ScoreForever/ChipDesign/hardware/asic/flow/README.md

# ASIC implementation flow

This directory contains the course-server TSMC 180 nm Genus, Innovus, and
Xcelium flow used for ASIC synthesis, place-and-route, and post-layout
simulation.

## Flow stages

1. Configure the PDK, standard-cell libraries, SRAM macro views, and project
   root in `config/`.
2. Synthesize `my_soc_top` with the Genus script in
   `hardware/soc/synth/scripts/synth_genus.tcl`. The mapped ASIC build selects
   two course SRAM macro instances with `NPU_USE_RA1SHD_MODEL` and
   `NPU_USE_RA1SHD_ACTIVATION` when `EDA_NPU_MODEL_SRAM=1`.
3. In a fresh Innovus session, source `pnr/scripts/init_pnr.tcl`, then run the
   floorplan/IO, power/placement, and CTS/route/export stages in order.
4. For the programmable NPU gate-level regression, use the
   [ASIC optimization flow](../optimize/README.md) and its `postlayout.py` entry point.

The checked-in lab4 floorplan/power scripts retain the historical single
`i_mainmem_i_mainmem` placement and power connection. They require adaptation
before use with the current CPU-less dual-SRAM design: place and power both
`i_control/i_model_store/i_sram` and `i_control/i_activation/i_sram`, using the
matching macro LEF/GDS and current netlist. These templates are not a validated
dual-macro PnR handoff. The 2 by 2 mm die target is an architecture estimate,
not a strict post-EDA area acceptance threshold for this change.

## Environment

The flow requires the course TSMC 180 nm PDK, IO library, SRAM timing/physical
views, and licensed Genus, Innovus, and Xcelium installations. These external
files are not included in the repository. Set `CHIPDESIGN_PROJECT_ROOT` when
the source checkout is staged outside the default relative location.

The scripts provide a reproducible course flow, not foundry signoff by
themselves. Review the target RTL revision, constraints, tool configuration,
and resulting DRC/LVS, multi-corner STA, IR/EM, DFT, and post-layout simulation
evidence before making a tapeout decision. A main-aligned historical baseline
report is available on the
[EDA results branch](https://github.com/ScoreForever/ChipDesign/blob/eda-results-main-align-20261021/POSTLAYOUT_METRICS_BASELINE_MAIN_ALIGN.md).
