ScoreForever/ChipDesign/output/npu-bottlenecks/20261108/findings.md

计数器13/14/15为优先级互斥的激活/权重/结果槽等待。它们与 issue、prepare 可分解 MAC 调度周期；model/activation wait-response、stall 等接口计数跨级重叠，禁止求和为总等待。逻辑 MAC 含卷积 padding 零值，不等于非零乘加数。PE为当前 ABI5 的4bit权重/激活格式，历史图片INT8标注不能用于解释现有实现。

结论：K8/1024点写回槽等待77.8%，与同逻辑MAC量K256/32点相差2.94倍；单点K1024权重等待79.8%。128层17元素ReLU链精确C=N²+113N；GTSRB首层激活等待51457周期占总模型40.1%。tile8使七模型慢20.9–53.4%。详细设计优先级见README。
