ScoreForever/ChipDesign/output/npu-timing/20261109/peek_summary.md

# EGo1 build summary

Result: PASS
Stage: complete; last completed stage: write_bitstream
Part: xc7a35tcsg324-1; top: fpga_top; CPU-less JTAG controller and programmable five-operator NPU
Clocking Wizard: 100 MHz input, 50 MHz output, locked enabled, reset disabled
Log: vivado.log

## Resources (latest available stage)

| Resource | Used | Available | Utilization (%) |
|---|---:|---:|---:|
| Slice LUTs | 18425 | 20800 | 88.58 |
| Slice Registers | 7466 | 41600 | 17.95 |
| Block RAM Tile | 4 | 50 | 8.00 |
| DSPs | 20 | 90 | 22.22 |
| MMCME2_ADV | 1 | 5 | 20.00 |

## Timing (latest available stage)

WNS: 0.533 ns; TNS: 0.000 ns; WHS: 0.028 ns

## Main SRAM mapping

N/A: CPU-less system uses NPU-local storage; no main SRAM

## Configuration/BRAM DRC

PASS at route: CFGBVS-1, REQP-1839, RBOR-1

## JTAG clock routing

Not applied
