ScoreForever/ChipDesign/docs/kws_tinycnn8_tiled/README.md

# TinyCNN-8 新阶段汇报材料

> 2026-10-14：本文保留对应阶段记录，不作为当前main的完整实现/验收说明。
> 此前GAP/Flat接口差异已由PR #5恢复Flat解决，最新架构见 [ARCHITECTURE.md](../ARCHITECTURE.md)；最新FPGA结果见 [FPGA_DRC_CLOSURE.md](../FPGA_DRC_CLOSURE.md)。

[成果与trade-off](REPORT.md) · [个人设计思考](THOUGHTS.md) · [五分钟讲稿](TALK.md)

图表和摘要来自通过完整验收的实测，不接受skip-units smoke。完整生成证据保留本地或CI artifacts。
