ScoreForever/ChipDesign/docs/tools/int4_v2_report_head.md

# INT4 无 CPU NPU v2：算子扩展、真实模型、架构探索与 ASIC 实现

分支 `feature/int4-v2`。本文由 `docs/tools/int4_v2_report.py` 从
`docs/validation/int4_v2/` 下的结果文件生成；表中每个数字都能对应到其中一个 JSON 文件。
机器可读汇总：`docs/validation/int4_v2_summary.json`。设计过程中的中间数据（优化阶段、面积演进、布局试验）见 `docs/INT4_V2_PROCESS.md`。

## 0. 结论

- **规格**：die 含 PAD 环 ≤ 1950 µm；两颗 RA1SHD_2048x32M8（各 8 KiB），模型与激活分开；4×8 INT4 阵列；50 MHz。
- **算子**：从 5 个扩到 7 个逻辑算子（Conv 含深度可分离与 1–7 矩形核、FC、MaxPool、AvgPool/GAP、Add、ReLU、Requant），
  每类融合都能单独开关；新增 u4 无符号激活张量。
- **模型**：7 个硬件友好模型在真实数据集上做 INT4 QAT，测试集精度全部来自与硬件逐位一致的整数推理（第 2 节），
  所有模型的若干测试帧都在 RTL 上开/关融合逐位核对。
- **芯片优化**：都以模型实测为依据（第 3、5、7 节）——单次舍入 Requant、u4 激活、紧凑参数、共享建立乘法器、
  向量化 element 引擎、行填充、单行深度可分离权重、双 Requant lane、原地 Add、JTAG 突发。
- **端到端**：每次推理的时间由 JTAG 传输主导；突发协议把线上时间和主机 RPC 次数都大幅降低（第 4 节）。
- **布局与签核**：SRAM 的 109 个信号引脚都在宏底边；新增让引脚朝向逻辑区的朝向和布局，并作为物理检查项。
  最终两颗 SRAM 分在西南、东北角（`diagonal_facing`），引脚边各自面向逻辑区；利用率 70%，die 1920 µm（上限 1950），PrimeTime setup +1.094 ns / hold +0.154 ns，Calibre DRC/LVS、Formality 和 Xcelium SDF 门级仿真全过（第 6 节）。
- **FPGA**：EGo1（XC7A35T）50 MHz 实现，7 个发布模型 112 帧在实板冷 / 热共 224 次推理逐字节一致；上板时发现的两处 RTL 问题（gather 关键路径、突发错误标志的 CDC）已修复并并入最终设计（第 5 节）。

## 1. 相对 ABI 3（INT4 v1）的改动

| 类别 | 改动 | 依据 |
|---|---|---|
| 算子 | 深度可分离卷积（复用阵列，权重装载时展开成块对角） | 8 KiB 模型 SRAM 下，DS 结构是参数最省的卷积 |
| 算子 | 1–7 的矩形核，1D 卷积原生运行 | HAR/ECG 1D 模型；KWS 7×3 前端 |
| 算子 | 独立 Max/Avg 池化任意窗口/步长；GAP；融合 1×2 池化 | ECG 1D 池化（v1 直接拒绝）；GAP 头 |
| 算子 | 残差 Add（两路 8-bit 整数权重），可原地写回任一操作数 | 残差块；原地可少占一个张量 |
| 融合 | 融合开关按种类或按头算子设置，单节点可关闭；池化/Add 后可融合 Requant/ReLU | 融合消融（第 3.5 节） |
| 数值 | Requant 单次舍入（v1 舍入两次） | 第一层约 8% 输出与实数结果差 1，QAT 无法对齐 |
| 数值 | u4 无符号激活（ReLU 后 0..15） | ReLU 后有符号 INT4 只剩 3 位；QAT 对比各模型 +1–2.5 个百分点 |
| 数值 | 参数一字一通道：18-bit bias + Q8 乘数 + 6-bit 移位 | Q8 与 Q15 全测试集精度相同；参数 SRAM 减半 |
| 吞吐 | 向量化 element 引擎：一次读 8 个 nibble 更新全部通道 | Add/GAP 占 10–34% 周期 |
| 吞吐 | 单通道窄核（kw≤4）行填充：每个 K 组一次连续读 | KWS 7×3 前端 67% 周期在等激活 |
| 吞吐 | 双 Requant lane，相邻两个 nibble 合并一次写回 | 等结果槽占 KWS 周期 24% |
| 容量 | 深度可分离权重每个 tap 只存一行（v2 首版存两份） | GTSRB 模型 8228 → 7688 B |
| 主机 | JTAG 突发写/读 IR（每字一次 32-bit 扫描），主机批量 RPC | 实板每次 RPC 4 ms，逐字协议每字 ≥3 次 RPC |
| 面积 | ~20 个建立阶段乘法器改为共享一个；写回地址增量计算；保留字取指时检查 | Genus 寄存器级面积分解 |
| 布局 | SRAM 可分别设置朝向与位置；最终对角摆放（`diagonal_facing`）；引脚朝向物理检查 | 宏引脚全在一条边上，v1 摆法两颗宏都背对逻辑 |

ABI 号 0x00040000；描述符格式、参数字和 trace 版本见 `docs/CPU_LESS_CONTROL.md` 与第 8 节。
