ScoreForever/ChipDesign/output/fpga-fit/findings.md

基线 38fdd73：33,901 / 20,800 Slice LUT，UTLZ-1 阻塞布局；最差路径 d_reg[4][2] → kernel_offset_reg[15]。候选保留 8×8、128 描述符、ABI 5.0，允许增加验证与每组启动周期。
最终候选 18,196 LUT，50 MHz setup +0.014 ns、hold +0.040 ns，七个发布模型仿真周期增加 63.32% 至 114.51%。
