ScoreForever/ChipDesign/output/fpga-fit/task_plan.md

# ABI 5.0 EGo1 FPGA 上板优化
- [x] 定位资源和关键路径。
- [x] 串行化张量元数据查找和内核行地址准备。
- [x] 运行 RTL/CDC 回归及远端 Vivado 实现。
- [x] 实现和 CDC 通过后上板验证。
