ScoreForever/ChipDesign/output/week8/progress.md

# 计划准备记录

- 2026-10-30：已按四个岗位和四个工作包形成分工、5日节奏及19项人工签核模板。
- 所有执行、复核与人工签名均待开展。本次仅完成计划，不运行实验、不修改RTL、不启动EDA或FPGA构建。
