ScoreForever/ChipDesign/output/week8/task_plan.md

# 下一周工作分工（讨论执行稿）

制定日期：2026-10-30。按5个工作日安排，岗位代号待替换为姓名。本文是计划，不代表验证已经完成或人工已经签核。

## 人员与职责

| 岗位 | 主责 | 本周明确交付物 | 交叉复核 |
|---|---|---|---|
| A：EDA主责 | 低精度面积评估、ASIC签核证据审核 | INT8/W4A8面积与时序对比；ASIC人工核查记录；缺失工艺输入清单 | B复核报告与例外，C确认RTL配置 |
| B：EDA机动 | 性能瓶颈评估主责、低精度软件筛选、证据汇总 | 同一基线的分算子瓶颈报告；精度/容量对比；下一轮候选排序；总问题清单 | C复核统计语义，D核对实板一致性，A复核方案成本 |
| C：RTL主责 | 稳定基线、低精度最小原型、功能与回归维护 | 冻结源码/配置清单；独立参考对照；一个低精度候选或停止结论；CDC缺陷修复与回归 | B复核数值契约，D独立验证CDC行为，A检查综合网表 |
| D：FPGA主责 | 最新基线实板验证、CDC专项验证与接口证据 | CDC场景矩阵/scoreboard结果；Vivado CDC与I/O审计；对应镜像的实板与性能记录 | C复核协议及复位语义，A复核物理约束，B复核证据身份 |

机动岗位B有固定的性能评估交付物，不作为无人负责的公共支援池。A负责签核清单维护，B负责证据索引和未闭合问题汇总。最终放行由指定人工负责人作出，不由工具PASS自动替代。

## 工作包1：低精度可行性，不预设本周必须完成INT4整机

- 主责：C（RTL），A（面积）；B负责软件精度筛选；D仅验证通过筛选的候选。
- 优先比较W8A8与W4A8：权重先降为4bit，激活仍为8bit。W4A4先作软件敏感性评估，不同时维护多个完整硬件分支。
- 使用固定训练权重、明确来源的验证集和相同预处理，记录任务精度。合成输入只能验证数值行为，不能证明模型任务精度。
- 区分“INT4数值放在INT8容器”和真正4bit存储/乘法实现。先明确有符号范围、舍入/裁剪、scale、符号扩展、尾通道与奇数长度打包；不能直接截低4bit。
- 保持bias和Q31量化契约；累加位宽另作范围分析，不把所有数据通路随意减半。
- A先形成同工艺库、同频率、同SRAM/trace配置的面积账本：MAC、部分和/结果槽、控制、缓存/队列、量化、两颗SRAM。若工具无法逐项可靠分解，标明范围和未知项。
- 先做局部计算模块综合，再决定是否推进完整核心综合。必须报告新增打包/解包和控制成本。
- 同规格两颗SRAM宏面积不会因权重降为4bit自动减半。逻辑权重容量节省、标准单元面积节省、Die面积节省分别报告；没有新PnR不能声称释放了多少整芯片面积。
- D2决策门：人工确定可接受精度损失、面积收益目标和周期退化上限。三项阈值未定时只能报告比较结果，不宣布候选可替换INT8基线。
- 本周验收：交付可复现对比与继续/停止建议。软件精度不达标、收益不足或时序不合格时，保留负结果，不强行合入。

## 工作包2：性能瓶颈与下一轮方案

- 主责B，C解释计数器/调度，D采集对应镜像证据，A评估面积与时序代价。
- 测试集：KWS、MNIST、HAR；补充Conv/FC/独立后处理小用例与容量边界。ECG的MaxPool1D限制单列，不伪造可运行数据。
- 冻结相同源码、模型、融合配置、列数、存储实现和trace配置；冷/热运行分开记录，主机传输时间与核心计算周期分开记录。
- 收集总周期、MAC issue、等待激活/权重/结果槽、gather类型、模型/激活读事务、逻辑写回与各缓冲峰值；有逐算子trace时按层定位。
- 按当前RTL核对计数语义，历史性能文档中写端无ready等叙述不能套用当前双SRAM版。等待计数不是总周期完整划分，不能直接相加绘制总时间占比；峰值占满不等于已证明瓶颈。
- 对最重要的1项假设做定向小实验，例如权重供给、激活gather、写回背压或后处理；一次只改变一个因素。没有测量则将收益标为估计。
- 交付：主要瓶颈及证据，最多2个下一轮候选；每个包含预期收益、面积/时序成本、修改范围、风险和验证方式。低精度不自动等于性能翻倍。

## 工作包3：当前No-CPU TAP/CDC专项

- D负责测试设计、执行和实板；C负责协议复核与RTL修复；A复核约束；B独立审阅覆盖与失败日志。
- 对象是当前npu_jtag_transport的稳定负载/toggle邮箱和两域复位，不使用旧CPU Debug/DMI流程代替。
- 功能矩阵：不同频率比与初始相位；请求/应答握手临界边沿；busy时新请求/overrun；TCK停止并重启；TMS TAP复位与全局复位区别；未决命令/未决响应时复位；watchdog取消后的重新提交；连续任务。
- scoreboard检查：每个被接受请求恰好执行一次，响应匹配，无丢失/重复/混包；在途payload稳定；busy拒绝的请求不被执行。复位取消的事务按明确协议处理，不能错误要求其仍应答或允许污染新任务。
- 仿真可随机频率/相位、背压及边界时刻，但RTL仿真不能证明模拟亚稳态风险消失。同步器、复位释放、物理时序约束和例外范围必须另查。
- 实板先按已验证的100kHz与1MHz配置覆盖，并记录实际OpenOCD设置；新增速率先确认I/O预算。50MHz系统时钟与TCK独立，不将烧板功能PASS代替CDC时序审核。
- 每个修复先回归，再重建FPGA镜像并重新审核时序/CDC/I/O。不能复用旧镜像证明新RTL通过。
- 本周验收：场景矩阵、明确预期、日志/断言/scoreboard结果和未覆盖项。高风险未解释CDC问题阻止将候选标为可发布。

## 工作包4：人工签核

- A维护manual_signoff_checklist.md，B汇总证据；C、D各自完成所属项并交叉复核。
- 每项绑定源码快照、工具版本、配置、输入与原始报告，人工抽查路径/波形/实际与期望数据，不能只核对汇总PASS。
- 人工状态：未核对、通过、有条件通过、不通过、不适用。缺输入应写未核对并列缺口，不得默认为通过；不适用需要理由与复核。
- 有条件通过必须写条件、剩余风险、责任人及后续动作；重要例外保留原始数量、位置、理由与影响。
- 本周目标是完成一次人工证据复核和剩余风险分配，不承诺一周内完成所有多角/IR/EM/工艺交付签核。

## 5个工作日节奏

| 时间 | A：EDA主责 | B：EDA机动 | C：RTL | D：FPGA |
|---|---|---|---|---|
| D1 | 面积分解、库/角落可用性与签核输入盘点 | 固定模型/数据集和性能统计口径 | 冻结含本地修改的源码快照，复跑INT8基线 | 确认镜像/下载记录，完成CDC测试矩阵 |
| D2 | 局部低精度综合对比 | 软件W4精度评估、分层瓶颈采样 | 完成数值/打包契约，支持最小原型 | CDC仿真及已有速率的接口测试 |
| D3 | 有价值候选完整综合，审核例外 | 主导一次瓶颈假设实验 | CDC必要修复及定向回归，候选功能对照 | 验证修复，重建需要更新的镜像 |
| D4 | 候选时序/面积复查与人工签核 | 汇总证据、候选排序与停止理由 | 整机回归，冻结候选输入 | 实板重复/恢复与性能对照、人工核查 |
| D5 | 与全组审核ASIC风险与后续输入 | 发布总报告、未闭合问题和下一轮建议 | 交付稳定基线与候选差异 | 交付镜像身份、实板报告和CDC覆盖 |

## 周末必须可审查的交付物

- [ ] 低精度精度/容量/综合面积/时序/周期对比，继续或停止建议。
- [ ] 同一基线的主要性能瓶颈证据及最多2项下一轮候选。
- [ ] No-CPU CDC覆盖矩阵、scoreboard/断言结果与物理约束审阅。
- [ ] 四人填写并交叉复核的人工签核表，含全部未闭合项。

## Next Step

把A/B/C/D替换为姓名，并在D1确定冻结快照、任务精度阈值及最终人工放行负责人。本文未启动任何实验或修改RTL。
