ScoreForever/ChipDesign/docs/kws_tinycnn8_tiled/TALK.md

# 五分钟汇报与问答

> 2026-10-14：本文为此前调度实验记录，周期数和通过结果限定于当时的源码/参数。
> 当前main的GAP核、MMIO参数缺口及Flat软件差异见 [当前架构](../ARCHITECTURE.md)，
> 最新FPGA结构与验证记录见 [FPGA_DRC_CLOSURE.md](../FPGA_DRC_CLOSURE.md)。

**0:00–0:45 目标。** 固定KWS-TinyCNN-8，复用现有32PE阵列，研究模型定向调度而不是新增网络。
合成参数用于数值和性能验证，不报告语音识别准确率。

**0:45–1:30 发现。** C2占多数乘加；原调度对每个位置每K组都重载并等待。先做gather/load
重叠得到11.12%，但剩余等待仍很高，所以不能只继续优化数据准备。

**1:30–2:30 设计。** 改为一个空间tile共用一组权重，逐位置发射同时回收，以tag写回各自
INT32部分和。换权重必须全部退休。保持计算与量化不变；单字节读口仍限制供数。

**2:30–3:30 结果。** 图中tile16整网51,821→30,395，减少41.35%，速度比1.705×；
C2速度比3.366×。1,440输入不变，权重行5,760→360。各层golden及正式MMIO均通过。

**3:30–4:15 Trade-off。** tile16主要数据存储584B，包含512B部分和、64Btag、8Bpack。
32更快但部分和翻倍；容量不是面积，待综合验证端口/选择网络/频率。没有宣称能耗降低。

**4:15–5:00 完成度与个人工作。** 以合同、数值、协议、性能、资源预算、接口及复现作为RTL出口。
我的工作是trace驱动的选择、控制实现和证据链；团队基础不重复归功。综合/真实模型/整机是下一关。

## 问答

- **为何认为完成？** 是限定存储与模型合同下RTL阶段完成，不是芯片完成；所有出口有测试证据。
- **为何不多加PE？** 供数和重复装载先成为限制，固定资源才能隔离调度收益。
- **为什么不用32？** 测得更快但多512B部分和，频率/面积尚未知，16是有理由的初选不是全局最优。
- **真实KWS识别好吗？** 未验证；合成权重没有类别语义。
- **SoC是否全跑了？** 正式MMIO后端已测，CPU+AXI+DMA整SoC本次未跑。
- **面积/功耗改善多少？** 尚无综合/实现数据，权重流量下降不能直接换算功耗。
