ScoreForever/ChipDesign/docs/kws_tinycnn8_tiled/THOUGHTS.md

# 个人贡献与设计思考（供汇报采用）

> 2026-10-14：本文为此前调度实验记录，周期数和通过结果限定于当时的源码/参数。
> 当前main的GAP核、MMIO参数缺口及Flat软件差异见 [当前架构](../ARCHITECTURE.md)，
> 最新FPGA结构与验证记录见 [FPGA_DRC_CLOSURE.md](../FPGA_DRC_CLOSURE.md)。

这是对实际工作及设计取舍的表达，不替代团队作者记录，不声明独立完成整个NPU。

## 我的工作边界

我依赖已有Matrix/Vector、TinyCNN和SoC基础，重点负责模型定向验证、trace分析、
调度优化实验、软件可读性能指标及阶段验收证据。核心贡献不是“首次仿真”，而是
把观察、选择、实现和验证闭合起来。

## 观察—选择—代价—验证

1. **先观察，不先扩阵列。** 8输出通道匹配8列；C2占大部分计算，trace显示大量单事务等待。
   增加PE可能无法持续供数，因此先固定计算资源，研究调度。
2. **第一步选择低风险重叠。** gather/load可在独立读口下并行，已经证明11.12%整网收益，
   但装载次数不变，瓶颈转为等待。它既是成果，也揭示下一步上限。
3. **第二步选择空间复用。** 同一K组权重可服务多个位置，代价是必须保存多个INT32部分和，
   并正确关联返回结果；不能简单先发满所有输入再接输出，否则流水可能堵死。
4. **控制工作集，而非全层展开。** C2完整im2col约5760B；全层psum约2560B，Conv1全层psum10240B。
   小tile使活跃部分和有界，不代表行为存储已变成物理SRAM。
5. **不把最大tile当自动最优。** 比较8/16/32：默认16用584B主要数据存储，取得1.705×整网周期速度比。
   32更快但存储更大，最终频率/面积可能改变最佳点，留待综合。
6. **不靠改数学获得快。** bias只一次、K间INT32、最终Q31双舍入不变；三路对独立golden。
   数据/权重恰零也不扣除有效工作，防止统计口径制造收益。
7. **把性能变成软件功能。** profiler使用显式事件端口，MMIO可读，独立monitor验证；
   以后换模型或存储仍能测，而不只是本次waveform截图。
8. **用出口定义完成度。** 达到数值、协议、机制、性能、资源预算和复现门槛，称RTL阶段完成。
   不声称PPA、真实准确率或整机已完成；这不是削弱成果，而是说明工程判断的边界。

## 可以直接说的贡献摘要

“我在团队已有计算模块上建立了独立逐层验证和周期级分析流程，根据trace定位Conv2
重复装载和单事务等待，设计了有界空间复用及回收调度。保持32个PE，tile16整网周期
减少41.35%，并将性能统计接入正式MMIO。我的关注点是收益、存储/控制代价和
验证完整度，而不是把仿真数字直接当作芯片PPA。”

## 不应说

从零原创全部NPU；真实KWS精度已验证；相对CPU有1.705倍加速；584B就是面积；
固定TB时钟就是Fmax；test PASS就是所有输入形式证明；已完成同步SRAM和整SoC联调。
