ScoreForever/ChipDesign/output/npu-bottlenecks/20261108/progress.md

2026-11-08：新增 profile_bottlenecks.py，未改生产 RTL。使用 SYNTHESIS、FPGA_MEM、8列、关闭波形、启用算子摘要；tile 仅测试 RTL 支持的16和8。初版分析器错误地用物化张量表查询被融合消除的中间张量，导致 KeyError；已改用逻辑参考结果计算工作量，失败证据保留 build/bottlenecks_20261108，修正版在 build/bottlenecks_20261108_checked 运行。

完成：52组常规对照、40组极限测试共184次执行；逐写回和两次计数校验通过，七模型默认tile周期与此前实板逐次一致。新增预编译工作负载检查，避免容量/维度不支持时启动长回归。原始极限输入单维256/1024超255上限，修为同元素二维形状后全部通过。代码py_compile与git diff --check通过。生产RTL哈希在两套回归及报告生成前后核对一致，未提交。mywin再次SSH超时，本轮无新板测/时序签核。
