ScoreForever/ChipDesign/output/npu-bottlenecks/20261108/task_plan.md

# 当前 ABI 5.0、8×8 NPU 瓶颈测量

- [x] 检查计数器定义和测试入口；保持生产 RTL 不变。
- [x] 七模型和单变量工作负载测量，每例两次并检查全部写回。
- [x] 对照 tile=16/8 和融合开关，核对实板周期。
- [x] 输出瓶颈排序、时序限制、复现命令及数据范围。

远端 mywin SSH 超时，本轮使用本地生产存储配置 RTL 仿真和此前布线/实板证据。
