ScoreForever/ChipDesign/output/npu-gather/20261108/findings.md

根因：跨kernel行或padding边界的组不满足全组连续条件时，原实现逐lane读取，未利用同一返回字内的其他有效lane。现在按归一化offset相等划分连续子集，每次读后清除该子集待处理mask，下一请求选择剩余首lane。最后一个子集仍可同周期直接送MAC；完整连续组仍仅一次读。生产RTL仅core改变，其余起点未提交改动保留。

最终状态：采用checkout_forward/build/gather_forward_50mhz，首轮标准route通过（无负余量重试）；WNS+.031/WHS+.034，LUT18464/DSP12。132动态CDC+109端点复核通过，已上板14次模型及5恢复检查全过，全部24计数与生产RTL一致。GTSRB128283->95147；最终SHA535c93afe24ab10f02b424a4a8a9d6918e01d9c56165572fb84e6b82336d6350。报告README.md为最终结论；早期进行中描述由本结果取代。setup余量较旧镜像+.344小，已明确披露。
