ScoreForever/ChipDesign/output/npu-gather/20261108/progress.md

2026-11-08：4通道3x3用例起点1550周期/582请求/710激活等待；新实现1027周期/330请求/187等待，性能预算1050与读预算340通过。81程序回归、13边界专项、8直接/JTAG端到端及19组负向/生命周期检查通过；七模型生产配置重放通过。GTSRB128283->95147，其他六模型无回退。当前remote staging C:/Users/Lenovo/AppData/Local/Temp/chipdesign_nocpu_ww974e_1，远端根D:/IWS/advanced_soc/ChipDesign/build/fpga_signoff/npu_gather_20261108/checkout，build/gather_50mhz。旧VivadoGUI40204保留，本轮进程55320。

第一版初始route WNS=-0.986/WHS=+0.032，自动AggressiveExplore进行中（~-.654）。增加一个gather_last寄存器，将子集完成归约提前到请求前，避免返回到下一读请求路径；81项程序及13边界通过，所有周期/24计数逐例与第一版相同。新远端checkout_retime/build/gather_retime_50mhz，stage C:/Users/Lenovo/AppData/Local/Temp/chipdesign_nocpu_2v9ii684。第一版完整core保留chunk_core.sv，起点before_core.sv。当前工作区为retime候选，未上板。

按用户反馈转向RTL结构优化：第一版正式routePASS WNS0.000/WHS+.059/LUT18520；route路径源pool1d到held_data约25级，含next_base两段串行carry。终止已核对cmdline的retime候选PID49944、margin候选PID9388，保留日志；旧GUI40204未动。当前workspace为chunk+cursor_step[8]预计算，已去掉无效gather_last尝试。81项全部周期/24计数与第一版一致。构建入口一次在前置归档失败后错误继续，启动了未覆盖源码clone的h9ulr062/PID19284，已停止并保留失败目录gather_steps_50mhz；重试入口build_frozen.py先校验20个输入哈希才启动。正式steps构建checkout_steps/build/gather_steps_retry_50mhz，staging C:/Users/Lenovo/AppData/Local/Temp/chipdesign_nocpu_lerm0pfg，SSHsession75377。

步进表版最终routePASS WNS+.014/WHS+.039/LUT19078/DSP12；改善但余量偏紧。继续RTL并行forward：物理slot并行地址匹配，按head分段选最新nibble，避免环形data索引与8级串行overlay。独立18432组合miter旧/新均通过，强制before_head=0在head1/count8被检出；mutant源删除，日志保留。完整81程序cycles/24perf与steps逐例相等，unit含500随机mask、容量wrap/RMW/held snapshot及压力检查通过；新tb已加入run_program_regression.unit_tests。forward冻结20源已校验，checkout_forward/build/gather_forward_50mhz，stage chipdesign_nocpu_mcx2e1pc，SSH4198。后续production7/edges15/JTAG8/native18运行中。侧聊已完成96次TCK扫频并明确释放FT232H，仍须本线程路由+CDC门禁后才能上板。

最终验收完成：forward标准流程仅一次route，未触发负余量重试。50MHz WNS+.031/WHS+.034/TNS0/THS0，LUT18464/88.77%、FF7263、DSP12、BRAM4。132动态CDC及109端点复核通过，源码及bit SHA535c93afe24ab10f02b424a4a8a9d6918e01d9c56165572fb84e6b82336d6350核对后已编程EGo1（DONE1/CRC0）。恢复FT232H2-3/serial210512180081的WSL挂载及plugdev660后，14模型输出/周期/24计数与RTL完全一致、5板级CDC/恢复通过；OpenOCD正常退出，owned keepalive已到期。全部证据下载校验，当前本地构建输入与最终provenance完全一致。余量仍小于11月7日+.344，报告如实记录。未提交/推送。
