ScoreForever/ChipDesign/output/npu-timing/20261109/task_plan.md

# RTL 时序余量恢复

目标：ABI5.0、8×8保持；七模型周期不得高于当前上板值；50MHz尽量恢复WNS≥+0.344ns。时序与同镜像CDC通过后上板。

- [x] 冻结+0.031ns已上板基线并分析关键路径。
- [x] 行尾/非行尾元数据并行计算，功能与周期对照。
- [x] 隔离副本完整50MHz实现，比较实际路由余量与面积。
- [x] 同镜像CDC、上板14次模型/5恢复验证及归档。

不修改50MHz时钟约束，不通过增加逐读请求周期换时序。当前候选只改core，旧工作区改动保留。

最终选择：影子游标+完整请求metadata寄存器；WNS+.533/WHS+.028，CDC通过，板上14模型运行+5恢复检查通过，全部24计数一致。详见README.md。
