ScoreForever/ChipDesign/docs/slides/int4_v2/data/signoff.tex

Calibre DRC & \textcolor{peking_darkgreen}{通过} & 无阻塞违例；报告项均为 IO 单元内的 ESD/闩锁指导规则 \\
Calibre LVS & \textcolor{peking_darkgreen}{通过} & 网表一致；45 处 IO 电阻属性偏差（最大 3.47\%），已接受 \\
PrimeTime STA & \textcolor{peking_darkgreen}{通过} & SPEF 反标：setup +1.094 ns，hold +0.154 ns \\
Formality LEC & \textcolor{peking_darkgreen}{通过} & 布线后网表与综合网表等价 \\
Xcelium SDF gate-level & \textcolor{peking_darkgreen}{通过} & 门级 + SDF 跑通 41 条 JTAG 命令（突发 IR，覆盖全部新算子） \\
