ScoreForever/ChipDesign/docs/validation/eda_latest_20261111/reports/cdc_paths.tsv

kind | from | to | mode | arrival_ns | required_ns | slack_ns
request | i_host/req_payload_reg[0]/Q | i_host/cmd_data_o_reg[0]/D | late | 0.000 | 19.974 | 19.973
request | i_host/req_payload_reg[1]/Q | i_host/cmd_data_o_reg[1]/D | late | 0.000 | 19.977 | 19.976
request | i_host/req_payload_reg[2]/Q | i_host/cmd_data_o_reg[2]/D | late | 0.000 | 19.974 | 19.974
request | i_host/req_payload_reg[3]/Q | i_host/cmd_data_o_reg[3]/D | late | 0.001 | 19.973 | 19.972
request | i_host/req_payload_reg[4]/Q | i_host/cmd_data_o_reg[4]/D | late | 0.000 | 19.975 | 19.974
request | i_host/req_payload_reg[5]/Q | i_host/cmd_data_o_reg[5]/D | late | 0.001 | 19.970 | 19.969
request | i_host/req_payload_reg[6]/Q | i_host/cmd_data_o_reg[6]/D | late | 0.001 | 19.973 | 19.972
request | i_host/req_payload_reg[7]/Q | i_host/cmd_data_o_reg[7]/D | late | 0.000 | 19.978 | 19.978
request | i_host/req_payload_reg[8]/Q | i_host/cmd_data_o_reg[8]/D | late | 0.000 | 19.978 | 19.978
request | i_host/req_payload_reg[9]/Q | i_host/cmd_data_o_reg[9]/D | late | 0.000 | 19.970 | 19.970
request | i_host/req_payload_reg[10]/Q | i_host/cmd_data_o_reg[10]/D | late | 0.000 | 19.977 | 19.977
request | i_host/req_payload_reg[11]/Q | i_host/cmd_data_o_reg[11]/D | late | 0.000 | 19.977 | 19.977
request | i_host/req_payload_reg[12]/Q | i_host/cmd_data_o_reg[12]/D | late | 0.000 | 19.976 | 19.976
request | i_host/req_payload_reg[13]/Q | i_host/cmd_data_o_reg[13]/D | late | 0.000 | 19.972 | 19.972
request | i_host/req_payload_reg[14]/Q | i_host/cmd_data_o_reg[14]/D | late | 0.000 | 19.977 | 19.977
request | i_host/req_payload_reg[15]/Q | i_host/cmd_data_o_reg[15]/D | late | 0.001 | 19.972 | 19.971
request | i_host/req_payload_reg[16]/Q | i_host/cmd_data_o_reg[16]/D | late | 0.000 | 19.976 | 19.976
request | i_host/req_payload_reg[17]/Q | i_host/cmd_data_o_reg[17]/D | late | 0.001 | 19.973 | 19.972
request | i_host/req_payload_reg[18]/Q | i_host/cmd_data_o_reg[18]/D | late | 0.000 | 19.976 | 19.976
request | i_host/req_payload_reg[19]/Q | i_host/cmd_data_o_reg[19]/D | late | 0.001 | 19.972 | 19.971
request | i_host/req_payload_reg[20]/Q | i_host/cmd_data_o_reg[20]/D | late | 0.000 | 19.977 | 19.977
request | i_host/req_payload_reg[21]/Q | i_host/cmd_data_o_reg[21]/D | late | 0.001 | 19.972 | 19.971
request | i_host/req_payload_reg[22]/Q | i_host/cmd_data_o_reg[22]/D | late | 0.001 | 19.973 | 19.972
request | i_host/req_payload_reg[23]/Q | i_host/cmd_data_o_reg[23]/D | late | 0.000 | 19.976 | 19.976
request | i_host/req_payload_reg[24]/Q | i_host/cmd_data_o_reg[24]/D | late | 0.000 | 19.976 | 19.976
request | i_host/req_payload_reg[25]/Q | i_host/cmd_data_o_reg[25]/D | late | 0.000 | 19.975 | 19.975
request | i_host/req_payload_reg[26]/Q | i_host/cmd_data_o_reg[26]/D | late | 0.000 | 19.977 | 19.977
request | i_host/req_payload_reg[27]/Q | i_host/cmd_data_o_reg[27]/D | late | 0.001 | 19.972 | 19.971
request | i_host/req_payload_reg[28]/Q | i_host/cmd_data_o_reg[28]/D | late | 0.000 | 19.975 | 19.975
request | i_host/req_payload_reg[29]/Q | i_host/cmd_data_o_reg[29]/D | late | 0.001 | 19.974 | 19.973
request | i_host/req_payload_reg[30]/Q | i_host/cmd_data_o_reg[30]/D | late | 0.000 | 19.975 | 19.974
request | i_host/req_payload_reg[31]/Q | i_host/cmd_data_o_reg[31]/D | late | 0.000 | 19.974 | 19.973
request | i_host/req_payload_reg[32]/Q | i_host/cmd_addr_o_reg[0]/D | late | 0.001 | 19.967 | 19.967
request | i_host/req_payload_reg[33]/Q | i_host/cmd_addr_o_reg[1]/D | late | 0.000 | 19.970 | 19.970
request | i_host/req_payload_reg[34]/Q | i_host/cmd_addr_o_reg[2]/D | late | 0.001 | 19.970 | 19.970
request | i_host/req_payload_reg[35]/Q | i_host/cmd_addr_o_reg[3]/D | late | 0.000 | 19.974 | 19.974
request | i_host/req_payload_reg[36]/Q | i_host/cmd_addr_o_reg[4]/D | late | 0.001 | 19.969 | 19.968
request | i_host/req_payload_reg[37]/Q | i_host/cmd_addr_o_reg[5]/D | late | 0.000 | 19.973 | 19.972
request | i_host/req_payload_reg[38]/Q | i_host/cmd_addr_o_reg[6]/D | late | 0.001 | 19.970 | 19.969
request | i_host/req_payload_reg[39]/Q | i_host/cmd_addr_o_reg[7]/D | late | 0.001 | 19.969 | 19.968
request | i_host/req_payload_reg[40]/Q | i_host/cmd_addr_o_reg[8]/D | late | 0.001 | 19.970 | 19.969
request | i_host/req_payload_reg[41]/Q | i_host/cmd_addr_o_reg[9]/D | late | 0.001 | 19.969 | 19.968
request | i_host/req_payload_reg[42]/Q | i_host/cmd_addr_o_reg[10]/D | late | 0.001 | 19.965 | 19.964
request | i_host/req_payload_reg[43]/Q | i_host/cmd_addr_o_reg[11]/D | late | 0.001 | 19.969 | 19.968
request | i_host/req_payload_reg[44]/Q | i_host/cmd_addr_o_reg[12]/D | late | 0.001 | 19.967 | 19.966
request | i_host/req_payload_reg[45]/Q | i_host/cmd_addr_o_reg[13]/D | late | 0.001 | 19.967 | 19.967
request | i_host/req_payload_reg[46]/Q | i_host/cmd_addr_o_reg[14]/D | late | 0.001 | 19.968 | 19.967
request | i_host/req_payload_reg[47]/Q | i_host/cmd_addr_o_reg[15]/D | late | 0.001 | 19.964 | 19.963
request | i_host/req_payload_reg[48]/Q | i_host/cmd_addr_o_reg[16]/D | late | 0.001 | 19.962 | 19.961
request | i_host/req_payload_reg[49]/Q | i_host/cmd_addr_o_reg[17]/D | late | 0.001 | 19.962 | 19.961
request | i_host/req_payload_reg[50]/Q | i_host/cmd_addr_o_reg[18]/D | late | 0.002 | 19.963 | 19.960
request | i_host/req_payload_reg[51]/Q | i_host/cmd_addr_o_reg[19]/D | late | 0.001 | 19.968 | 19.967
request | i_host/req_payload_reg[52]/Q | i_host/cmd_addr_o_reg[20]/D | late | 0.001 | 19.967 | 19.966
request | i_host/req_payload_reg[53]/Q | i_host/cmd_addr_o_reg[21]/D | late | 0.001 | 19.967 | 19.967
request | i_host/req_payload_reg[54]/Q | i_host/cmd_addr_o_reg[22]/D | late | 0.001 | 19.968 | 19.967
request | i_host/req_payload_reg[55]/Q | i_host/cmd_addr_o_reg[23]/D | late | 0.000 | 19.973 | 19.972
request | i_host/req_payload_reg[56]/Q | i_host/cmd_addr_o_reg[24]/D | late | 0.000 | 19.972 | 19.972
request | i_host/req_payload_reg[57]/Q | i_host/cmd_addr_o_reg[25]/D | late | 0.000 | 19.972 | 19.972
request | i_host/req_payload_reg[58]/Q | i_host/cmd_addr_o_reg[26]/D | late | 0.000 | 19.971 | 19.971
request | i_host/req_payload_reg[59]/Q | i_host/cmd_addr_o_reg[27]/D | late | 0.001 | 19.969 | 19.969
request | i_host/req_payload_reg[60]/Q | i_host/cmd_addr_o_reg[28]/D | late | 0.001 | 19.969 | 19.969
request | i_host/req_payload_reg[61]/Q | i_host/cmd_addr_o_reg[29]/D | late | 0.000 | 19.966 | 19.966
request | i_host/req_payload_reg[62]/Q | i_host/cmd_addr_o_reg[30]/D | late | 0.001 | 19.970 | 19.969
request | i_host/req_payload_reg[63]/Q | i_host/cmd_addr_o_reg[31]/D | late | 0.001 | 19.966 | 19.965
request | i_host/req_payload_reg[64]/Q | i_host/cmd_op_o_reg[0]/D | late | 0.000 | 19.976 | 19.976
request | i_host/req_payload_reg[65]/Q | i_host/cmd_op_o_reg[1]/D | late | 0.001 | 19.967 | 19.966
request | i_host/req_payload_reg[66]/Q | i_host/cmd_op_o_reg[2]/D | late | 0.001 | 19.973 | 19.972
request | i_host/req_payload_reg[67]/Q | i_host/cmd_op_o_reg[3]/D | late | 0.000 | 19.977 | 19.977
request | i_host/req_payload_reg[68]/Q | i_host/cmd_op_o_reg[4]/D | late | 0.000 | 19.976 | 19.976
request | i_host/req_payload_reg[69]/Q | i_host/cmd_op_o_reg[5]/D | late | 0.000 | 19.974 | 19.973
request | i_host/req_payload_reg[70]/Q | i_host/cmd_op_o_reg[6]/D | late | 0.000 | 19.976 | 19.975
request | i_host/req_payload_reg[71]/Q | i_host/cmd_op_o_reg[7]/D | late | 0.000 | 19.975 | 19.975
response | i_host/rsp_mailbox_data_reg[0]/Q | i_host/reply_data_reg[0]/D | late | 0.000 | 19.979 | 19.979
response | i_host/rsp_mailbox_data_reg[1]/Q | i_host/reply_data_reg[1]/D | late | 0.000 | 19.976 | 19.976
response | i_host/rsp_mailbox_data_reg[2]/Q | i_host/reply_data_reg[2]/D | late | 0.000 | 19.978 | 19.978
response | i_host/rsp_mailbox_data_reg[3]/Q | i_host/reply_data_reg[3]/D | late | 0.000 | 19.978 | 19.978
response | i_host/rsp_mailbox_data_reg[4]/Q | i_host/reply_data_reg[4]/D | late | 0.000 | 19.979 | 19.979
response | i_host/rsp_mailbox_data_reg[5]/Q | i_host/reply_data_reg[5]/D | late | 0.000 | 19.977 | 19.976
response | i_host/rsp_mailbox_data_reg[6]/Q | i_host/reply_data_reg[6]/D | late | 0.000 | 19.978 | 19.978
response | i_host/rsp_mailbox_data_reg[7]/Q | i_host/reply_data_reg[7]/D | late | 0.000 | 19.979 | 19.978
response | i_host/rsp_mailbox_data_reg[8]/Q | i_host/reply_data_reg[8]/D | late | 0.000 | 19.979 | 19.979
response | i_host/rsp_mailbox_data_reg[9]/Q | i_host/reply_data_reg[9]/D | late | 0.000 | 19.978 | 19.978
response | i_host/rsp_mailbox_data_reg[10]/Q | i_host/reply_data_reg[10]/D | late | 0.000 | 19.979 | 19.979
response | i_host/rsp_mailbox_data_reg[11]/Q | i_host/reply_data_reg[11]/D | late | 0.000 | 19.978 | 19.978
response | i_host/rsp_mailbox_data_reg[12]/Q | i_host/reply_data_reg[12]/D | late | 0.000 | 19.976 | 19.976
response | i_host/rsp_mailbox_data_reg[13]/Q | i_host/reply_data_reg[13]/D | late | 0.000 | 19.978 | 19.977
response | i_host/rsp_mailbox_data_reg[14]/Q | i_host/reply_data_reg[14]/D | late | 0.000 | 19.979 | 19.978
response | i_host/rsp_mailbox_data_reg[15]/Q | i_host/reply_data_reg[15]/D | late | 0.000 | 19.977 | 19.976
response | i_host/rsp_mailbox_data_reg[16]/Q | i_host/reply_data_reg[16]/D | late | 0.000 | 19.977 | 19.977
response | i_host/rsp_mailbox_data_reg[17]/Q | i_host/reply_data_reg[17]/D | late | 0.000 | 19.977 | 19.977
response | i_host/rsp_mailbox_data_reg[18]/Q | i_host/reply_data_reg[18]/D | late | 0.000 | 19.977 | 19.976
response | i_host/rsp_mailbox_data_reg[19]/Q | i_host/reply_data_reg[19]/D | late | 0.000 | 19.977 | 19.976
response | i_host/rsp_mailbox_data_reg[20]/Q | i_host/reply_data_reg[20]/D | late | 0.000 | 19.979 | 19.979
response | i_host/rsp_mailbox_data_reg[21]/Q | i_host/reply_data_reg[21]/D | late | 0.000 | 19.977 | 19.977
response | i_host/rsp_mailbox_data_reg[22]/Q | i_host/reply_data_reg[22]/D | late | 0.000 | 19.979 | 19.979
response | i_host/rsp_mailbox_data_reg[23]/Q | i_host/reply_data_reg[23]/D | late | 0.000 | 19.978 | 19.978
response | i_host/rsp_mailbox_data_reg[24]/Q | i_host/reply_data_reg[24]/D | late | 0.000 | 19.977 | 19.977
response | i_host/rsp_mailbox_data_reg[25]/Q | i_host/reply_data_reg[25]/D | late | 0.000 | 19.977 | 19.977
response | i_host/rsp_mailbox_data_reg[26]/Q | i_host/reply_data_reg[26]/D | late | 0.000 | 19.976 | 19.976
response | i_host/rsp_mailbox_data_reg[27]/Q | i_host/reply_data_reg[27]/D | late | 0.000 | 19.979 | 19.979
response | i_host/rsp_mailbox_data_reg[28]/Q | i_host/reply_data_reg[28]/D | late | 0.000 | 19.979 | 19.979
response | i_host/rsp_mailbox_data_reg[29]/Q | i_host/reply_data_reg[29]/D | late | 0.000 | 19.980 | 19.980
response | i_host/rsp_mailbox_data_reg[30]/Q | i_host/reply_data_reg[30]/D | late | 0.000 | 19.980 | 19.980
response | i_host/rsp_mailbox_data_reg[31]/Q | i_host/reply_data_reg[31]/D | late | 0.000 | 19.980 | 19.979
response | i_host/rsp_mailbox_error_reg[0]/Q | i_host/reply_error_reg[0]/D | late | 0.001 | 19.972 | 19.971
response | i_host/rsp_mailbox_error_reg[1]/Q | i_host/reply_error_reg[1]/D | late | 0.001 | 19.974 | 19.974
response | i_host/rsp_mailbox_error_reg[2]/Q | i_host/reply_error_reg[2]/D | late | 0.001 | 19.975 | 19.975
response | i_host/rsp_mailbox_error_reg[3]/Q | i_host/reply_error_reg[3]/D | late | 0.001 | 19.973 | 19.973
response | i_host/rsp_mailbox_error_reg[4]/Q | i_host/reply_error_reg[4]/D | late | 0.000 | 19.975 | 19.975
req_sync | i_host/req_sync_reg[0]/Q | i_host/req_sync_reg[1]/D | late | NA | NA | 19.326
req_sync | i_host/req_sync_reg[0]/Q | i_host/req_sync_reg[1]/D | early | NA | NA | 0.133
ack_sync | i_host/ack_sync_reg[0]/Q | i_host/ack_sync_reg[1]/D | late | NA | NA | 999.276
ack_sync | i_host/ack_sync_reg[0]/Q | i_host/ack_sync_reg[1]/D | early | NA | NA | 0.194
