ScoreForever/ChipDesign/docs/validation/eda_latest_20261111/reports/database_geometry.tsv

die | {0.0 0.0 1940.4 1940.4}
core | {150.08 150.08 1790.32 1790.32}
