ScoreForever/ChipDesign/docs/validation/eda_latest_20261111/reports/synthesis_cdc_paths.tsv

kind | from | to | mode | slack_ns
request | i_host/req_payload_reg[0]/Q | i_host/cmd_data_o_reg[0]/D | late | 19.7461
request | i_host/req_payload_reg[1]/Q | i_host/cmd_data_o_reg[1]/D | late | 19.7461
request | i_host/req_payload_reg[2]/Q | i_host/cmd_data_o_reg[2]/D | late | 19.7461
request | i_host/req_payload_reg[3]/Q | i_host/cmd_data_o_reg[3]/D | late | 19.7461
request | i_host/req_payload_reg[4]/Q | i_host/cmd_data_o_reg[4]/D | late | 19.7461
request | i_host/req_payload_reg[5]/Q | i_host/cmd_data_o_reg[5]/D | late | 19.7461
request | i_host/req_payload_reg[6]/Q | i_host/cmd_data_o_reg[6]/D | late | 19.7461
request | i_host/req_payload_reg[7]/Q | i_host/cmd_data_o_reg[7]/D | late | 19.7461
request | i_host/req_payload_reg[8]/Q | i_host/cmd_data_o_reg[8]/D | late | 19.7461
request | i_host/req_payload_reg[9]/Q | i_host/cmd_data_o_reg[9]/D | late | 19.7461
request | i_host/req_payload_reg[10]/Q | i_host/cmd_data_o_reg[10]/D | late | 19.7461
request | i_host/req_payload_reg[11]/Q | i_host/cmd_data_o_reg[11]/D | late | 19.7461
request | i_host/req_payload_reg[12]/Q | i_host/cmd_data_o_reg[12]/D | late | 19.7461
request | i_host/req_payload_reg[13]/Q | i_host/cmd_data_o_reg[13]/D | late | 19.7461
request | i_host/req_payload_reg[14]/Q | i_host/cmd_data_o_reg[14]/D | late | 19.7461
request | i_host/req_payload_reg[15]/Q | i_host/cmd_data_o_reg[15]/D | late | 19.7461
request | i_host/req_payload_reg[16]/Q | i_host/cmd_data_o_reg[16]/D | late | 19.7461
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
response | i_host/rsp_mailbox_data_reg[25]/Q | i_host/reply_data_reg[25]/D | late | 19.946099999999998
response | i_host/rsp_mailbox_data_reg[26]/Q | i_host/reply_data_reg[26]/D | late | 19.946099999999998
response | i_host/rsp_mailbox_data_reg[27]/Q | i_host/reply_data_reg[27]/D | late | 19.946099999999998
response | i_host/rsp_mailbox_data_reg[28]/Q | i_host/reply_data_reg[28]/D | late | 19.946099999999998
response | i_host/rsp_mailbox_data_reg[29]/Q | i_host/reply_data_reg[29]/D | late | 19.946099999999998
response | i_host/rsp_mailbox_data_reg[30]/Q | i_host/reply_data_reg[30]/D | late | 19.946099999999998
response | i_host/rsp_mailbox_data_reg[31]/Q | i_host/reply_data_reg[31]/D | late | 19.946099999999998
response | i_host/rsp_mailbox_error_reg[0]/Q | i_host/reply_error_reg[0]/D | late | 19.946099999999998
response | i_host/rsp_mailbox_error_reg[1]/Q | i_host/reply_error_reg[1]/D | late | 19.946099999999998
response | i_host/rsp_mailbox_error_reg[2]/Q | i_host/reply_error_reg[2]/D | late | 19.946099999999998
response | i_host/rsp_mailbox_error_reg[3]/Q | i_host/reply_error_reg[3]/D | late | 19.946099999999998
response | i_host/rsp_mailbox_error_reg[4]/Q | i_host/reply_error_reg[4]/D | late | 19.946099999999998
req_sync | i_host/req_sync_reg[0]/Q | i_host/req_sync_reg[1]/D | late | 19.4769
ack_sync | i_host/ack_sync_reg[0]/Q | i_host/ack_sync_reg[1]/D | late | 999.6762
