ScoreForever/ChipDesign/docs/slides/int4_v2/figs/1_placement.png

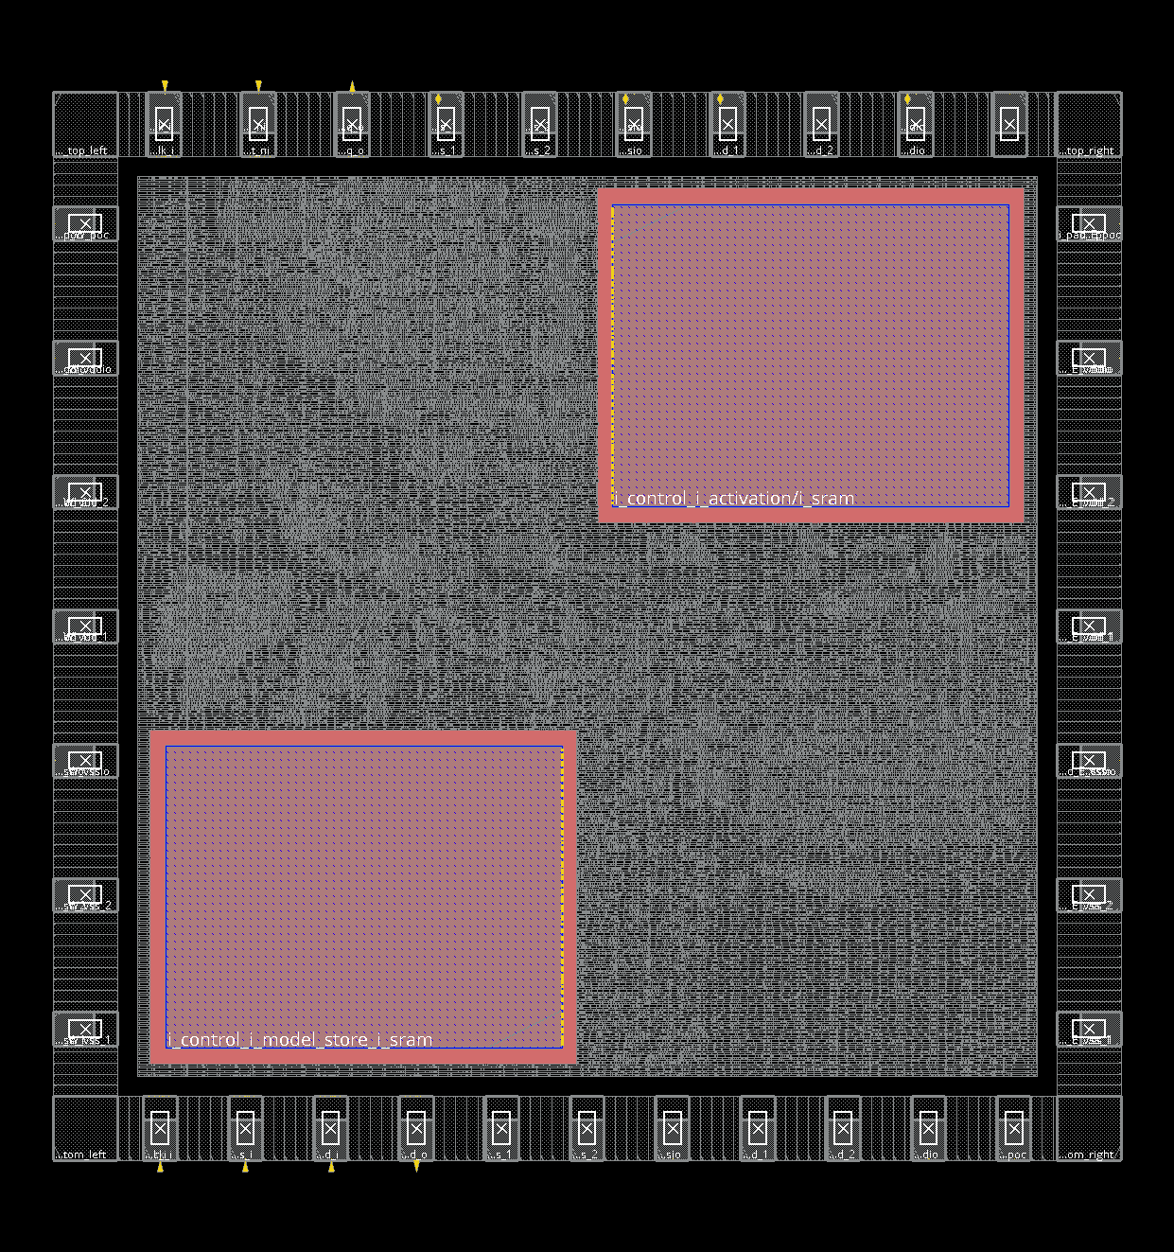
docs/slides/int4_v2/figs/1_placement.png
