ScoreForever/ChipDesign/docs/slides/int4_v2/figs/6_sram_pins.png

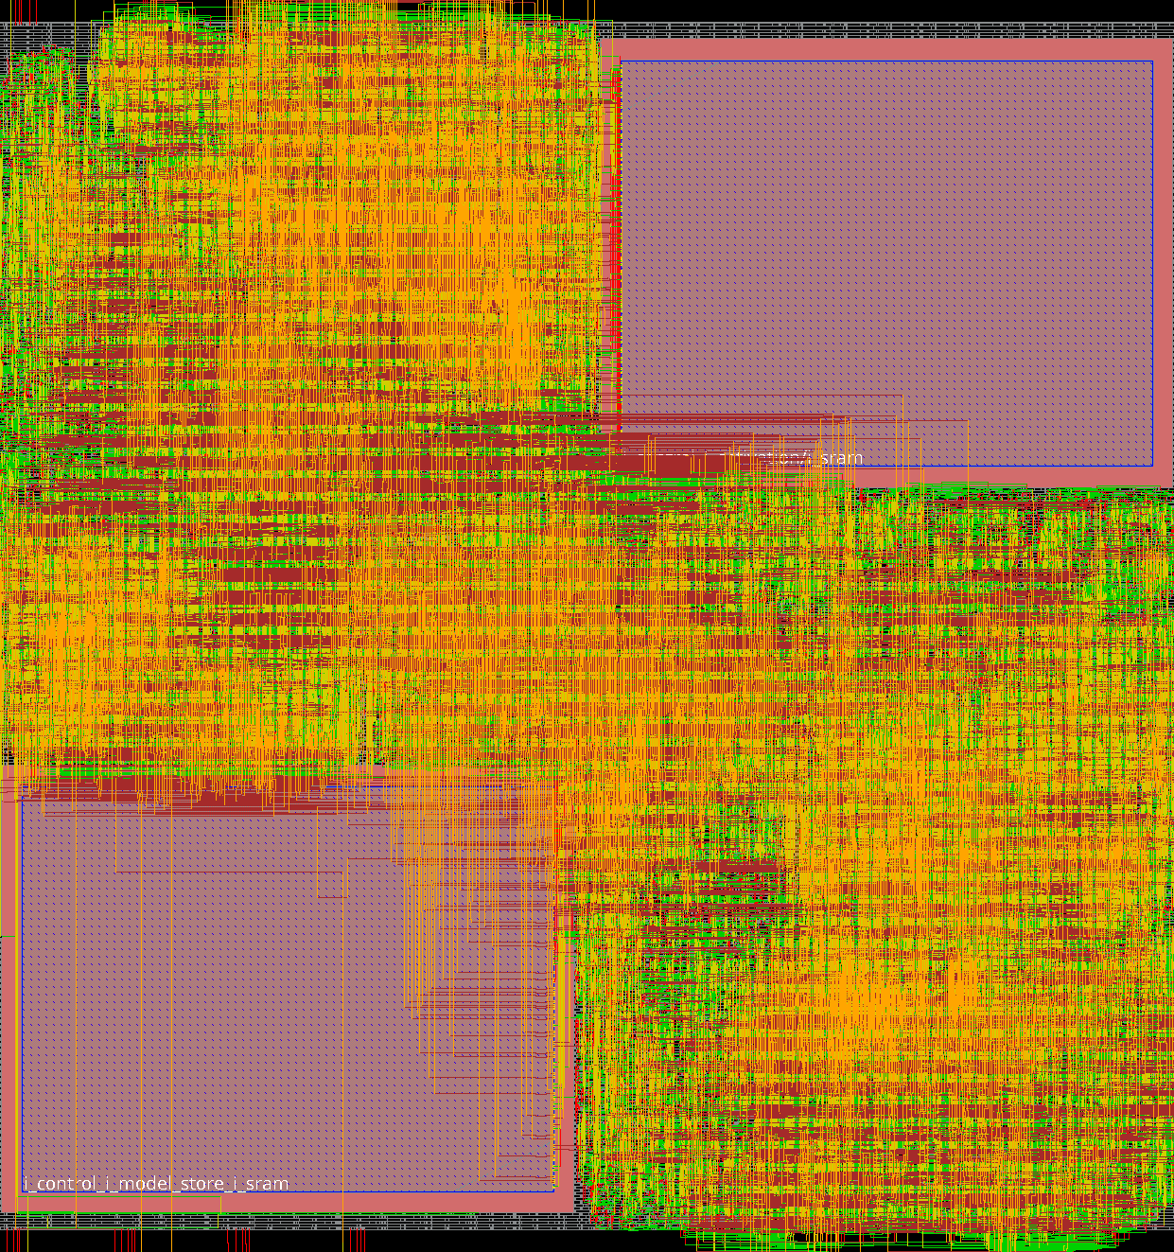
docs/slides/int4_v2/figs/6_sram_pins.png
