ScoreForever/ChipDesign/output/architecture/soc_npu_chinese_corrected_v3.png

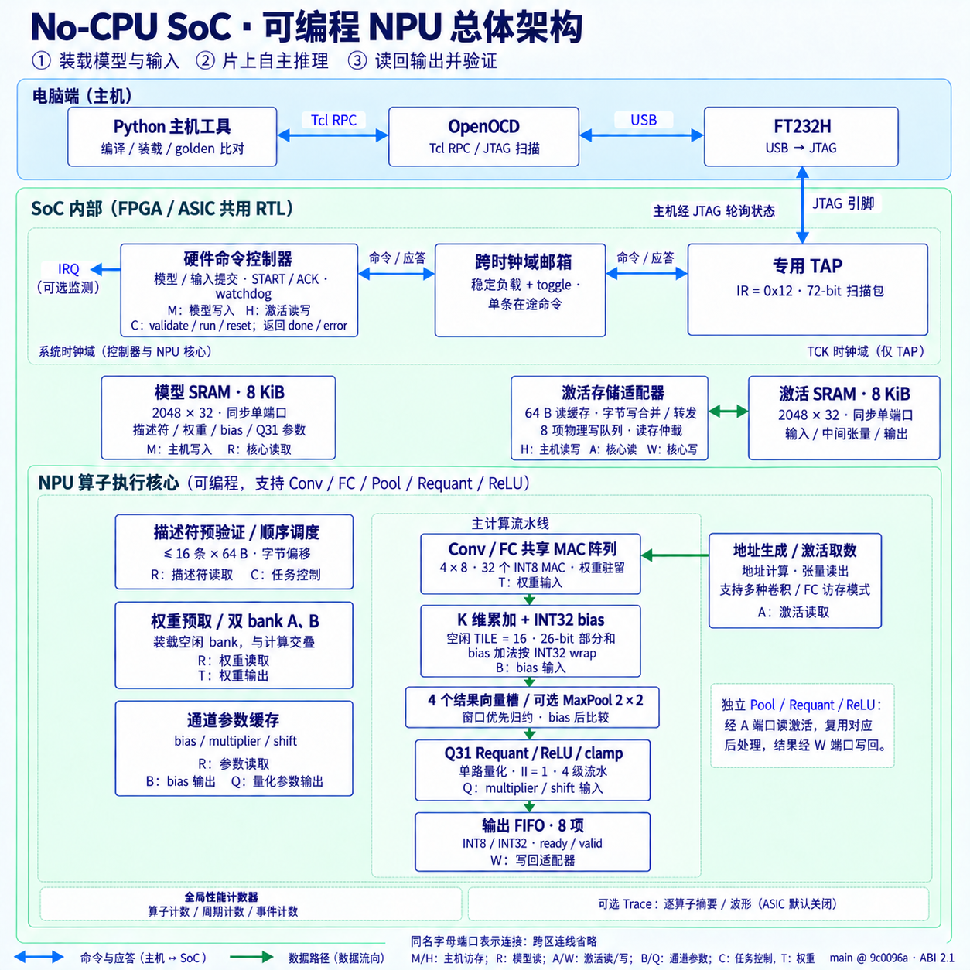
output/architecture/soc_npu_chinese_corrected_v3.png
