ScoreForever/ChipDesign/output/architecture/soc_npu_main_9c0096a_chinese_refactored_draft.png

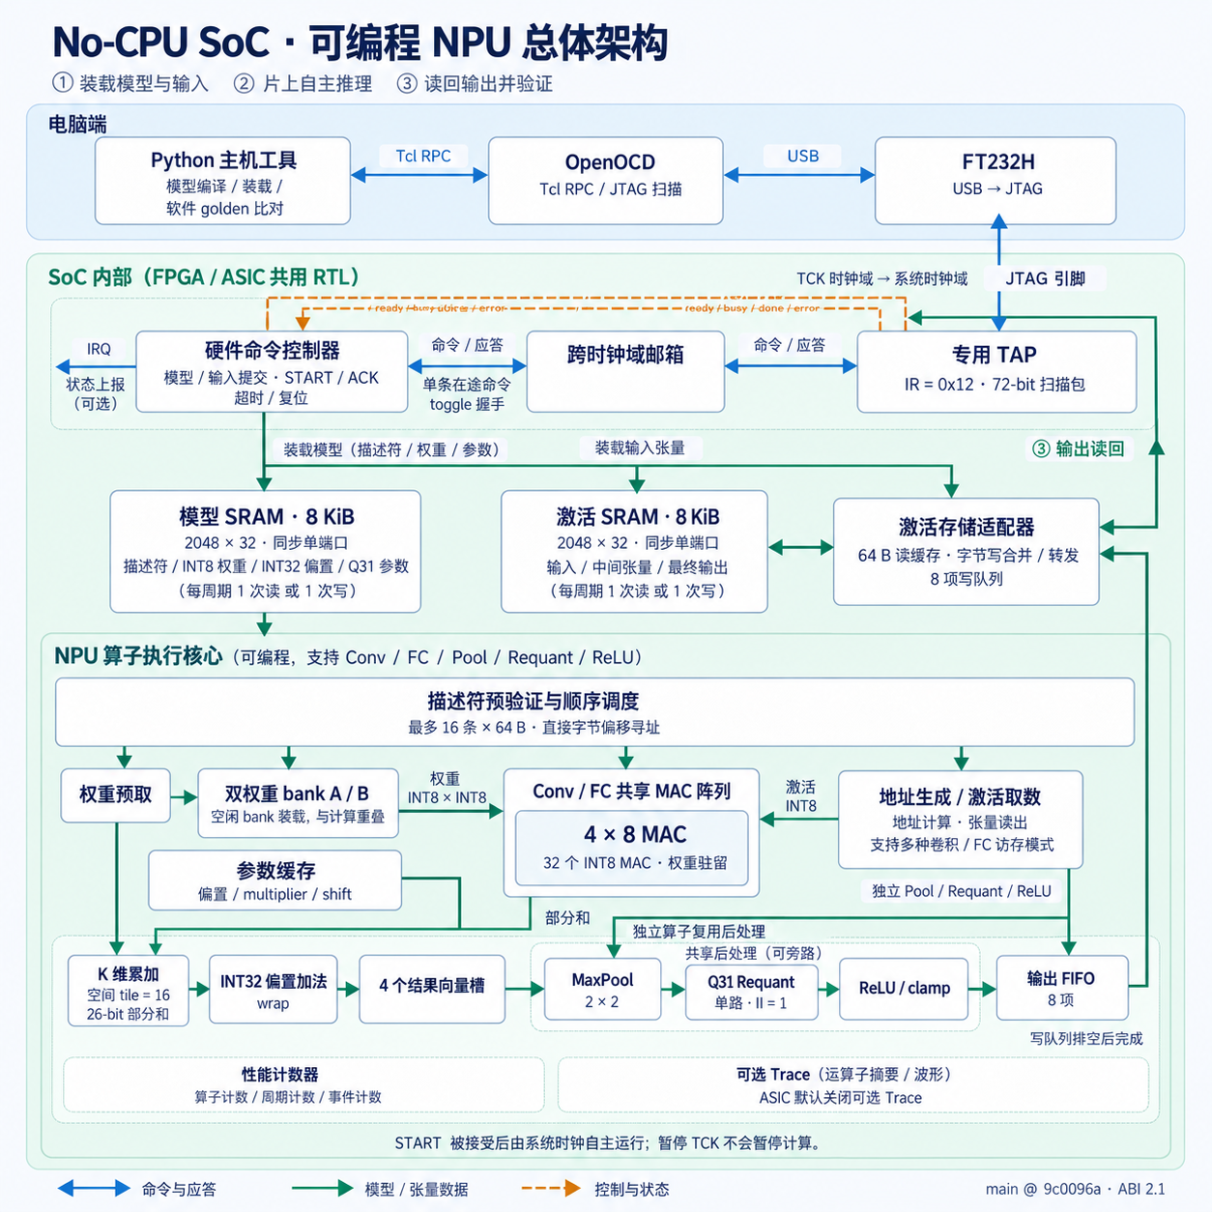
output/architecture/soc_npu_main_9c0096a_chinese_refactored_draft.png
