ScoreForever/ChipDesign/output/week8/manual_signoff_checklist.md

# 人工签核清单（下周第一轮）

所有项目初始状态均为“未核对”。A=EDA主责，B=EDA机动，C=RTL，D=FPGA。岗位需替换为姓名。
每项须记录：源码/未提交修改快照、配置、工具版本、输入及报告路径/哈希、人工抽查对象、问题/例外、结论、执行人、复核人和日期。
工具结果可以由AI汇总，人工签名不得由AI代填。未完成项不代表已发现设计错误，但不能算作已验证通过。

| ID | 核查内容与人工验收重点 | 执行 | 复核 | 状态 |
|---|---|---|---|---|
| G01 | 版本身份：RTL/host/约束/库/模型/网表/镜像一致，记录未提交修改，抽查源码与产物对应关系 | C | B | 未核对 |
| G02 | 独立golden与数值：抽查INT8有符号乘法、累加、bias wrap、Q31舍入/裁剪、尾通道与padding | C | B | 未核对 |
| G03 | 存储顺序：两颗单端口SRAM、读缓存、任意mask、写合并/转发、flush后done，逐次写回与预期核对 | C | D | 未核对 |
| G04 | 命令事务：模型/输入不完整、非法描述符、busy请求、未ACK结果、超时/RESET；故障恢复后无陈旧响应 | C | D | 未核对 |
| G05 | CDC协议：请求执行唯一性、响应匹配、payload稳定、TCK暂停、频率/相位变化、复位取消语义；抽查波形 | D | C | 未核对 |
| G06 | CDC物理实现：同步器级数/属性/扇出、复位释放、bundled payload最大延迟及例外端点；不以全域false path掩盖payload | D | A | 未核对 |
| G07 | FPGA：同次bit/DCP/provenance、实际下载与设备身份；setup/hold、未约束路径、DRC/CDC、TCK与外部I/O预算 | D | B | 未核对 |
| G08 | 实板：逐字节输出、重复推理、停TCK、协议RESET；物理复位/断电重配等分别记录，不以smoke代替完整覆盖 | D | C | 未核对 |
| G09 | ASIC综合：双宏映射、参数/trace配置、单元面积与宏面积口径、锁存器/未解析模块/约束告警 | A | C | 未核对 |
| G10 | ASIC STA：时钟/生成时钟、I/O预算、setup/hold、未约束路径、false/multicycle路径、SRAM覆盖、PVT角清单；抽查最差路径 | A | B | 未核对 |
| G11 | 版图：宏方向/引脚可达、halo、实际密度、拥塞、连通性、电源连接、天线、金属填充及填充后提取一致性 | A | B | 未核对 |
| G12 | DRC/LVS：检查原始结果和规则版本，逐类审查IO例外、阻值容差及工艺认可依据；不是只看脚本PASS | A | B | 未核对 |
| G13 | 等价性：比较对象/源码身份、未匹配点、SRAM黑盒及覆盖范围；不得把网表间等价当成完整RTL功能证明 | A | C | 未核对 |
| G14 | SDF：确认非零真实标注、层次/弧覆盖、时间单位、SRAM弧改写、完整告警审计及精确CDC例外；抽查时间戳 | A | C | 未核对 |
| G15 | 低精度：量化/训练来源与任务精度、打包/符号/尾项契约、独立数值参考、面积收益扣除新逻辑，ABI版本与回退方案 | C | A、B | 未核对 |
| G16 | 性能：统计窗口/互斥口径、冷/热分离、trace配置、实板与仿真身份；人工复核主要瓶颈证据而非凭峰值判断 | B | C、D | 未核对 |
| G17 | 工艺与可靠性缺口：多角STA、IR/EM、密封环、芯片级ESD及封装/I/O要求是否齐全；缺输入逐项列出 | A | B | 未核对 |
| G18 | 可测性与交付：DFT/扫描/ATPG、存储测试及测试访问是否适用；按真实代工厂/课程清单核实要求与现状，不臆造已完成证据 | B | A、C | 未核对 |
| G19 | 最终交付身份：GDS/网表/LEF/约束/寄生/SDF与签核报告绑定同一版本，冻结后变更需重新判断受影响检查 | A | B | 未核对 |

## 单项签核记录模板（每个ID填写一份）

- ID / 模块：
- 源码快照及本地修改：
- 工具、库、配置、时钟及工艺条件：
- 原始证据路径与校验值：
- 人工抽查的具体路径 / 波形 / 数据样本：
- 发现的问题、例外及对结论的影响：
- 人工结论：未核对 / 通过 / 有条件通过 / 不通过 / 不适用
- 条件、遗留动作、责任人及期限：
- 执行人、日期：
- 复核人、日期：

## 汇总放行

- 发布对象：稳定INT8基线 / 实验候选 / 流片交付（分别填写，不混用）
- 未核对项和阻塞项：
- 有条件通过项及批准依据：
- 与工具自动汇总不一致的人工裁决：
- 最终人工负责人、结论、日期：

在未确定最终负责人、未补齐要求的工艺签核和交付证据前，不将“本周核查完成”写成“可以流片”。
