ScoreForever/ChipDesign/docs/validation/eda_latest_20261111/reports/setup_summary.txt

###############################################################
#  Generated by:      Cadence Innovus 21.16-s078_1
#  OS:                Linux x86_64(Host ID tc-01a0e839f839)
#  Generated on:      Wed Nov 11 05:19:18 2026
#  Design:            my_soc_top
#  Command:           timeDesign -postRoute -expandedViews -outDir timing_setup
###############################################################

------------------------------------------------------------------
          timeDesign Summary
------------------------------------------------------------------

+--------------------+---------+---------+---------+---------+
|     Setup mode     |   all   | reg2reg |reg2cgate| default |
+--------------------+---------+---------+---------+---------+
|           WNS (ns):|  0.486  |  0.516  |  0.486  | 14.177  |
|           TNS (ns):|  0.000  |  0.000  |  0.000  |  0.000  |
|    Violating Paths:|    0    |    0    |    0    |    0    |
|          All Paths:|  28194  |  27219  |   394   |   625   |
+--------------------+---------+---------+---------+---------+
|func_tt_io          |  0.486  |  0.516  |  0.486  | 14.177  |
|                    |  0.000  |  0.000  |  0.000  |  0.000  |
|                    |    0    |    0    |    0    |    0    |
|                    |  28194  |  27219  |   394   |   625   |
+--------------------+---------+---------+---------+---------+

+----------------+-------------------------------+------------------+
|                |              Real             |       Total      |
|    DRVs        +------------------+------------+------------------|
|                |  Nr nets(terms)  | Worst Vio  |  Nr nets(terms)  |
+----------------+------------------+------------+------------------+
|   max_cap      |      0 (0)       |   0.000    |      0 (0)       |
|   max_tran     |      0 (0)       |   0.000    |      0 (0)       |
|   max_fanout   |      0 (0)       |     0      |      0 (0)       |
|   max_length   |      0 (0)       |     0      |      0 (0)       |
+----------------+------------------+------------+------------------+

Density: 84.613%
       (100.000% with Fillers)
------------------------------------------------------------------
