ScoreForever/ChipDesign/output/npu-performance/20261107/progress.md

RTL/cycle decomposition finished. Two physical candidates remain active. Candidate fastprep matches archived fastprep_* sources and rtl_summary.json. Candidate oneprep matches current workspace RTL and oneprep_rtl_summary.json. Unit base-change regression added after full program tests, all three storage modes passed. No clocks or CDC constraints altered. Board runner and seven-model benchmark are uploaded to remote archive.
Controller config bounds cone confirmed from complete previous routed path, added registered config_ok with no cycle penalty. Current local core restored to two-cycle fastprep (faster than oneprep). Config candidate full 85/19 + macro 10/19 passed and matches two-cycle model cycles. New unit test covers model size changes concurrent with access. All seven current model/command/golden binaries confirmed identical to previous benchmark.

Remote builds still active as of 18:14 China time. fastprep=57103 / temp chipdesign_nocpu_3qzlyruf / checkout/build/fastprep_50mhz, oneprep=54076 / chipdesign_nocpu_rrgxuq22 / checkout_oneprep/build/oneprep_50mhz, config=8698 / chipdesign_nocpu_kn01ir8d / checkout_config/build/config_50mhz. Archive D:/IWS/advanced_soc/ChipDesign/build/fpga_signoff/npu_perf_20261107. Config candidate matches current workspace RTL. fastprep main synth WNS -1.402, 18689 LUT, now placing. Latest board scripts + three RTL summary files uploaded. Only after final physical timing/CDC gates program EGo1 cable 1234-tulA then run run_board_verify.sh <checkout> <build> <rtl_summary_name>. External FT232H serial 210512180081 on USB bus2-3, WSL Ubuntu may need usbipd detach/attach and device chgrp plugdev/chmod0660 as previous turn. Board runner starts OpenOCD 1MHz, runs seven first golden frames twice with exact RTL cycle matching, then five board CDC cases via nocpu_board_cdc.py 56 Conv pairs. Board remains previous accepted bitstream until gates pass.
18:45 update. First variants remain timing-negative in placement or intermediate routing. Config candidate routed its first pass, pending final timing/post-route optimization. Fourth candidate checkout_grant/build/grant_50mhz, temp chipdesign_nocpu_8mav38fe, session7126. FPGA arbitration uses registered preference for model grant, retains bounded activation turn, no per-read request pipeline. Full85/19 passes incl continuous contention unit test, seven model cycles near identical (+0.01%..-0.17%).
Fifth candidate precomputes coordinate validity bounds at K setup, replacing tap/padding arithmetic on every activation request. Current workspace core and model_store match checkout_bounds/build/bounds_50mhz, temp chipdesign_nocpu_fc0s4c4k, session14319. Local full regression session94629 still running. Bounds math 7,311,360 cases pass. Before-bound sources saved as grant_model_store.sv, grant_program_core.sv. Controller config register same as candidate3. Select final only after positive routed setup/hold, strict CDC, then board verification.
Bounds candidate completed full85/19 + macro10/19; model cycles exactly match grant variant. Current workspace core/model/controller match checkout_bounds. Strict CDC watcher49393 waits for bounds final provenance and PASS summary, then invokes existing run_npu_jtag_cdc.py into cdc_checkout_bounds. Watcher61199 does same for checkout_grant. Earlier three Vivado candidates were explicitly stopped after persistent negative timing, their wrappers copied partial evidence/provenance and exited255. No discarded candidate was programmed.
Bounds initial build failed at synth with Cannot open realtime/fpga_top_synth.xdc (not a logic mismatch). Retried unchanged source in build/bounds_retry_50mhz, temp chipdesign_nocpu_slzq9ina, session79208. Its CDC watcher is94433, replacing failed watcher49393. Grant watcher61199 remains active. Both guard for final Result PASS before invoking strict CDC. Earlier Vivado process IDs42424,30004,51840 were stopped after exact command-line checks matched their owned candidate staging paths; unrelated GUI40204 preserved.
19:15 update. Grant variant routed first pass at WNS -1.614/WHS +0.032 and was stopped as superseded. Its watcher61199 will reject the non-PASS summary. Bounds retry synthesis WNS -0.096, 19036 LUT (91.52%), in placement. Its worst synth path starts oct -> tile_channels -> narrow -> weight address -> store controls.
Sixth candidate registers narrow during existing SETUP step0, reset initialized0, no extra execution state/cycle. Current workspace core matches checkout_tail/build/tail_50mhz, temp chipdesign_nocpu_m4hbaoqw, build session81728, CDC watcher15360 into cdc_checkout_tail. Full85/19 plus macro10/19 passed; all seven cycle pairs identical to bounds/grant. Summary tail_rtl_summary.json uploaded. Board runner will take checkout_tail tail_50mhz tail_rtl_summary.json if selected. Pre-tail core saved bounds_program_core.sv. Four earlier owned candidates stopped; only bounds_retry and tail are now active. Latest source patch should be regenerated before final delivery because current this_round.patch predates narrow-register change.
20:15 update. Bounds retry finished PASS at 19:57, WNS 0.000/WHS+0.020, LUT18955/20800, DSP16. CDC cdc_checkout_bounds/review.json passed, but zero setup slack is worse than previous +0.014, so not selected/programmed. Its original SSH79208 channel dropped at 1h idle; remote Python/Vivado survived and copied final evidence. Use ssh -o ServerAliveInterval=30 for long sessions.
Tail candidate6 (81728/m4hbaoqw) first-route negative~-.649, post-physopt ongoing. Hostq candidate7 (88810/8x3cbhra) full85/19 + macro10/19 + targeted host-buffer tests passed. Its seven cycle pairs exactly same as tail/bounds/grant; synth WNS-1.045, LUT19311, place WNS-.280/WHS+.019, now routing. Hostq CDC watcher73073 (keepalive) awaits PASS then cdc_checkout_hostq. Current workspace RTL matches hostq summary. Added hardware/npu/tb/tb_npu_host_writes.sv and integrated into unit_tests under CHIPDESIGN_FPGA_MEM. Unit tests exercise physical-address snapshot across config change while stalled, read barrier, reset cancellation. hostq_units.log / build/npu_perf_hostq_units/host_writes.log pass.
Experiment selective activation-miss response registration reused existing held register but cost +18%..37% seven cycles; rejected. Both npu_model_store.sv and npu_activation_store.sv restored exactly to hostq baseline, source hashes verified vs build/npu_perf_hostq/summary.json. No new response ports remain.
Important: Windows clones convert six untouched SV files to CRLF, so local RTL summary raw hashes differ. Confirmed normalization-only differences. Downloaded actual staged files to output/npu-performance/20261107/hostq_remote_source; replay_remote_rtl.py compiled these exact raw sources with SYNTHESIS, FPGA_MEM, trace disabled and verified all tensor writes, both cycle pairs and all24 counters for all7 frames. PASS. Actual raw-source summary build/npu_perf_hostq_production/summary.json copied to archive hostq_production_summary.json AND remote archive. Use this production summary for board runner, not local-LF hostq_rtl_summary.json, so strict raw source hashes pass. Doing equivalent bounds production replay in session83702 -> build/npu_perf_bounds_production, log bounds_production.log. Hostq actual source snapshots/benches are in archive. Seven golden/input/model binaries unchanged from previous regression.
Parallel implementation margin experiment launched session63434 via ssh keepalive. Remote archive/run_margin.py runs margin_from_route.tcl against bounds_retry route.dcp into checkout_bounds/build/bounds_margin_50mhz. Extracted helper procs from existing build_ego1.tcl into build_helpers.tcl, reuses reports/summary/bram_guard. Applies EXTRA SETUP UNCERTAINTY .350ns (clock always20ns), phys_opt AggressiveExplore + route Explore, then resets USER setup uncertainty to0 (auto jitter/phase error stays), reruns original50MHz timing/CDC/DRC and writes bitstream only if WNS>=.100/WHS>=0. Parent checkpoint/source SHA and tuning script SHA recorded in provenance. Official AMD UG835 confirms user clock uncertainty is additive and can overconstrain implementation without altering clocks. Need verify original_worst and final route_timing_summary have same automatic uncertainty .084 and period20. No margin CDC watcher yet; run strict existing CDC into cdc_checkout_bounds_margin only after actual PASS. Source root checkout_bounds is old candidate5, not current workspace. If margin wins, restore core bounds_program_core.sv, subsystem previous_control_subsystem.sv, remove only new host-write test + new runner conditional, keeping memory config/fairness test and other previous changes. Regenerate final patch from starting snapshots and adapt final source to selected build.
Board runner archive/run_board_verify.sh now args checkout build summary [review_folder] [evidence_label]. For margin use checkout_bounds bounds_margin_50mhz bounds_production_summary.json cdc_checkout_bounds_margin checkout_bounds_margin, ensuring fresh CDC of same route. For hostq use checkout_hostq hostq_50mhz hostq_production_summary.json defaults. Runner starts FT232H OpenOCD1MHz, benchmarks seven first golden frames twice requiring exact RTL cycles + bytes, then board CDC5 checks (56 Conv pairs). Physical busy test may need bigger workload if faster inference finishes before duplicate START, inspect logged errors9 vs4. Preserve failed trials. Hardware EGo1 cable1234-tulA, external FT232H serial210512180081 bus2-3. WSL Ubuntu may need keepalive, detach/reattach usbipd and chgrp plugdev/chmod0660 exact USB device. Board has previous accepted bitstream until a new candidate improves .014ns setup AND passes same-image timing/CDC. No new image programmed in this turn yet.

## 最终验收完成（2026-11-07）

选定 checkout_bounds / bounds_margin_50mhz，当前工作区源码已恢复并与该镜像逐文件核对。50 MHz 路由 WNS +0.344 ns、WHS +0.058 ns，TNS/THS 0，LUT 18,961。实现阶段额外 setup uncertainty 0.350 ns，验收时恢复原始 20 ns 时钟及零 user uncertainty。132 组动态 CDC 和 109 个预期端点复核通过后，已将 SHA256 ef41bc0d170e4c20cfc7c8533434827fc22357d5c8a2b26627d8ebd7e2442590 镜像下载 EGo1。七模型各两次、共 14 次输出及周期均匹配生产 RTL；五项板级 CDC/恢复检查全部通过。先前待运行描述已被本结果取代。物理复位按键及电气波形仍待人工检查。完整结论见 README.md，源码增量见 this_round.patch。本轮未提交或推送。
