ScoreForever/ChipDesign/output/npu-performance/20261107/vivado_margin/summary.md

# EGo1 build summary

Result: PASS
Stage: complete; last completed stage: write_bitstream
Part: xc7a35tcsg324-1; top: fpga_top; CPU-less JTAG controller and programmable five-operator NPU
Clocking Wizard: 100 MHz input, 50 MHz output, locked enabled, reset disabled
Log: vivado.log

## Resources (latest available stage)

| Resource | Used | Available | Utilization (%) |
|---|---:|---:|---:|
| Slice LUTs | 18961 | 20800 | 91.16 |
| Slice Registers | 7242 | 41600 | 17.41 |
| Block RAM Tile | 4 | 50 | 8.00 |
| DSPs | 16 | 90 | 17.78 |
| MMCME2_ADV | 1 | 5 | 20.00 |

## Timing (latest available stage)

WNS: 0.344 ns; TNS: 0.000 ns; WHS: 0.058 ns

## Main SRAM mapping

N/A: CPU-less system uses NPU-local storage; no main SRAM

## Configuration/BRAM DRC

PASS at route: CFGBVS-1, REQP-1839, RBOR-1

## JTAG clock routing

Not applied
