ScoreForever/ChipDesign/verification/fpga/results/2026-11-01-no-cpu-int4/evidence/validated_50mhz/summary.md

# EGo1 build summary

Result: PASS
Stage: complete; last completed stage: write_bitstream
Part: xc7a35tcsg324-1; top: fpga_top; CPU-less JTAG controller and programmable five-operator NPU
Clocking Wizard: 100 MHz input, 50 MHz output, locked enabled, reset disabled
Log: vivado.log

## Resources (latest available stage)

| Resource | Used | Available | Utilization (%) |
|---|---:|---:|---:|
| Slice LUTs | 17255 | 20800 | 82.96 |
| Slice Registers | 10347 | 41600 | 24.87 |
| Block RAM Tile | 8 | 50 | 16.00 |
| DSPs | 14 | 90 | 15.56 |
| MMCME2_ADV | 1 | 5 | 20.00 |

## Timing (latest available stage)

WNS: 0.075 ns; TNS: 0.000 ns; WHS: 0.034 ns

## Main SRAM mapping

N/A: CPU-less system uses NPU-local storage; no main SRAM

## Configuration/BRAM DRC

PASS at route: CFGBVS-1, REQP-1839, RBOR-1

## JTAG clock routing

Not applied
