ScoreForever/ChipDesign/verification/fpga/results/2026-11-04-int4-v2/evidence/baseline_50mhz/summary.md

# EGo1 build summary

Result: FAILED
Stage: acceptance; last completed stage: write_bitstream
Part: xc7a35tcsg324-1; top: fpga_top; CPU-less JTAG controller and programmable five-operator NPU
Clocking Wizard: 100 MHz input, 50 MHz output, locked enabled, reset disabled
Log: vivado.log

Failure: Timing failed: WNS=-0.206 ns, WHS=0.053 ns

## Resources (latest available stage)

| Resource | Used | Available | Utilization (%) |
|---|---:|---:|---:|
| Slice LUTs | 17390 | 20800 | 83.61 |
| Slice Registers | 6199 | 41600 | 14.90 |
| Block RAM Tile | 4 | 50 | 8.00 |
| DSPs | 20 | 90 | 22.22 |
| MMCME2_ADV | 1 | 5 | 20.00 |

## Timing (latest available stage)

WNS: -0.206 ns; TNS: -0.404 ns; WHS: 0.053 ns

## Main SRAM mapping

N/A: CPU-less system uses NPU-local storage; no main SRAM

## Configuration/BRAM DRC

PASS at route: CFGBVS-1, REQP-1839, RBOR-1

## JTAG clock routing

Not applied
