ScoreForever/ChipDesign/docs/validation/eda_latest_20261111/README.md

# 最新版本独立后端与后仿验证（2026-11-11）

冻结源码：`aa778875eed49ada6b7b36bf10b1c0cdce2ad3c9`。详见 [完整报告](REPORT.md)、[PDF](report.pdf)、[机器可读指标](metrics.json)、[逐测试结果](rtl_full_cases.csv) 及 [复现脚本](reproduction/reproduce.sh)。

本目录为重新综合、布局布线、SDF 及独立检查的证据，不复用旧版通过结论。原始 Calibre DRC/LVS 的局部偏差与 SRAM STA 范围见报告，不能据此宣称流片签核完成。
