ScoreForever/ChipDesign/output/fpga-verification-refactor/findings.md

历史结果目录带哈希清单和冻结源码，原位保留。ABI 5.0 仿真和 ABI 4.0 实板记录需要分开判定。根目录脚本依赖仓库相对深度、同级测试或跨脚本导入。
ABI 5.0 编译器要求固定两颗 8 KiB SRAM，旧忙时物理按键脚本先按 200000 B 编译再去重，属于历史复现。现行签核保留人工忙态采样条目，等待有效的新版本证据。
