ScoreForever/ChipDesign/output/fpga-verification-refactor/progress.md

已盘点目录及仓库入口，保留原有根级规划文件。
已迁移脚本并调整根目录解析、板测说明及 CI 引用。正在整理签核标准与历史证据索引。
静态检查首次把 Python 文件数误计为 21。改用 Git 基线中的原始文件名集合核对迁移完整性。
签核表及历史证据索引完成。迁移文件完整性、Python 语法、仓库路径、新文档链接及结果归档无变更均已静态核对。未执行回归、实现或板测。
