ScoreForever/ChipDesign/output/fpga-verification-refactor/task_plan.md

# FPGA 验证重构
- [x] 盘点现行入口、历史脚本和证据。
- [x] 按验证责任归类脚本，更新引用。
- [x] 建立 ABI 5.0 人工签核表，核对目录引用。
