ScoreForever/ChipDesign/verification/fpga/SIGNOFF_CHECKLIST.md

# ABI 5.0 FPGA 人工签核表

每个候选镜像复制一份。操作人与复核人分别填写，证据链接指向原始文件或同一归档中的相对路径。
本表初始状态为 **待证**。ABI 5.0 扩展报告的仿真可作为 A02、A03 的待复核材料。

## 本轮身份

| 字段 | 本轮值 |
|---|---|
| 候选编号 / 日期 / 操作人 / 总复核人 | |
| Git commit / 工作区差异或冻结源码哈希 | |
| ABI 读回 / 8×8 / 描述符上限 / SRAM 能力读回 | |
| Vivado 版本 / FPGA part / 板卡 ID / 约束版本 | |
| 系统时钟 / TCK 约束 / OpenOCD 实际配置值 / 测量值（如有） | |
| 实现目录 / provenance / bitstream SHA-256 / 下载日志 | |
| 模型包、输入、参考输出哈希及参考实现版本 | |
| FT232H 序列号 / 配置线标识 / 接线照片或记录 | |

状态填写 **待证 / 未执行 / 通过 / 失败 / 阻塞 / 不适用**。每行填写执行者、复核者、日期和证据。不适用要写明理由和批准人。
任何必选项未闭合时，总结写明缺项与责任人。部分覆盖按实际范围记录，如“忙态采样”或“软件评分”。

## A. 版本与 RTL

| ID | 人工检查和判定条件 | 原始证据 | 状态 / 执行者 / 复核者 |
|---|---|---|---|
| A01 | 源码、约束、模型、构建输出与候选标识相互对应。记录工作区差异、源码与镜像哈希 | Git 记录、provenance、镜像哈希 | 待证 |
| A02 | 当前版本程序回归通过。核对七算子、融合开关、INT4/u4/INT32、长 K、数值边界和写回逐项一致 | RTL summary、原始日志、参考输出 | 待证 |
| A03 | 核对 17/64/128 条描述符、最后一条错误定位、共享 SRAM 跨 bank、模型区保护和写队列排空 | FPGA 存储配置或对应仿真证据、负向用例日志 | 待证 |

## B. 实现、时序与 CDC

| ID | 人工检查和判定条件 | 原始证据 | 状态 / 执行者 / 复核者 |
|---|---|---|---|
| B01 | 同一 bitstream 对应的已布线构建完成。核对资源、DRC、严重警告与例外处理 | 实现摘要、utilization、DRC、route 日志 | 待证 |
| B02 | 对系统时钟和 TCK 逐项核对 setup/hold、时钟关系、例外、外部 I/O 与未约束路径。记录裕量、假设和每条例外的依据 | Timing Summary、clock/IO audit、XDC、未约束路径报告 | 待证 |
| B03 | 对请求/应答同步链、复位及 72/37 位捆绑数据逐项检查端点、约束覆盖和余量。每个 CDC finding 有解释与复核 | route_cdc.rpt、route_npu_jtag_cdc.tsv、约束版本 | 待证 |
| B04 | 现行 TAP 动态验证覆盖独立时钟、命令与应答、突发握手以及复位恢复。区分仿真和静态检查结论 | compile/sim、burst_compile/burst_sim、CDC review | 待证 |

## C. 下载与实板功能

| ID | 人工检查和判定条件 | 原始证据 | 状态 / 执行者 / 复核者 |
|---|---|---|---|
| C01 | 人工关联构建、下载和板卡。核对接线、下载 DONE/CRC、fabric TAP ID 与版本能力读回 | 下载日志、接线记录、OpenOCD、能力寄存器 | 待证 |
| C02 | 冒烟推理冷启动、重复推理均逐字节匹配。核对输入和预期输出来源 | 冒烟 report.json、manifest、输入/参考/实际输出 | 待证 |
| C03 | 完整功能与负向套件覆盖描述符、融合、跨 bank、边界及错误恢复。逐组核对跳过项与黄金参考 | 自动套件目录、命令日志、证据复核输出 | 待证 |
| C04 | 核对发布模型的实际覆盖范围。按模型记录帧数、重复次数、冷/热模式及 mismatch，另列软件准确率 | 模型/帧清单、实板比对输出 | 待证 |

## D. 实板异常、恢复与测量

| ID | 人工检查和判定条件 | 原始证据 | 状态 / 执行者 / 复核者 |
|---|---|---|---|
| D01 | 观察 BUSY 后停止 JTAG 扫描，恢复扫描后确认任务完成并逐字节比对。记录停顿时长 | 停 TCK 脚本报告、状态和输出；如有仪器附 TCK 波形 | 待证 |
| D02 | 在已确认 BUSY 时重复 START、发协议 RESET，核对拒绝码或复位状态，重新装载后推理一致 | 命令与状态日志、错误码、恢复输出 | 待证 |
| D03 | 制造 watchdog 超时，核对错误码、状态清理与重新装载后的推理 | 超时前后状态、恢复输出 | 待证 |
| D04 | 空闲及忙时分别操作实体复位键。忙时需有复位前 BUSY 采样；复位后查状态与重新推理 | 操作者记录、最后有效 BUSY、复位后 TAP/状态、推理输出 | 待证 |
| D05 | 记录断电、重新上电和配置方式，确认同一候选重新可用并输出一致 | 电源与重配记录、配置日志、恢复输出 | 待证 |
| D06 | 记录长跑次数、持续时间、温度/供电条件与错误数；按本轮要求测量 TCK/电气及温压边界 | 长跑日志、仪器记录或缺项说明 | 待证 |

## 总判定

- FPGA 操作人负责 C、D 的执行记录，RTL 同学复核 A、B04，EDA 同学复核 B01–B03。机动同学核对身份和原始证据索引。
- 自动脚本通过后，仍需逐项填写人工检查与复核结论。
- 本轮判定：________　未闭合 ID / 责任人 / 计划：________
- 操作人：________　独立复核人：________　日期：________
