ScoreForever/ChipDesign/docs/kws_tinycnn8_tiled/VALIDATION.md

# 最终验收记录

## 本地功能与复现

- 基于主线 `46d759b` 的增量，核心及复现修复提交分别为 `51477df`、`3a95eaf`。
- 最终从只包含提交文件的独立 checkout 完整运行默认入口，退出码0，summary为PASS。
- 12个网络用例、56次native运行、24个MMIO配置/用例组合×3连续任务，共72次MMIO推理。
- 224,740次逐层元素比较通过；63项记录的配置、oracle、生命周期及MMIO回归通过。
- Python golden 27项单测通过；独立量化RTL oracle401向量通过。
- 最终结果的750个文件哈希及所有仿真源哈希已校验，未依赖未提交文件或旧Git对象。
- 首次新checkout暴露的macOS路径别名问题已修复并完整重新运行，不将失败收尾标为PASS。

## 性能与资源

- tile16整网51,821→30,395周期，减少41.35%，速度比1.705×。
- trace C2 30,482→9,056周期，速度比3.366×；硬件层计数30,483→9,057，采用不同且明确的层边界。
- C2 Matrix输入/输出1440笔不变，权重装载行5760→360，减少93.75%。
- tile16主要数据存储584B：512B部分和、64B整数tag队列、8B两个activation packs。
- 有额外控制/profiler寄存器和组合逻辑，未综合，不能把容量当面积或宣称功耗改善。
- tile7/8/16/32均验证；fallback、非法tile拒绝、反压、busy reset/restart、连续任务通过。

## 图表验收

最终性能与trade-off两图经独立视觉验收通过，标签、数据和构图无裁切或重叠。
Tile7数据已与正式CSV确认，验收问题已关闭。图像未在更新测试数量时改变。

## 阶段结论

完成的是限定模型和组合行为存储契约下的RTL数值、协议、调度与正式MMIO后端验收。
未验证真实KWS准确率、CPU/AXI/DMA整SoC、同步SRAM宏、综合、STA、面积、频率或功耗。
CI workflow已准备；是否远端绿灯必须以实际GitHub检查为准。

完整证据保存在本地 `hardware/npu/sim/tinycnn8_tiled/final_clean_verified/`，不作为大体积源码上传。
旧阶段源码和11.12%实验已保存在仓库外的完整校验备份。
