ScoreForever/ChipDesign/output/npu-performance/20261107/prep_experiment.md

# 连续组准备周期的对照实验

相同输入和存储配置。二周期准备含元数据生成、相对偏移比较；一周期版本直接使用连续性常量。两版均通过功能回归。

| 模型 | 二周期准备版 | 一周期准备版 | 一周期版变化 |
|---|---:|---:|---:|
| packaged_ecg_c8_f1_j0 | 15860 | 15948 | +0.55% |
| packaged_fashion_cnn_c8_f1_j0 | 47273 | 47716 | +0.94% |
| packaged_gtsrb_l_c8_f1_j0 | 128278 | 128655 | +0.29% |
| packaged_har_c8_f1_j0 | 18835 | 18917 | +0.44% |
| packaged_kws_l_c8_f1_j0 | 86714 | 87360 | +0.74% |
| packaged_kws_m_c8_f1_j0 | 88930 | 89508 | +0.65% |
| packaged_mnist_l_c8_f1_j0 | 37150 | 37212 | +0.17% |

虽然一周期版减少 kernel_prepare_cycles，七个模型的总周期均略增。减少准备空隙改变共享读/写队列的访问交错，因此选择需要结合总周期和布线余量。等待两个候选物理实现结果。
