ScoreForever/ChipDesign/output/npu-performance/20261107/task_plan.md

# NPU 性能与 50 MHz 时序优化

- [x] 保存起点 RTL，复现周期回退并定位等待计数。
- [x] 单独移除请求流水，量化收益。
- [x] 注册模型基地址并加速连续 K 组准备，完成 RTL 功能和七模型回归。
- [x] 在 mywin 隔离目录运行 50 MHz 完整实现。
- [x] 完成同一镜像的布线后时序和 CDC 复核。
- [x] 门禁通过后上板测量并归档结果。

ABI 5.0、8×8 阵列。先以上一轮上板镜像为性能对照，另列原始 38fdd73 基线。每轮源码和实现证据保持对应。
