ScoreForever/ChipDesign/docs/validation/eda_lab5_20261110/area_optimization/AREA_OPTIMIZATION_STATUS.md

# 面积优化测试结果（2026-11-10）

本轮候选已通过一轮完整的布局布线、流程物理检查、CDC 路径审计及 SDF 门级仿真。综合标准单元面积下降 22.48%，实际 die 为 1.9404 × 1.9404 mm。尚不能据此宣称流片签核完成。

候选方案保持 ABI 5.0、8×8 阵列及原有推理周期。源码基线为 `8c16462`，叠加文件与 SHA-256 见 `candidate_r2_sources_sha256.json`。

## 已完成

| 项目 | 基线 | 当前候选 |
|---|---:|---:|
| 标准单元面积 | 1,799,016.883 µm² | 1,394,641.294 µm² |
| 两颗 SRAM 面积合计 | 802,887.188 µm² | 802,887.188 µm² |
| 总实例面积 | 2,601,904.071 µm² | 2,197,528.482 µm² |
| 综合最差 setup 余量 | +7.049 ns | +7.519 ns |

标准单元面积减少 **22.48%**。总实例面积含 SRAM，不等于 die 面积；上述时序均为综合估计，不能代替布线后时序。

优化包括：lookup 表由 256 项精确收缩至 129 项（输入项 + 最多 128 个算子输出项）；ASIC 综合启用库内集成时钟门控单元，减少带使能寄存器的数据选择开销。共插入 394 个 ICG、覆盖 15,853 个触发器。时钟门控报告中的 toggle saving 为工具估计，不能当作实测功耗。

- lookup 与原实现逐周期比较通过：MAX_OPS=1/16/128，包括复位、中途放弃和重新装载。
- 247 个 RTL 回归用例 × 2 次运行通过；周期、写入次数及每次 24 项性能计数器与基线完全一致。另有负例/生命周期检查。
- 综合 CDC 路径审计通过：109 条 payload 和 2 条同步器 setup 路径；不包含布线后 hold 结论。
- 映射网表功能仿真通过：非零 u4_chain 连续两次推理及复位，41 条命令、340 个 burst。使用 precision-unit 正延时解决零延时模型事件竞争；未回标 SDF，未据此宣称时序通过。

## 实际布局布线测试

运行目录：`/home/s2400012892/chip-fullstack-2026/ChipDesign_abi5_area129_icg_20261110_r2/work/area129_icg/candidates/area129_icg_diag75`。

固定尺寸上限 1.95 × 1.95 mm；请求 core 1640 µm、die 1940 µm，预留网格取整空间。两颗 SRAM 对角相向、halo 26 µm，hold 优化目标 0.12 ns。

第一次物理尝试因 SRAM 名称中方括号导致 Tcl 列表/标量解析不一致而停止。已修正并以严格匹配的同一份综合网表启动全新 r2 运行，保留失败证据。

placement 结束时（过程记录）：实际 DEF 的 die 为 **1940.4 × 1940.4 µm**（2000 DBU/µm），符合尺寸上限。pre-CTS 几何统计标准单元面积 **1,407,566.6304 µm²**、可放置行密度 **83.18%**，未放置实例为 0。两颗 SRAM 的 D/Q 各 64 引脚经实际坐标核验分别向东/西。75% 是初始面积估算参数，不是实际可放置行密度。

CTS 新增时钟布线后工具报告 global-route overflow 估计横向 9.20%、纵向 4.49%，随后执行了 congestion repair；之前低于 1% 的估计不能代表 CTS/最终布线。上述均为过程数据，不能作为最终验收结果。

## 验收范围

以下末尾记录为最终 ECO 布线及 SDF 结果。独立重跑、Lab 5 加 seal ring/dummy 后最终 GDS 的 Calibre DRC/LVS/ERC/antenna/wirebond、多工艺角 STA、DFT 及人工签核尚未完成。当前检查为 Innovus 流程物理验收，不能代替最终 GDS 的工艺规则签核。

独立低相位透明 latch lookup 原型未通过既有等价测试，已拒绝，未进入生产 RTL。

## r2 首轮布线结果（ECO 修复前）

- die 1.9404 × 1.9404 mm；最终标准单元面积 1,430,890.6304 µm²。
- setup WNS +0.487 ns、hold WNS +0.050 ns，setup/hold TNS 均为 0。
- CDC、placement、端口、SRAM 引脚、电源 DRC/连接、普通连接、DRV、antenna 均通过流程核验。
- 信号 DRC 未通过：METAL3 与 METAL4 各一处短路，集中于 (856–858, 1585–1587) µm。
- 保留 2 条 IMPSP-9099 扫描链提示：综合网表使用扫描型 FF 实现功能逻辑，不能据此宣称 DFT 完成。
- 随后执行独立 `area129_icg_diag75_eco1`，从 r2 最终检查点修复已有 DRC 标记，最多 2 次 ECO；不修改 RTL、时钟或时序例外。重新生成全套时序、CDC、DRC 和交付文件。

## 最终 ECO 布线与 SDF 验收

最终候选：`area129_icg_diag75_eco1`。从原始检查点仅执行一次 marker-based `ecoRoute -fix_drc`，重新提取寄生、计算时序、审计 CDC 并导出交付文件。未修改 RTL、时钟频率、时序例外或芯片尺寸。

| 指标 | 结果 |
|---|---:|
| 实际 die | 1.9404 × 1.9404 mm |
| 布线后标准单元几何面积 | 1,430,890.6304 µm² |
| setup / hold WNS | +0.487 / +0.050 ns |
| setup / hold TNS | 0 / 0 ns |
| 信号及电源 DRC | 流程检查均通过 |
| 连接、placement、DRV、antenna | 流程检查均通过 |
| CDC、SRAM 引脚方向、7 个信号端口 | 均通过 |

注意综合面积使用 Liberty 库面积，布线后面积使用实例几何面积；两者及 die 面积为不同口径。综合面积下降率使用同一综合口径的基线与候选对比。

SDF：core 50 MHz、TCK 1 MHz，保留真实延迟和 timing checks。41 条 JTAG 命令、340 个 burst 通过；非零算子链连续两次推理及复位恢复正确。验收脚本 `result.json` 为 `passed: true`，未豁免的 timing violation / SDF 回标错误为 0。

- 仅在预定的 6 个异步捕获/复位同步单元禁用 timing check，共 36 项检查；其余 90,764 项 SDF timing check 回标率 100%。req/ack 第二级同步器检查保留。
- 路径延迟回标率 98.46%。剩余告警按实际库模型确认属于非单调单元的 ifnone 默认弧；SRAM negedge period 无对应模型检查，保留告警记录。未扩大通用豁免。
- 输入 PAD 在 time 0 的 5 条 bus-conflict 初始化信息按已有窄范围策略记录接受；其他时刻或其他 PAD 冲突仍判失败。
- 初次启动因旧脚本只识别扁平 CDC 名称而停止在仿真前；已修正为严格识别实际层次网表，并补充拒绝缺失/重复/错误层次的测试。失败启动及原始首轮 DRC 证据保留。

本地证据：`fullchip_icg/synthesis/`、`fullchip_icg/physical_r2/`（修复前）、`fullchip_icg/physical_eco1/`（最终）、`fullchip_icg/sdf/`；完整服务器日志及 GDS/SDF 等交付文件保留于远程候选目录。私有 PDK 文件未复制进仓库。
