ScoreForever/ChipDesign/docs/FPGA_VALIDATION_PROGRESS.html

Progress briefing · 2026.10.14

# FPGA 验证进度 从仿真正确到上板闭环

RISC-V + TinyCNN-8 SoC 已补齐当前融合核的真实语音与系统集成仿真。下一阶段的重点是重新建立融合 Flat 版本的 FPGA 资源、时序和板级证据。

目标：EGo1 · Artix-7xc7a35tcsg324-1板载 100 MHz → 系统 50 MHz

本次交流结论

## 当前版本已跑过功能仿真， FPGA 实现证据需进一步确认。

历史 GAP 版综合和 DRC 修正已有记录；已核对 GitHub 全部分支与 PR：当前融合 Flat 的 RTL CI 已通过；远程尚未找到该配置的综合、布局布线或上板记录。

最新进展：soc 服务器 7 项回归全部通过

当前 SoC 集成回归

7 / 7 PASS

Xcelium · CPU/NPU、DMA、SRAM 等

真实语音 RTL 对拍

100 条

yes / no / up / down，每类 25 条

融合核心执行周期

2,805 cycle

不含特征处理、CPU 与数据装载

当前融合版 FPGA 实现

待确认记录

资源、布线时序、bitstream、上板

01 / 验证路线

## 当前版本走到了哪一步

状态按实际证据标注，不估算完成百分比

已通过模型 / 数值对拍

真实语音 INT8 向量，融合核、分层核与整数 golden 一致。

agi · Icarus 12

已通过整 SoC 仿真

CPU→MMIO→NPU 完成并产生 IRQ；DMA 与 SRAM 回归通过。

soc · Xcelium 21.09

当前版待重跑FPGA 综合 / DRC

旧 GAP 版结果保留；远程融合文档仍注明尚未取得综合结果。

目标 Vivado 流程

待完成布局布线 / 时序

补齐板级约束，检查布线后 setup / hold 与完整 DRC。

远程未见当前版实现报告

待完成bitstream / 上板

验证时钟复位、JTAG、程序装载与真实模型推理。

远程未见板卡验收记录

绿色：有执行证据黄色：有前置资产，当前版本待验证灰色：未完成验收

02 / FPGA 已有工作

## 结构与 DRC 的历史进展

Vivado 2025.2 · 综合 + opt_design

适用边界：以下 FPGA 数字属于历史 GAP 配置，提交 7569a43。PR #5 合并后默认核已切换为融合 Flat。旧结果可说明此前问题如何解决，但不能代表当前融合核的资源占用或时序。

### LUT 超容量问题曾得到改善

历史 GAP 版

同一目标器件共 20,800 个 LUT；最终数据含 SRAM / DRC 修正。

优化前21,243 · 102.13%

超出器件容量 443 个 LUT

最终历史结果19,368 · 93.12%

14,057FF

2BRAM36

51DSP

通过缩减激活存储声明容量、简化 Q31 舍入及调整 SRAM 流水线推进。历史 LUT 余量为 1,432 个，当前融合版余量未知。

### 配置 / BRAM 专项 DRC 已修正

历史 GAP 版

CFGBVS-1
补齐 3.3 V 配置电压约束

1 → 0

REQP-1839
同步 BRAM 地址、使能与数据控制

报告 20 → 0

RBOR-1
BRAM 同步输出级，DOA_REG=1

2 → 0

DSP 流水线建议
DPIP-1 / DPOP-1 / DPOP-2

保留 47 项

REQP-1839 修正前报告达到 20 项展示上限。DSP 建议未屏蔽：历史 CPU 16 项、NPU 31 项；当前融合版需重新统计。

### 历史时序：WNS +1.841 ns，TNS 0

对应 50 MHz 综合网表估计。尚未布局布线，不能据此认定布线后时序收敛或真实板卡稳定运行。

### 可复用的 FPGA 资产

fpga_top.sv 已包含 Clocking Wizard 接口、锁定后复位和 LED 状态指示；已提供 EGo1 配置电压 XDC 与 BRAM 专项 DRC 自动检查脚本。

03 / 当前融合 Flat 版

## 新一轮验证补齐了什么

最新证据来自 agi / soc，均为 RTL 仿真

真实输入

### 数值正确性

400 + 80,000

400 个有效 INT32 logits、80,000 个 Pool1 / Pool2 字节与整数 golden 逐位一致；同一批 100 条语音的融合 / 分层 8 lane 输出一致。

独立检查

### 逐周期事件校准

280,600

检查采样边沿，含 start；独立核验 load / issue / retire / requant / writeback 与 profiler。10 类篡改轨迹全部被按预期拒绝。

新服务器执行

### SoC 系统集成

40,615 cycle

CPU→MMIO→融合 NPU smoke 完成且观察到 IRQ。DMA smoke 917 cycle；量化、两种容量、两种 SRAM 读延迟也通过。

这批结果支持功能正确性，不构成 FPGA 上板或物理时序验收。整 SoC 当前运行的是测试程序 smoke，不是 100 条真实语音经 CPU/DMA 的完整板级通路；2,805 cycle 仅为融合核心耗时。100 条样本用于 RTL 对拍，完整测试集准确率另行评估。

### 模型已保持部署兼容

TinyCNN-8-Flat，1,324 个训练参数。重训基线 INT8 test 89.57% → 选中候选 90.06%（1,620 条），提升 0.49 个百分点；未超过历史 90.56%，也不是上板精度。

### 综合入口读入检查已推进

移除顶层文件路径参数的显式 string 类型后，Genus 19.17 已通过 RTL 读入。已准备 Genus / DC 综合入口与约束模板；技术库尚未指定，未执行映射综合。

04 / 当前问题

## 上板前仍需关闭的事项

按依赖顺序推进，而非同时堆叠新功能

问题 / 当前状态 | 对 FPGA 验证的影响 | 关闭条件
P0远程未见融合版综合结果当前 LUT / DSP / BRAM 和关键路径未知 | 无法沿用 GAP 的 93.12% LUT 或 +1.841 ns WNS；需要确认融合阵列、量化 lane 和存储能否落入目标器件。 | 当前提交的 synth / opt 资源、时序、完整 DRC 报告与 DCP；重新运行 BRAM 专项正反检查。
P0可复现 Vivado 工程待补齐历史脚本依赖外部 Lab6 引脚约束 | 仓库配置 XDC 仅设置电压，不是完整引脚约束；clk_wiz_0 也需要明确 IP 生成配置。 | 纳入板级引脚 / IOSTANDARD、Clocking Wizard 生成步骤、源清单和独立批处理入口。
P0布线后时序与 I/O 约束未验收远程未见当前版 place / route 报告 | 综合网表估计不能覆盖实际互连、保持时间、JTAG 跨域和板级延迟。 | 补齐约束与时钟关系，完成布局布线；提交 setup / hold、未约束路径和完整实现 DRC 审计。
P1JTAG / 装载 / 真实模型未上板闭环未找到实际板卡验收记录 | 还不能证明真实时钟复位、debugger、SRAM 程序写入和结果读取可靠。 | bitstream 下载；LED / reset 检查；halt / resume、SRAM 读写；同一模型和向量在板上与 golden 比较。
P1DSP 流水线建议需重新审计历史版本保留 47 项性能建议 | 若当前融合版关键路径涉及 DSP，可能需要寄存器改造；改造会影响阵列调度和延迟。 | 先确认当前版路径，再决定是否加流水线；有 RTL 改动时重跑数值及逐周期对拍。
P2EDA 工具与检查覆盖边界Xcelium 可用；VCS / DC 暂不可用 | VCS 缺 libelf.so.1；DC 报 DCSH-1。Xcelium 不支持一项 deferred final 断言，默认 VCD 可见性有限。 | 保持 Xcelium 可复现入口；需要 VCS / DC 时修复环境；专项补查该断言，调试波形启用 +access+r。

soc 上的 ASIC 技术库未指定，是映射综合的前置条件；它不替代 FPGA 目标器件与 Vivado 工程。当前没有可报告的 ASIC 面积、STA 或 FPGA 上板性能。

05 / 下一轮交付

## 把验证结果带到板上

每一步都有明确产物与验收条件

01

### 复现当前 FPGA 工程

固定源提交和目标器件，补入板级 XDC 与时钟 IP 生成脚本，重新综合融合 Flat SoC。

交付：工程脚本 + 资源 / DRC / 综合时序

02

### 实现与时序收敛

完成 place / route，定位实际关键路径。优先保留已验证握手；必要的流水线改动同步更新事件验收。

交付：实现 DCP + 时序 / DRC + bitstream

03

### 板级端到端验收

按时钟复位→JTAG→CPU/DMA→NPU 顺序联调；加载同一真实语音模型向量，读取 logits 和周期计数。

交付：上板日志 + golden 对拍 + 实测延迟

### 交流时建议强调

已有历史 FPGA 结构修复，也有当前融合核的数值与系统仿真证据。当前最需要的是融合版本的完整 Vivado 复现、布线时序及真实板卡闭环，才能将“仿真通过”推进为“可部署并验证”。

06 / 证据与复现

## 数据来源与适用版本

报告单文件离线可用；以下路径供定位原始资料

GitHub 远程核对：当前版本确实已跑过 RTL 回归

2026-10-14 已重新 fetch 全部远程分支，并查询全部 PR 和最新 Actions。远程 main 为 8394533；所有其他远程分支均无尚未合入 main 的提交，当前没有未合并 PR。

当前 main 的 TinyCNN RTL regression CI (https://github.com/ScoreForever/ChipDesign/actions/runs/38530366574) 已成功。这是功能回归证据；融合核文档 (https://github.com/ScoreForever/ChipDesign/blob/8394533c5f3830dd3825f76d0a360b82407d573c/hardware/npu/TINYCNN8_FUSED.md)仍注明尚未取得本融合配置的综合结果。FPGA DRC 文档 (https://github.com/ScoreForever/ChipDesign/blob/8394533c5f3830dd3825f76d0a360b82407d573c/docs/FPGA_DRC_CLOSURE.md)明确其 PPA 数据属于历史 GAP 配置。

“未找到 FPGA 记录”表示当前可访问仓库的证据缺口，不等于认定其他机器上没有执行过；取得匹配当前提交的报告后应更新此状态。真实语音和 soc 新一轮记录由本轮验证分支发布；未合入 main 前，应按对应分支查看新增证据。

历史 FPGA 结果来源与版本

依据仓库 docs/FPGA_STRUCTURE_OPTIMIZATION.md 与 docs/FPGA_DRC_CLOSURE.md。对应提交 7569a43 的 GAP 核。LUT 21,243 → 19,425 为首次结构优化；含 DRC 修正的最终值为 19,368。本报告采用最终值。

历史记录目录：work/vivado_drc_fix_20261014/，包含综合、优化、DRC、DCP 与专项正反测试。当前报告按文档转述历史数据，未在 soc 上重跑 Vivado。

当前模型 / RTL / SoC 验证来源

PR #5 合并基线：8394533；验证工具提交：7c1348c，分支 codex/fused-speech-events。新一轮 soc 在此基础上叠加 Linux 回归入口、综合脚本，以及顶层 INIT_FILE 参数兼容修正；修正后 7 项回归再次全部通过。

当前摘要：docs/validation/tinycnn8_fused_speech_20261014.json、docs/validation/tinycnn8_accuracy_20261014.json、docs/validation/soc_eda_20261014.json。

模型包 SHA256：2c393a3ca92f77dfbf24605f5e8047bdf116b94e8fdf356e7d2a0c384030a595。真实向量逐文件与 WAV 来源均有 hash。独立事件检查适用固定 4×8 核，不预测任意新架构。

soc 服务器目录与回归命令

独立部署根目录：/home/s2400012892/chip-fullstack-2026/ChipDesign_20261014_fused/。子目录 src/、inputs/、results/；最终回归日志在 results/structure_final/，Genus 读入日志在 results/genus_read_final/。

ssh soc
source /opt/eda/env.sh
cd /home/s2400012892/chip-fullstack-2026/ChipDesign_20261014_fused/src
python3 hardware/soc/sim/scripts/run_structure_regression.py \
  --output ../results/structure_new
# 输出目录需为空，以保留已有证据。

ChipDesign · FPGA 验证交流报告 · 2026-10-14统计边界：历史 FPGA / 当前 RTL 仿真 / 待完成板级验收
