ScoreForever/ChipDesign/docs/validation/nocpu_operator_trace_20261024.csv

test | job | pc | operator | descriptor | start_cycle | end_cycle | duration_cycles | wait_activation_cycles | wait_weight_cycles | wait_slot_cycles | mac_issues
watchdog_recovery | 2 | 0 | Conv+Requant+ReLU+MaxPool | 1793 | 0 | 451 | 451 | 147 | 31 | 0 | 168
watchdog_recovery | 2 | 1 | FC+Requant+ReLU | 770 | 451 | 764 | 313 | 0 | 130 | 0 | 16
cnn_f1_first | 7 | 0 | Conv+Requant+ReLU+MaxPool | 1793 | 0 | 451 | 451 | 147 | 31 | 0 | 168
cnn_f1_first | 7 | 1 | FC+Requant+ReLU | 770 | 451 | 764 | 313 | 0 | 130 | 0 | 16
cnn_f1_reuse | 8 | 0 | Conv+Requant+ReLU+MaxPool | 1793 | 0 | 451 | 451 | 147 | 31 | 0 | 168
cnn_f1_reuse | 8 | 1 | FC+Requant+ReLU | 770 | 451 | 764 | 313 | 0 | 130 | 0 | 16
cnn_f0_first | 9 | 0 | Conv | 4097 | 0 | 531 | 531 | 146 | 32 | 82 | 168
cnn_f0_first | 9 | 1 | Requant | 2053 | 531 | 898 | 367 | 0 | 0 | 0 | 0
cnn_f0_first | 9 | 2 | ReLU | 4 | 898 | 1231 | 333 | 0 | 0 | 0 | 0
cnn_f0_first | 9 | 3 | MaxPool | 3 | 1231 | 1528 | 297 | 0 | 0 | 0 | 0
cnn_f0_first | 9 | 4 | FC | 4098 | 1528 | 1833 | 305 | 0 | 130 | 0 | 16
cnn_f0_first | 9 | 5 | Requant | 2053 | 1833 | 1988 | 155 | 0 | 0 | 0 | 0
cnn_f0_first | 9 | 6 | ReLU | 4 | 1988 | 2069 | 81 | 0 | 0 | 0 | 0
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
