ScoreForever/ChipDesign/docs/validation/nocpu_performance_50mhz_20261024.csv

test | job | output_bytes | model_sha256 | input_sha256 | actual_sha256 | active_cycles | model_requests | model_stall_cycles | model_max_stall | model_responses | model_wait_response_cycles | activation_requests | activation_stall_cycles | activation_max_stall | activation_responses | activation_wait_response_cycles | writes | mac_issues | mac_wait_activation_cycles | mac_wait_weight_cycles | mac_wait_slot_cycles | kernel_prepare_cycles | result_slots_peak | weight_banks_peak | inflight_peak | post_lanes | gather_contiguous_groups | gather_scalar_groups | gather_zero_groups
watchdog_recovery | 13 | 11 | 334f601b678cf825acb6085cea0b1726033bef95c4e6b96a918367c9f2dd94c1 | a4af7548f96a1b1c567a843ae86f27e1aa239b889aa3ea884f344f92463b886d | ff4123615aba55260668e26207f6d808df2cfc7326cef00ab5820896eff946f0 | 764 | 320 | 0 | 0 | 320 | 0 | 227 | 0 | 0 | 227 | 0 | 41 | 184 | 147 | 161 | 0 | 30 | 4 | 2 | 11 | 41 | 131 | 24 | 29
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
