ScoreForever/ChipDesign/docs/validation/eda_latest_20261111/physical_area_modules.csv

group | count | area_um2 | sequential_count | sequential_area_um2 | combinational_area_um2
backend_or_unattributed | 45 | 377.57440000000133 | 0 | 0.0 | 377.57440000000133
shared_store_logic | 8629 | 158860.0384000126 | 1289 | 59983.83999999987 | 98876.19840001271
controller | 3200 | 60725.8175999982 | 518 | 23157.164800000122 | 37568.652799998075
NPU | 50532 | 1188325.4208001266 | 14251 | 634026.4447999522 | 554298.9760001744
host | 842 | 23168.140800000136 | 353 | 17142.31680000003 | 6025.824000000106
