ScoreForever/ChipDesign/docs/validation/eda_latest_20261111/rtl_full_cases.csv

case | status | cold_cycles | hot_cycles | cold_writes | hot_writes | checked_write_events | trace_rows | model_image_bytes | peak_activation_bytes | compiled_groups
cnn_c8_f1_j0 | PASS | 523 | 522 | 24 | 24 | 48 | 306 | 512 | 51 | [["Conv", "Requant", "ReLU", "MaxPool"], ["FC", "Requant", "ReLU"]]
cnn_c8_f0_j0 | PASS | 1444 | 1444 | 305 | 305 | 610 | 482 | 896 | 576 | [["Conv"], ["Requant"], ["ReLU"], ["MaxPool"], ["FC"], ["Requant"], ["ReLU"]]
pool_first_c8_f1_j0 | PASS | 660 | 660 | 114 | 114 | 228 | 338 | 472 | 65 | [["ReLU"], ["MaxPool", "Requant"], ["Conv", "Requant"], ["FC"]]
pool_first_c8_f0_j0 | PASS | 979 | 979 | 180 | 180 | 360 | 411 | 636 | 255 | [["ReLU"], ["MaxPool"], ["Requant"], ["Conv"], ["Requant"], ["FC"]]
mlp_c8_f1_j0 | PASS | 360 | 360 | 23 | 23 | 46 | 281 | 404 | 63 | [["FC", "ReLU"], ["Requant"], ["FC"]]
mlp_c8_f0_j0 | PASS | 471 | 471 | 36 | 36 | 72 | 313 | 468 | 63 | [["FC"], ["ReLU"], ["Requant"], ["FC"]]
i32_pool_c8_f1_j0 | PASS | 187 | 186 | 20 | 20 | 40 | 206 | 168 | 56 | [["Conv", "MaxPool", "ReLU"], ["Requant"]]
i32_pool_c8_f0_j0 | PASS | 483 | 483 | 80 | 80 | 160 | 270 | 296 | 248 | [["Conv"], ["MaxPool"], ["ReLU"], ["Requant"]]
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
