ScoreForever/ChipDesign/docs/validation/branch_integration_20261110/cdc_limits.csv

kind | SYS_NS | TCK_LO | TCK_HI | N | SEED | sys_ns | tck_lo | tck_hi | jitter | meta | reset | n | resets | meta_req | meta_ack | meta_rst | min_req_margin_ns | min_rsp_margin_ns | max_polls | mean_polls | ovr_hit | ovr_legal | bound_ns | envelope | status | JITTER | META | RESET | BP | OVR
grid | 5 | 2.5 | 2.5 | 120 | 1 | 5.00 | 2.50 | 2.50 | 0 | 0 | 0 | 120 | 0 | 0 | 0 | 0 | 10.010 | 10.050 | 2 | 2.00 | 0 | 0 | 20.0 | OUTSIDE | PASS
grid | 5 | 2.5 | 2.5 | 120 | 2 | 5.00 | 2.50 | 2.50 | 0 | 0 | 0 | 120 | 0 | 0 | 0 | 0 | 10.010 | 10.040 | 2 | 2.00 | 0 | 0 | 20.0 | OUTSIDE | PASS
grid | 5 | 5 | 5 | 120 | 1 | 5.00 | 5.00 | 5.00 | 0 | 0 | 0 | 120 | 0 | 0 | 0 | 0 | 10.010 | 20.040 | 2 | 2.00 | 0 | 0 | 20.0 | OUTSIDE | PASS
grid | 5 | 5 | 5 | 120 | 2 | 5.00 | 5.00 | 5.00 | 0 | 0 | 0 | 120 | 0 | 0 | 0 | 0 | 10.010 | 20.040 | 2 | 2.00 | 0 | 0 | 20.0 | OUTSIDE | PASS
grid | 5 | 10 | 10 | 120 | 1 | 5.00 | 10.00 | 10.00 | 0 | 0 | 0 | 120 | 0 | 0 | 0 | 0 | 10.010 | 40.320 | 2 | 2.00 | 0 | 0 | 20.0 | OUTSIDE | PASS
grid | 5 | 10 | 10 | 120 | 2 | 5.00 | 10.00 | 10.00 | 0 | 0 | 0 | 120 | 0 | 0 | 0 | 0 | 10.010 | 40.390 | 2 | 2.00 | 0 | 0 | 20.0 | OUTSIDE | PASS
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
