ScoreForever/ChipDesign/docs/validation/branch_integration_20261110/coverage.csv

label | suite | bin | hits | tests_hit | tests_total
integration_20261110 | behavioral_v2 | max_model_outstanding | 85 | 85 | 85
integration_20261110 | behavioral_v2 | model_outstanding_2 | 0 | 0 | 85
integration_20261110 | behavioral_v2 | model_outstanding_3 | 0 | 0 | 85
integration_20261110 | behavioral_v2 | weight_queue_full | 115560 | 41 | 85
integration_20261110 | behavioral_v2 | weight_queue_push_pop | 55604 | 37 | 85
integration_20261110 | behavioral_v2 | dw_row_from_hold | 64946 | 12 | 85
integration_20261110 | behavioral_v2 | zero_pad_row | 16480 | 41 | 85
integration_20261110 | behavioral_v2 | row_from_queue | 107074 | 49 | 85
integration_20261110 | behavioral_v2 | both_macros_busy | 57330 | 54 | 85
integration_20261110 | behavioral_v2 | side_port_blocked | 168 | 3 | 85
integration_20261110 | behavioral_v2 | side_port_claim | 168 | 3 | 85
integration_20261110 | behavioral_v2 | model_read_while_dirty | 0 | 0 | 85
integration_20261110 | behavioral_v2 | store_queue_full | 0 | 0 | 85
integration_20261110 | behavioral_v2 | store_queue_urgent | 896 | 3 | 85
integration_20261110 | behavioral_v2 | store_held_response | 0 | 0 | 85
integration_20261110 | behavioral_v2 | store_rmw | 48 | 2 | 85
integration_20261110 | behavioral_v2 | store_two_word_read | 15078 | 21 | 85
integration_20261110 | behavioral_v2 | core_fifo_full | 51842 | 23 | 85
integration_20261110 | behavioral_v2 | result_slots_full | 190146 | 46 | 85
integration_20261110 | behavioral_v2 | act_read_backpressure | 828 | 3 | 85
integration_20261110 | behavioral_v2 | act_write_backpressure | 164718 | 55 | 85
integration_20261110 | behavioral_v2 | op_conv | 320 | 39 | 85
integration_20261110 | behavioral_v2 | op_depthwise | 190 | 12 | 85
integration_20261110 | behavioral_v2 | op_conv_rowpad | 50 | 14 | 85
integration_20261110 | behavioral_v2 | op_fc | 96 | 27 | 85
integration_20261110 | behavioral_v2 | op_maxpool | 46 | 21 | 85
integration_20261110 | behavioral_v2 | op_relu | 2588 | 35 | 85
integration_20261110 | behavioral_v2 | op_requant | 108 | 28 | 85
integration_20261110 | behavioral_v2 | op_avgpool | 100 | 15 | 85
integration_20261110 | behavioral_v2 | op_add | 68 | 13 | 85
integration_20261110 | behavioral_v2 | fused_pool | 126 | 13 | 85
integration_20261110 | behavioral_v2 | narrow_tile | 66 | 29 | 85
integration_20261110 | behavioral_v2 | descriptor_failed | 0 | 0 | 85
integration_20261110 | fpga_mem_v2 | max_model_outstanding | 126 | 81 | 81
integration_20261110 | fpga_mem_v2 | model_outstanding_2 | 82552 | 45 | 81
integration_20261110 | fpga_mem_v2 | model_outstanding_3 | 0 | 0 | 81
integration_20261110 | fpga_mem_v2 | weight_queue_full | 100067 | 29 | 81
integration_20261110 | fpga_mem_v2 | weight_queue_push_pop | 676 | 21 | 81
integration_20261110 | fpga_mem_v2 | dw_row_from_hold | 64946 | 12 | 81
integration_20261110 | fpga_mem_v2 | zero_pad_row | 16424 | 39 | 81
integration_20261110 | fpga_mem_v2 | row_from_queue | 51230 | 45 | 81
integration_20261110 | fpga_mem_v2 | both_macros_busy | 57206 | 50 | 81
integration_20261110 | fpga_mem_v2 | side_port_blocked | 168 | 3 | 81
integration_20261110 | fpga_mem_v2 | side_port_claim | 168 | 3 | 81
integration_20261110 | fpga_mem_v2 | model_read_while_dirty | 0 | 0 | 81
integration_20261110 | fpga_mem_v2 | store_queue_full | 0 | 0 | 81
integration_20261110 | fpga_mem_v2 | store_queue_urgent | 896 | 3 | 81
integration_20261110 | fpga_mem_v2 | store_held_response | 0 | 0 | 81
integration_20261110 | fpga_mem_v2 | store_rmw | 48 | 2 | 81
integration_20261110 | fpga_mem_v2 | store_two_word_read | 15070 | 15 | 81
integration_20261110 | fpga_mem_v2 | core_fifo_full | 51624 | 21 | 81
integration_20261110 | fpga_mem_v2 | result_slots_full | 188724 | 42 | 81
integration_20261110 | fpga_mem_v2 | act_read_backpressure | 828 | 3 | 81
integration_20261110 | fpga_mem_v2 | act_write_backpressure | 163907 | 52 | 81
integration_20261110 | fpga_mem_v2 | op_conv | 312 | 35 | 81
integration_20261110 | fpga_mem_v2 | op_depthwise | 190 | 12 | 81
integration_20261110 | fpga_mem_v2 | op_conv_rowpad | 50 | 14 | 81
integration_20261110 | fpga_mem_v2 | op_fc | 88 | 25 | 81
integration_20261110 | fpga_mem_v2 | op_maxpool | 44 | 20 | 81
integration_20261110 | fpga_mem_v2 | op_relu | 2580 | 33 | 81
integration_20261110 | fpga_mem_v2 | op_requant | 98 | 26 | 81
integration_20261110 | fpga_mem_v2 | op_avgpool | 100 | 15 | 81
integration_20261110 | fpga_mem_v2 | op_add | 60 | 11 | 81
integration_20261110 | fpga_mem_v2 | fused_pool | 124 | 12 | 81
integration_20261110 | fpga_mem_v2 | narrow_tile | 62 | 27 | 81
integration_20261110 | fpga_mem_v2 | descriptor_failed | 0 | 0 | 81
integration_20261110 | fuzz | max_model_outstanding | 148 | 80 | 80
integration_20261110 | fuzz | model_outstanding_2 | 114820 | 68 | 80
integration_20261110 | fuzz | model_outstanding_3 | 0 | 0 | 80
integration_20261110 | fuzz | weight_queue_full | 91923 | 45 | 80
integration_20261110 | fuzz | weight_queue_push_pop | 2748 | 41 | 80
integration_20261110 | fuzz | dw_row_from_hold | 22834 | 10 | 80
integration_20261110 | fuzz | zero_pad_row | 4474 | 58 | 80
integration_20261110 | fuzz | row_from_queue | 45670 | 64 | 80
integration_20261110 | fuzz | both_macros_busy | 29212 | 64 | 80
integration_20261110 | fuzz | side_port_blocked | 0 | 0 | 80
integration_20261110 | fuzz | side_port_claim | 0 | 0 | 80
integration_20261110 | fuzz | model_read_while_dirty | 0 | 0 | 80
integration_20261110 | fuzz | store_queue_full | 0 | 0 | 80
integration_20261110 | fuzz | store_queue_urgent | 0 | 0 | 80
integration_20261110 | fuzz | store_held_response | 0 | 0 | 80
integration_20261110 | fuzz | store_rmw | 4880 | 21 | 80
integration_20261110 | fuzz | store_two_word_read | 18584 | 38 | 80
integration_20261110 | fuzz | core_fifo_full | 8426 | 27 | 80
integration_20261110 | fuzz | result_slots_full | 96621 | 50 | 80
integration_20261110 | fuzz | act_read_backpressure | 1660 | 16 | 80
integration_20261110 | fuzz | act_write_backpressure | 44306 | 60 | 80
integration_20261110 | fuzz | op_conv | 606 | 50 | 80
integration_20261110 | fuzz | op_depthwise | 132 | 10 | 80
integration_20261110 | fuzz | op_conv_rowpad | 12 | 1 | 80
integration_20261110 | fuzz | op_fc | 266 | 36 | 80
integration_20261110 | fuzz | op_maxpool | 70 | 20 | 80
integration_20261110 | fuzz | op_relu | 92 | 18 | 80
integration_20261110 | fuzz | op_requant | 124 | 16 | 80
integration_20261110 | fuzz | op_avgpool | 36 | 11 | 80
integration_20261110 | fuzz | op_add | 36 | 6 | 80
integration_20261110 | fuzz | fused_pool | 0 | 0 | 80
integration_20261110 | fuzz | narrow_tile | 128 | 47 | 80
integration_20261110 | fuzz | descriptor_failed | 0 | 0 | 80
integration_20261110 | gather | max_model_outstanding | 30 | 15 | 15
integration_20261110 | gather | model_outstanding_2 | 2432 | 15 | 15
integration_20261110 | gather | model_outstanding_3 | 0 | 0 | 15
integration_20261110 | gather | weight_queue_full | 2960 | 13 | 15
integration_20261110 | gather | weight_queue_push_pop | 0 | 0 | 15
integration_20261110 | gather | dw_row_from_hold | 0 | 0 | 15
integration_20261110 | gather | zero_pad_row | 368 | 13 | 15
integration_20261110 | gather | row_from_queue | 988 | 13 | 15
integration_20261110 | gather | both_macros_busy | 452 | 13 | 15
integration_20261110 | gather | side_port_blocked | 0 | 0 | 15
integration_20261110 | gather | side_port_claim | 0 | 0 | 15
integration_20261110 | gather | model_read_while_dirty | 0 | 0 | 15
integration_20261110 | gather | store_queue_full | 0 | 0 | 15
integration_20261110 | gather | store_queue_urgent | 0 | 0 | 15
integration_20261110 | gather | store_held_response | 0 | 0 | 15
integration_20261110 | gather | store_rmw | 1152 | 12 | 15
integration_20261110 | gather | store_two_word_read | 408 | 10 | 15
integration_20261110 | gather | core_fifo_full | 0 | 0 | 15
integration_20261110 | gather | result_slots_full | 4876 | 13 | 15
integration_20261110 | gather | act_read_backpressure | 432 | 12 | 15
integration_20261110 | gather | act_write_backpressure | 2370 | 13 | 15
integration_20261110 | gather | op_conv | 54 | 15 | 15
integration_20261110 | gather | op_depthwise | 0 | 0 | 15
integration_20261110 | gather | op_conv_rowpad | 0 | 0 | 15
integration_20261110 | gather | op_fc | 0 | 0 | 15
integration_20261110 | gather | op_maxpool | 0 | 0 | 15
integration_20261110 | gather | op_relu | 0 | 0 | 15
integration_20261110 | gather | op_requant | 0 | 0 | 15
integration_20261110 | gather | op_avgpool | 0 | 0 | 15
integration_20261110 | gather | op_add | 0 | 0 | 15
integration_20261110 | gather | fused_pool | 4 | 2 | 15
integration_20261110 | gather | narrow_tile | 24 | 12 | 15
integration_20261110 | gather | descriptor_failed | 0 | 0 | 15
integration_20261110 | mutation_baseline | max_model_outstanding | 52 | 30 | 30
integration_20261110 | mutation_baseline | model_outstanding_2 | 5080 | 22 | 30
integration_20261110 | mutation_baseline | model_outstanding_3 | 0 | 0 | 30
integration_20261110 | mutation_baseline | weight_queue_full | 3371 | 16 | 30
integration_20261110 | mutation_baseline | weight_queue_push_pop | 136 | 6 | 30
integration_20261110 | mutation_baseline | dw_row_from_hold | 3318 | 6 | 30
integration_20261110 | mutation_baseline | zero_pad_row | 972 | 20 | 30
integration_20261110 | mutation_baseline | row_from_queue | 2138 | 24 | 30
integration_20261110 | mutation_baseline | both_macros_busy | 1057 | 27 | 30
integration_20261110 | mutation_baseline | side_port_blocked | 0 | 0 | 30
integration_20261110 | mutation_baseline | side_port_claim | 0 | 0 | 30
integration_20261110 | mutation_baseline | model_read_while_dirty | 0 | 0 | 30
integration_20261110 | mutation_baseline | store_queue_full | 0 | 0 | 30
integration_20261110 | mutation_baseline | store_queue_urgent | 0 | 0 | 30
integration_20261110 | mutation_baseline | store_held_response | 0 | 0 | 30
integration_20261110 | mutation_baseline | store_rmw | 0 | 0 | 30
integration_20261110 | mutation_baseline | store_two_word_read | 89 | 7 | 30
integration_20261110 | mutation_baseline | core_fifo_full | 904 | 8 | 30
integration_20261110 | mutation_baseline | result_slots_full | 10982 | 21 | 30
integration_20261110 | mutation_baseline | act_read_backpressure | 0 | 0 | 30
integration_20261110 | mutation_baseline | act_write_backpressure | 5867 | 18 | 30
integration_20261110 | mutation_baseline | op_conv | 48 | 16 | 30
integration_20261110 | mutation_baseline | op_depthwise | 24 | 6 | 30
integration_20261110 | mutation_baseline | op_conv_rowpad | 8 | 4 | 30
integration_20261110 | mutation_baseline | op_fc | 36 | 8 | 30
integration_20261110 | mutation_baseline | op_maxpool | 18 | 8 | 30
integration_20261110 | mutation_baseline | op_relu | 24 | 8 | 30
integration_20261110 | mutation_baseline | op_requant | 62 | 14 | 30
integration_20261110 | mutation_baseline | op_avgpool | 12 | 6 | 30
integration_20261110 | mutation_baseline | op_add | 16 | 4 | 30
integration_20261110 | mutation_baseline | fused_pool | 10 | 5 | 30
integration_20261110 | mutation_baseline | narrow_tile | 28 | 12 | 30
integration_20261110 | mutation_baseline | descriptor_failed | 0 | 0 | 30
integration_20261110 | ra1shd_v2 | max_model_outstanding | 81 | 81 | 81
integration_20261110 | ra1shd_v2 | model_outstanding_2 | 0 | 0 | 81
integration_20261110 | ra1shd_v2 | model_outstanding_3 | 0 | 0 | 81
integration_20261110 | ra1shd_v2 | weight_queue_full | 114944 | 37 | 81
integration_20261110 | ra1shd_v2 | weight_queue_push_pop | 55244 | 33 | 81
integration_20261110 | ra1shd_v2 | dw_row_from_hold | 64946 | 12 | 81
integration_20261110 | ra1shd_v2 | zero_pad_row | 16424 | 39 | 81
integration_20261110 | ra1shd_v2 | row_from_queue | 106474 | 45 | 81
integration_20261110 | ra1shd_v2 | both_macros_busy | 57202 | 50 | 81
integration_20261110 | ra1shd_v2 | side_port_blocked | 168 | 3 | 81
integration_20261110 | ra1shd_v2 | side_port_claim | 168 | 3 | 81
integration_20261110 | ra1shd_v2 | model_read_while_dirty | 0 | 0 | 81
integration_20261110 | ra1shd_v2 | store_queue_full | 0 | 0 | 81
integration_20261110 | ra1shd_v2 | store_queue_urgent | 896 | 3 | 81
integration_20261110 | ra1shd_v2 | store_held_response | 0 | 0 | 81
integration_20261110 | ra1shd_v2 | store_rmw | 48 | 2 | 81
integration_20261110 | ra1shd_v2 | store_two_word_read | 15077 | 20 | 81
integration_20261110 | ra1shd_v2 | core_fifo_full | 51624 | 21 | 81
integration_20261110 | ra1shd_v2 | result_slots_full | 188718 | 42 | 81
integration_20261110 | ra1shd_v2 | act_read_backpressure | 828 | 3 | 81
integration_20261110 | ra1shd_v2 | act_write_backpressure | 163907 | 52 | 81
integration_20261110 | ra1shd_v2 | op_conv | 312 | 35 | 81
integration_20261110 | ra1shd_v2 | op_depthwise | 190 | 12 | 81
integration_20261110 | ra1shd_v2 | op_conv_rowpad | 50 | 14 | 81
integration_20261110 | ra1shd_v2 | op_fc | 88 | 25 | 81
integration_20261110 | ra1shd_v2 | op_maxpool | 44 | 20 | 81
integration_20261110 | ra1shd_v2 | op_relu | 2580 | 33 | 81
integration_20261110 | ra1shd_v2 | op_requant | 98 | 26 | 81
integration_20261110 | ra1shd_v2 | op_avgpool | 100 | 15 | 81
integration_20261110 | ra1shd_v2 | op_add | 60 | 11 | 81
integration_20261110 | ra1shd_v2 | fused_pool | 124 | 12 | 81
integration_20261110 | ra1shd_v2 | narrow_tile | 62 | 27 | 81
integration_20261110 | ra1shd_v2 | descriptor_failed | 0 | 0 | 81
