ScoreForever/ChipDesign/docs/validation/eda_lab5_20261110/area_optimization/fullchip_icg/physical_r2/macro_pins.tsv

i_control/i_activation_i_store_g_bank[1].i_sram | R90 | E | 64 | 0.493 | -0.000
i_control/i_activation_i_store_g_bank[0].i_sram | R270 | W | 64 | -0.493 | 0.000
