ScoreForever/ChipDesign/output/npu-gather/20261108/performance_counters.csv

model | repeat | active_cycles | model_requests | model_stall_cycles | model_max_stall | model_responses | model_wait_response_cycles | activation_requests | activation_stall_cycles | activation_max_stall | activation_responses | activation_wait_response_cycles | writes | mac_issues | mac_wait_activation_cycles | mac_wait_weight_cycles | mac_wait_slot_cycles | kernel_prepare_cycles | result_slots_peak | weight_banks_peak | inflight_peak | post_lanes | gather_contiguous_groups | gather_scalar_groups | gather_zero_groups
ecg | 1 | 15854 | 2837 | 1 | 1 | 2837 | 2837 | 5116 | 1199 | 1 | 5116 | 3 | 5397 | 4612 | 1273 | 1129 | 3706 | 696 | 4 | 2 | 14 | 5397 | 4540 | 0 | 72
ecg | 2 | 15854 | 2837 | 1 | 1 | 2837 | 2837 | 5116 | 1199 | 1 | 5116 | 3 | 5397 | 4612 | 1273 | 1129 | 3706 | 696 | 4 | 2 | 14 | 5397 | 4540 | 0 | 72
fashion_cnn | 1 | 47176 | 13244 | 1 | 1 | 13244 | 13244 | 23372 | 7289 | 1 | 23372 | 82 | 3162 | 25880 | 7982 | 7536 | 688 | 3628 | 4 | 2 | 15 | 3162 | 23176 | 0 | 2704
fashion_cnn | 2 | 47176 | 13244 | 1 | 1 | 13244 | 13244 | 23372 | 7289 | 1 | 23372 | 82 | 3162 | 25880 | 7982 | 7536 | 688 | 3628 | 4 | 2 | 15 | 3162 | 23176 | 0 | 2704
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
