ScoreForever/ChipDesign/output/npu-performance/20261107/performance_counters.csv

case | version | active_cycles | model_requests | model_stall_cycles | model_max_stall | model_responses | model_wait_response_cycles | activation_requests | activation_stall_cycles | activation_max_stall | activation_responses | activation_wait_response_cycles | writes | mac_issues | mac_wait_activation_cycles | mac_wait_weight_cycles | mac_wait_slot_cycles | kernel_prepare_cycles | result_slots_peak | weight_banks_peak | inflight_peak | post_lanes | gather_contiguous_groups | gather_scalar_groups | gather_zero_groups
packaged_ecg_c8_f1_j0 | previous_board | 23645 | 2837 | 1589 | 2 | 2837 | 5674 | 5116 | 3366 | 2 | 5116 | 5116 | 5397 | 4612 | 7452 | 560 | 2862 | 2628 | 4 | 2 | 8 | 5397 | 4540 | 0 | 72
packaged_ecg_c8_f1_j0 | candidate | 15860 | 2837 | 35 | 1 | 2837 | 2837 | 5116 | 1164 | 1 | 5116 | 3 | 5397 | 4612 | 1273 | 1134 | 3707 | 696 | 4 | 2 | 14 | 5397 | 4540 | 0 | 72
packaged_fashion_cnn_c8_f1_j0 | previous_board | 90872 | 13244 | 8484 | 2 | 13244 | 26488 | 23372 | 18067 | 2 | 23372 | 23449 | 3162 | 25880 | 42624 | 3514 | 668 | 16326 | 4 | 2 | 11 | 3162 | 23176 | 0 | 2704
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
