ScoreForever/ChipDesign/docs/validation/eda_latest_20261111/images/final_congestion.png

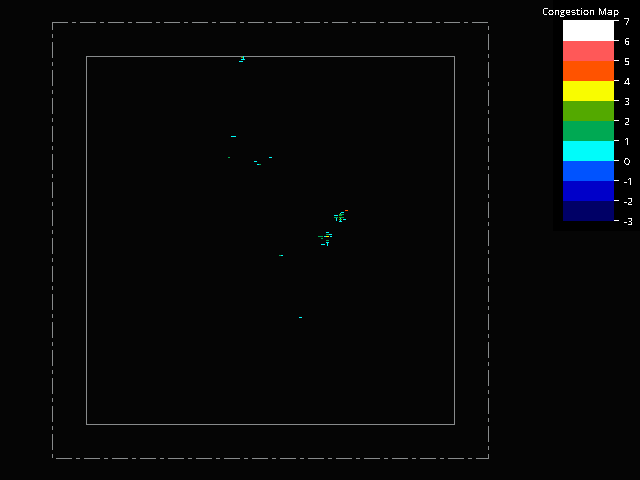
docs/validation/eda_latest_20261111/images/final_congestion.png
