ScoreForever/ChipDesign/docs/validation/eda_latest_20261111/images/final_density.png

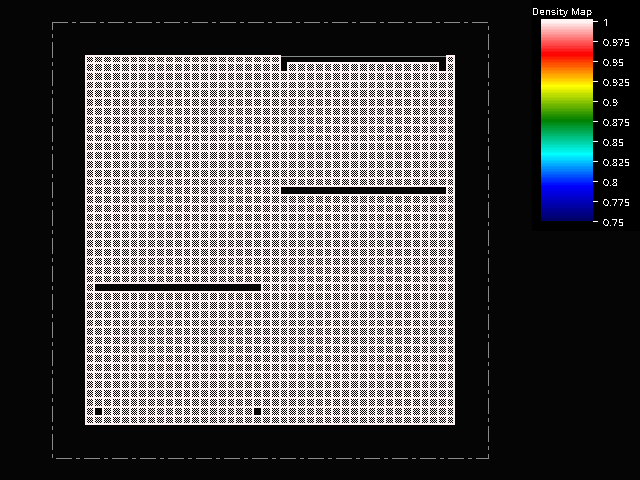
docs/validation/eda_latest_20261111/images/final_density.png
