ScoreForever/ChipDesign/docs/validation/eda_latest_20261111/images/final_route_all.png

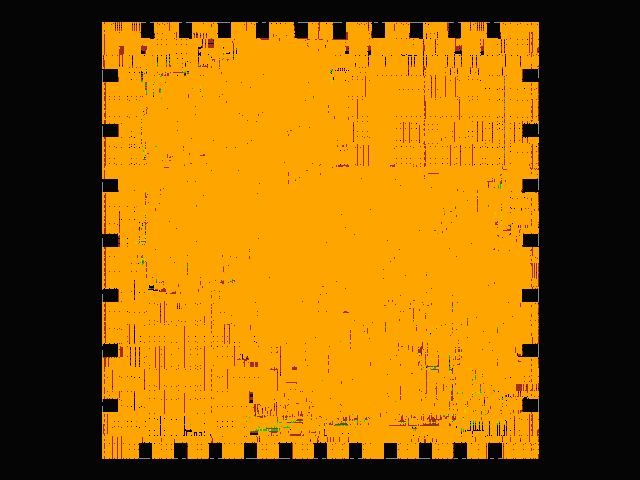
docs/validation/eda_latest_20261111/images/final_route_all.png
