ScoreForever/ChipDesign/docs/validation/nocpu_dual_sram_layout_20261026/2_power.png

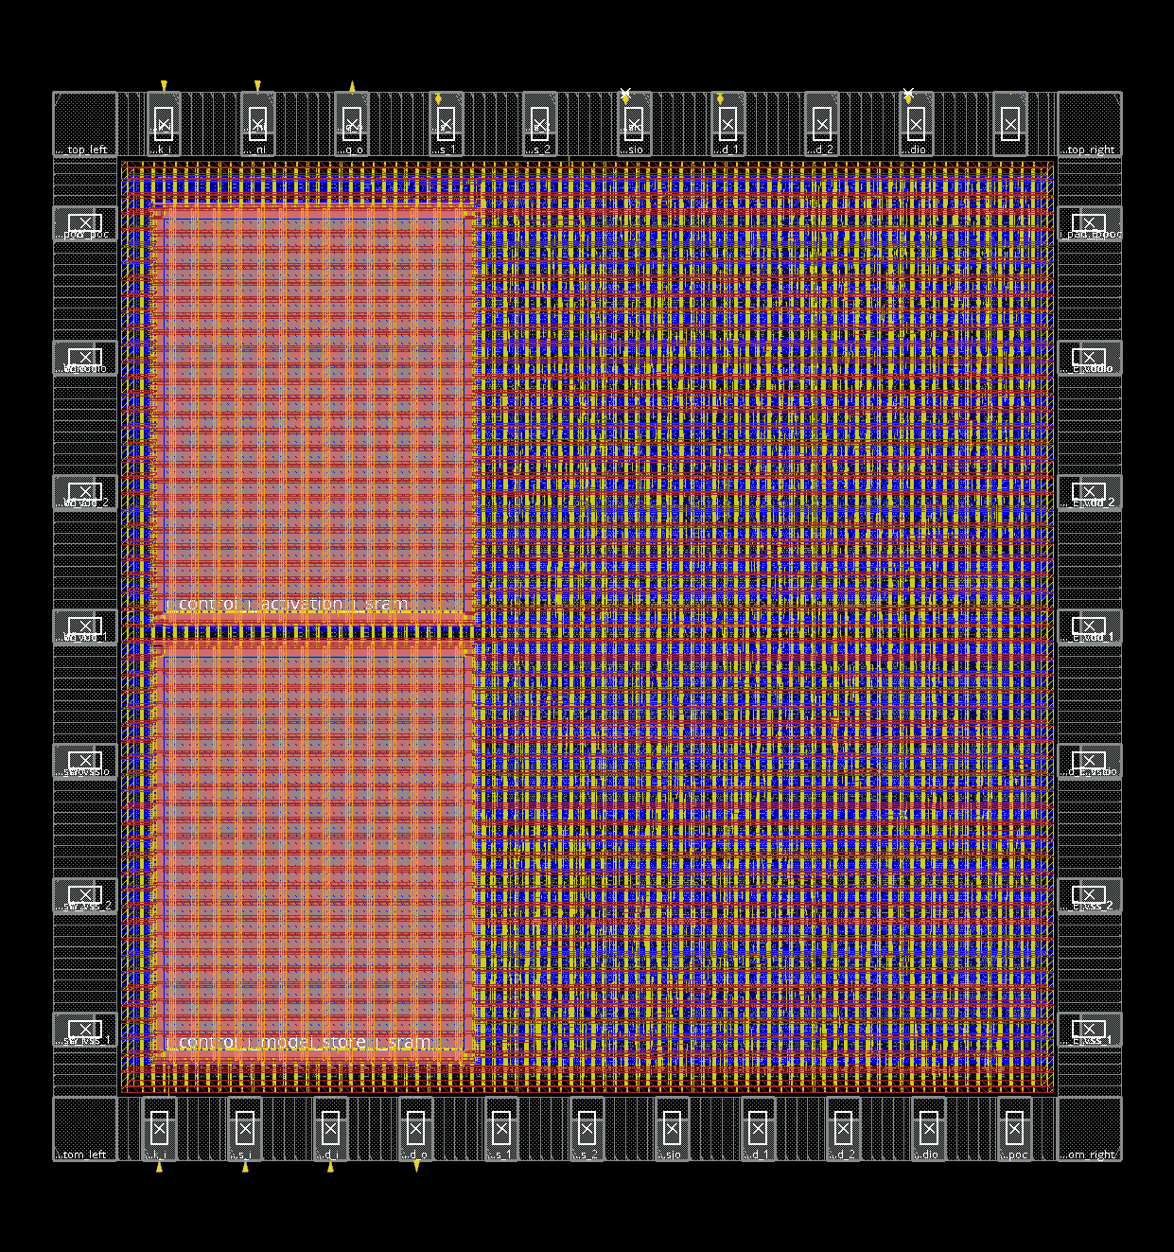
docs/validation/nocpu_dual_sram_layout_20261026/2_power.png
