ScoreForever/ChipDesign/docs/validation/nocpu_dual_sram_layout_20261026/4a_m56_no_fill.png

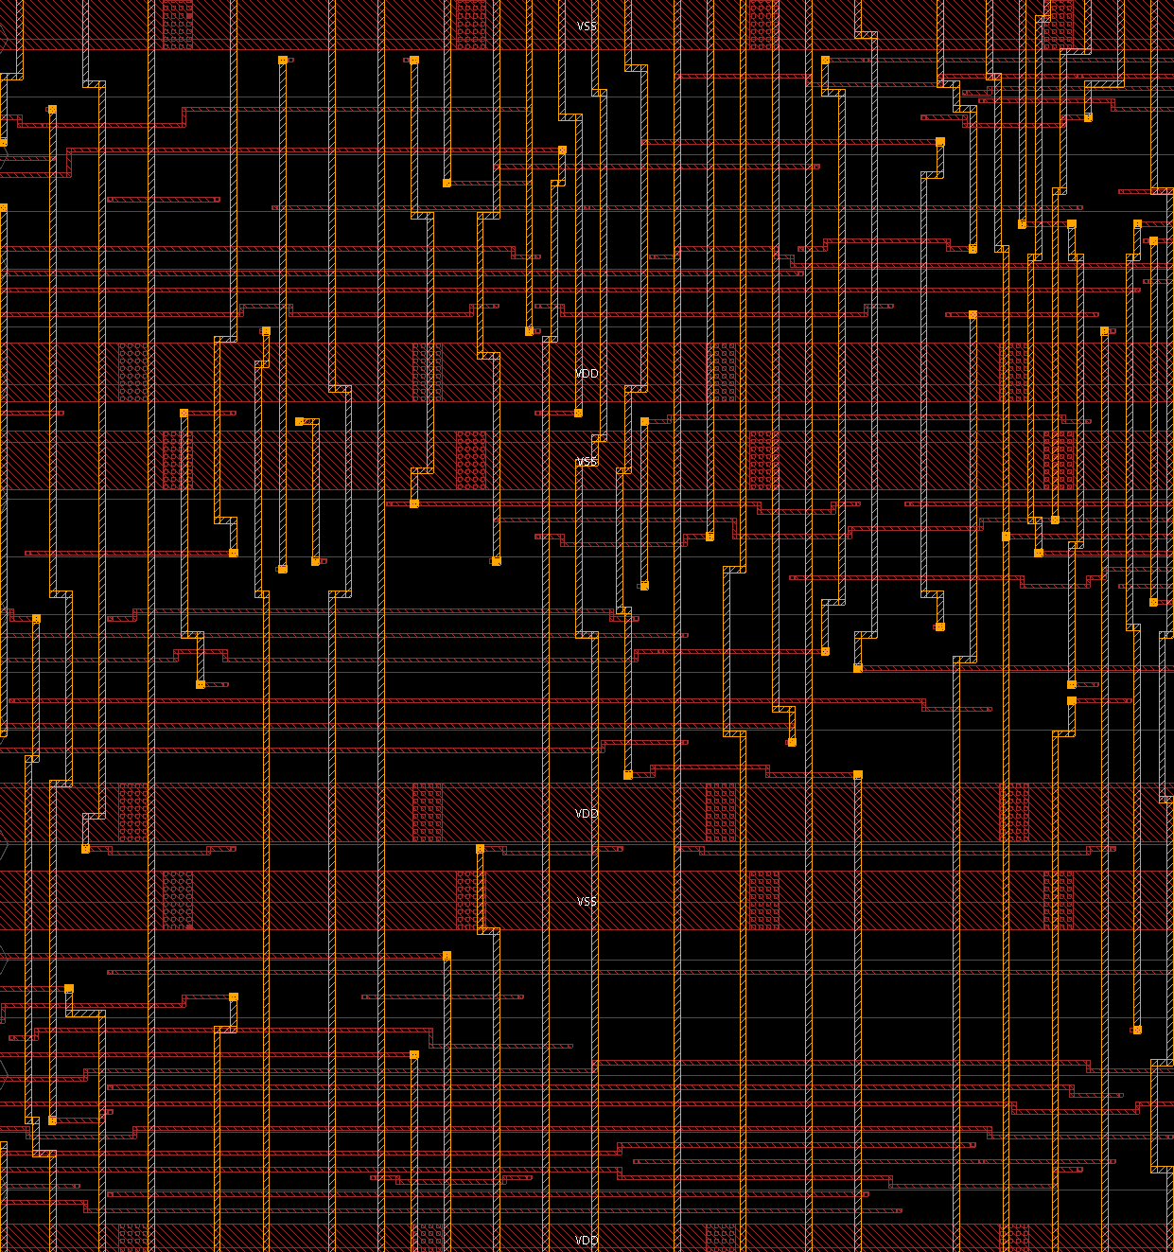
docs/validation/nocpu_dual_sram_layout_20261026/4a_m56_no_fill.png
