ScoreForever/ChipDesign/docs/validation/nocpu_dual_sram_layout_20261026/4b_m56_with_fill.png

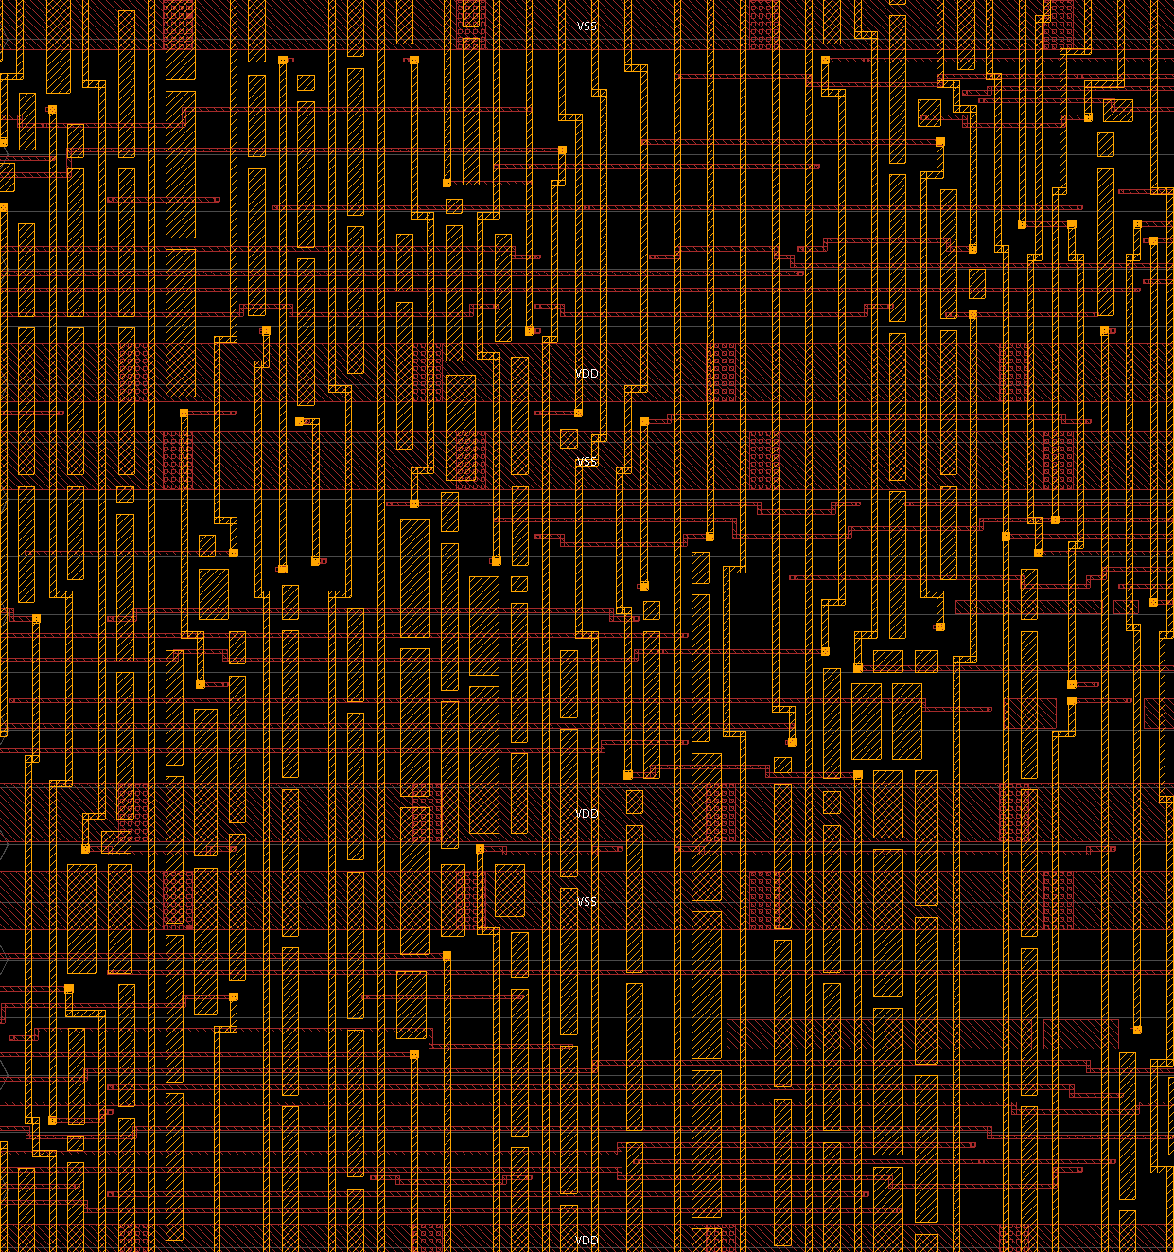
docs/validation/nocpu_dual_sram_layout_20261026/4b_m56_with_fill.png
