ScoreForever/ChipDesign/docs/validation/nocpu_dual_sram_layout_20261026/5_all.png

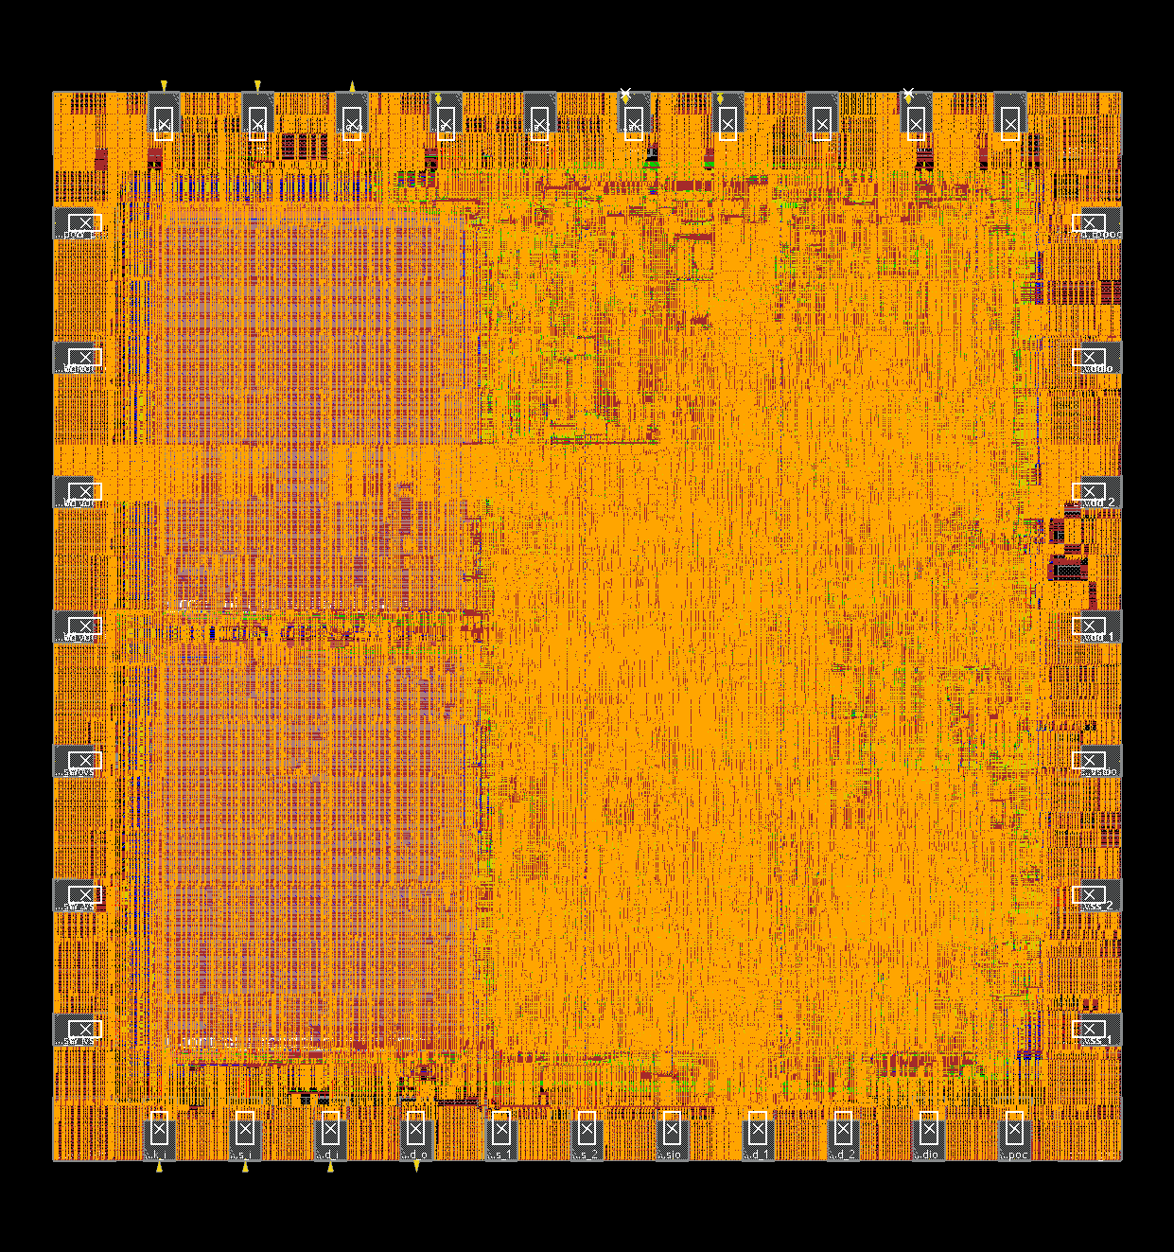
docs/validation/nocpu_dual_sram_layout_20261026/5_all.png
