ScoreForever/ChipDesign/hardware/npu/tb/tb_tinycnn8_mmio_fileio.sv

`timescale 1ns/1ps
// File-backed end-to-end MMIO test. Only the observer uses hierarchy; all
// model/input loading and result/profile reads go through the real MMIO ABI.
module tb_tinycnn8_mmio_fileio #(
    parameter OPT_GATHER_LOAD=0, OPT_SPATIAL_TILE=0, SPATIAL_TILE=16
);
    reg clk=0,rst_ni=0,req=0,we=0;
    reg [31:0] addr=0,wdata=0;
    wire [31:0] rdata;
    wire irq;
    always #5 clk=~clk;
    // The observer probes layered-core internals, so pin the reference core.
    tinycnn8_npu_mmio_wrapper #(.FUSED_CORE(0),.OPT_GATHER_LOAD(OPT_GATHER_LOAD),
        .OPT_SPATIAL_TILE(OPT_SPATIAL_TILE),.SPATIAL_TILE(SPATIAL_TILE)) dut(
        .clk_i(clk),.rst_ni(rst_ni),.req_i(req),.we_i(we),.addr_i(addr),
        .wdata_i(wdata),.rdata_o(rdata),.irq_o(irq),
        .dma_src_o(),.dma_dst_o(),.dma_len_o(),.dma_start_o(),
        .dma_irq_en_o(),.dma_clear_done_o(),.dma_busy_i(1'b0),.dma_done_i(1'b0));
    reg [7:0] input_image[0:319],shift_image[0:31];
    reg [63:0] weight_image[0:255];
    reg [31:0] bias_image[0:31],mult_image[0:31],golden[0:7];
    string data_dir,out_dir,data_dir2;
    integer classes=6,cycle=0,accepted_writes=0;
    integer load_cycles,load_writes,load_begin,write_begin;
    integer perf_fd,logit_fd,job,index,lane,group;
    integer mon_i,read_i,load_i,load_g,load_l,profile_i,result_i,output_i,snapshot_i,reset_i;
    integer mon_total=0,mon_layer[0:5],mon_weights=0,mon_issues=0,mon_retires=0;
    integer mon_phase=0,mon_inflight=0,mon_peak=0;
    reg mon_active=0;
    reg [31:0] value,profile[0:11],snapshot[0:11];
    // Independent observer derives layer transitions from engine handshakes,
    // never from sequencer state or any hardware profile counter/event port.
    always @(posedge clk) begin
        cycle=cycle+1;
        if(rst_ni && dut.npu_start_pulse && dut.npu_start_ready)begin
            mon_active=1;mon_phase=0;mon_total=0;mon_weights=0;
            mon_issues=0;mon_retires=0;mon_inflight=0;mon_peak=0;
            for(mon_i=0;mon_i<6;mon_i=mon_i+1)mon_layer[mon_i]=0;
        end else if(mon_active)begin
            mon_total=mon_total+1;mon_layer[mon_phase]=mon_layer[mon_phase]+1;
            if(dut.g_core.i_tinycnn8_npu.perf_inflight!==mon_inflight[7:0])
                $fatal(1,"live inflight mismatch expected=%0d actual=%0d",mon_inflight,
                    dut.g_core.i_tinycnn8_npu.perf_inflight);
            if(mon_inflight>mon_peak)mon_peak=mon_inflight;
            if(dut.g_core.i_tinycnn8_npu.conv.matrix_weight_valid &&
               dut.g_core.i_tinycnn8_npu.conv.matrix_weight_ready)mon_weights=mon_weights+1;
            if(dut.g_core.i_tinycnn8_npu.conv.matrix_in_valid &&
               dut.g_core.i_tinycnn8_npu.conv.matrix_in_ready)begin
                mon_issues=mon_issues+1;mon_inflight=mon_inflight+1;
            end
            if(dut.g_core.i_tinycnn8_npu.conv.matrix_out_valid &&
               dut.g_core.i_tinycnn8_npu.conv.matrix_out_ready)begin
                mon_retires=mon_retires+1;mon_inflight=mon_inflight-1;
            end
            if(mon_inflight<0)$fatal(1,"negative matrix inflight");
            case(mon_phase)
                0,2:if(dut.g_core.i_tinycnn8_npu.conv_done)mon_phase=mon_phase+1;
                1:if(dut.g_core.i_tinycnn8_npu.pool_done)mon_phase=2;
                3:if(dut.g_core.i_tinycnn8_npu.pool_done)mon_phase=5;
                5:if(dut.g_core.i_tinycnn8_npu.conv_done)mon_active=0;
            endcase
        end
    end
    task mmio_write(input [15:0] offset,input [31:0] val);
        begin
            @(negedge clk);req=1;we=1;addr={16'h7000,offset};wdata=val;
            @(negedge clk);req=0;we=0;
        end
    endtask
    task mmio_read(input [15:0] offset,output [31:0] val);
        begin
            @(negedge clk);req=1;we=0;addr={16'h7000,offset};
            @(negedge clk);val=rdata;req=0;
        end
    endtask
    task load_write(input [15:0] offset,input [31:0] val);
        begin mmio_write(offset,val);accepted_writes=accepted_writes+1;end
    endtask
    task read_images(input string dir);
        begin
            for(read_i=0;read_i<8;read_i=read_i+1)golden[read_i]=0;
            $readmemh({dir,"/input.hex"},input_image);
            $readmemh({dir,"/weights.hex"},weight_image);
            $readmemh({dir,"/bias.hex"},bias_image);
            $readmemh({dir,"/multiplier.hex"},mult_image);
            $readmemh({dir,"/shift.hex"},shift_image);
            $readmemh({dir,"/golden_fc.hex"},golden,0,classes-1);
            for(read_i=0;read_i<24;read_i=read_i+1)
                if(shift_image[read_i][5:0]==6'b100000)$fatal(1,"golden model has reserved shift -32");
        end
    endtask
    task load_model(input bit full_model);
        begin
            load_begin=cycle;write_begin=accepted_writes;
            for(load_i=0;load_i<320;load_i=load_i+1)
                load_write(16'h1000+load_i*4,{24'd0,input_image[load_i]});
            if(full_model)begin
                for(load_i=0;load_i<256;load_i=load_i+1)begin
                    load_write(16'h2000+load_i*8,weight_image[load_i][31:0]);
                    load_write(16'h2004+load_i*8,weight_image[load_i][63:32]);
                end
                for(load_g=0;load_g<4;load_g=load_g+1)begin
                    if(load_g!=2)begin
                        for(load_l=0;load_l<8;load_l=load_l+1)begin
                            load_write(16'h3000+load_g*256+load_l*4,bias_image[load_g*8+load_l]);
                            load_write(16'h3020+load_g*256+load_l*4,mult_image[load_g*8+load_l]);
                            load_write(16'h3040+load_g*256+load_l*4,
                                {{24{shift_image[load_g*8+load_l][7]}},shift_image[load_g*8+load_l]});
                        end
                        load_write(16'h3060+load_g*256,1);
                    end
                end
            end
            // Drain the wrapper's registered native-host write before start.
            @(negedge clk);
            load_cycles=cycle-load_begin;load_writes=accepted_writes-write_begin;
            mmio_read(16'h000c,value);
            if(value!==0)$fatal(1,"load error %0d",value);
            if(load_writes!=(full_model?907:320))$fatal(1,"load transaction count mismatch");
        end
    endtask
    task read_profile;
        begin
            for(profile_i=0;profile_i<12;profile_i=profile_i+1)
                mmio_read(16'h0040+profile_i*4,profile[profile_i]);
        end
    endtask
    task expect_error(input [31:0] code);
        begin
            mmio_read(16'h000c,value);
            if(value!==code)$fatal(1,"error expected=%0d actual=%0d",code,value);
            mmio_write(0,8);
        end
    endtask
    task run_job(input integer number,input bit irq_enabled);
        integer timeout_count,sum_layers;
        begin
            mmio_write(0,irq_enabled?3:1);
            // Illegal busy start and input write must not restart or clear profile.
            mmio_write(0,irq_enabled?3:1);
            mmio_read(16'h000c,value);
            if(value!==2)$fatal(1,"busy start did not fail");
            mmio_write(16'h1000,32'hff);
            mmio_read(16'h000c,value);
            if(value!==2)$fatal(1,"busy load did not fail");
            mmio_write(0,irq_enabled?10:8);
            timeout_count=0;value=0;
            while(!value[2])begin
                mmio_read(4,value);timeout_count=timeout_count+1;
                if(timeout_count>300000)$fatal(1,"MMIO job timeout");
            end
            if(value[1]||value[3])$fatal(1,"bad completion status %h",value);
            if(irq!==irq_enabled)$fatal(1,"IRQ mask mismatch");
            read_profile();
            if(profile[11]!==1)$fatal(1,"profile invalid/overflow/active %h",profile[11]);
            if(profile[0]!==mon_total || profile[7]!==mon_weights ||
               profile[8]!==mon_issues || profile[9]!==mon_retires ||
               profile[10]!==mon_peak)$fatal(1,"profile handshake mismatch total %0d/%0d weight %0d/%0d issue %0d/%0d retire %0d/%0d peak %0d/%0d",
               profile[0],mon_total,profile[7],mon_weights,profile[8],mon_issues,
               profile[9],mon_retires,profile[10],mon_peak);
            sum_layers=0;
            for(result_i=0;result_i<6;result_i=result_i+1)begin
                if(profile[result_i+1]!==mon_layer[result_i])
                    $fatal(1,"layer %0d cycles mismatch",result_i);
                sum_layers=sum_layers+profile[result_i+1];
            end
            if(sum_layers!=profile[0] || mon_issues!=mon_retires || mon_inflight!=0)
                $fatal(1,"cycle conservation or matrix drain mismatch");
            for(output_i=0;output_i<8;output_i=output_i+1)begin
                mmio_read(16'h0010+output_i*4,value);
                if(value!==(output_i<classes?golden[output_i]:32'd0))
                    $fatal(1,"job %0d logit %0d got %h expected %h",number,output_i,value,golden[output_i]);
                $fdisplay(logit_fd,"%0d,%0d,%0d,%0d",number,output_i,$signed(value),$signed(golden[output_i]));
            end
            $fdisplay(perf_fd,"%0d,%0d,%0d,%0d,%0d,%0d,%0d,%0d,%0d,%0d,%0d,%0d,%0d,%0d,%0d",
                number,profile[0],profile[1],profile[2],profile[3],profile[4],
                profile[5],profile[6],profile[7],profile[8],profile[9],profile[10],
                load_writes,accepted_writes,load_cycles);
            for(snapshot_i=0;snapshot_i<12;snapshot_i=snapshot_i+1)
                snapshot[snapshot_i]=profile[snapshot_i];
            // Enabling a previously masked completed IRQ must assert it.
            mmio_write(0,2);if(!irq)$fatal(1,"pending done IRQ did not unmask");
            mmio_write(0,6);if(irq)$fatal(1,"done clear did not clear IRQ");
            mmio_read(4,value);if(value[2])$fatal(1,"done latch retained");
            repeat(5)@(negedge clk);
            read_profile();
            for(snapshot_i=0;snapshot_i<12;snapshot_i=snapshot_i+1)
                if(profile[snapshot_i]!==snapshot[snapshot_i])
                    $fatal(1,"clear_done changed profile %0d",snapshot_i);
            mmio_write(16'h0040,32'hdeadbeef);expect_error(6);
            read_profile();
            for(snapshot_i=0;snapshot_i<12;snapshot_i=snapshot_i+1)
                if(profile[snapshot_i]!==snapshot[snapshot_i])$fatal(1,"readonly write changed profile");
        end
    endtask
    initial begin
        if(!$value$plusargs("DATA_DIR=%s",data_dir))$fatal(1,"missing DATA_DIR");
        if(!$value$plusargs("OUT_DIR=%s",out_dir))$fatal(1,"missing OUT_DIR");
        if($value$plusargs("CLASSES=%d",classes))begin end
        if(classes<1||classes>8)$fatal(1,"invalid CLASSES");
        if(!$value$plusargs("DATA_DIR2=%s",data_dir2))data_dir2=data_dir;
        perf_fd=$fopen({out_dir,"/mmio_perf.csv"},"w");
        logit_fd=$fopen({out_dir,"/mmio_logits.csv"},"w");
        if(!perf_fd||!logit_fd)$fatal(1,"cannot open result files");
        $fdisplay(perf_fd,"job,total_cycles,conv1_cycles,pool1_cycles,conv2_cycles,pool2_cycles,reserved_cycles,fc_cycles,weight_rows,matrix_issues,matrix_retires,peak_inflight,jobacceptedwrites,totalacceptedwrites,hostloadcycles");
        $fdisplay(logit_fd,"job,class,actual,golden");
        repeat(4)@(negedge clk);rst_ni=1;
        read_profile();for(reset_i=0;reset_i<12;reset_i=reset_i+1)
            if(profile[reset_i]!==0)$fatal(1,"reset profile nonzero");
        mmio_write(8,0);expect_error(1);
        mmio_write(8,9);expect_error(1);
        mmio_write(8,classes);
        mmio_write(16'h3040,32'hffffffe0);mmio_write(16'h3060,1);expect_error(5);
        read_images(data_dir);load_model(1);run_job(0,0);
        load_model(0);run_job(1,1);
        read_images(data_dir2);load_model(1);run_job(2,1);
        $fclose(perf_fd);$fclose(logit_fd);
        $display("PASS MMIO fileio opt=%0d tile=%0d classes=%0d writes=%0d",OPT_GATHER_LOAD,OPT_SPATIAL_TILE,classes,accepted_writes);
        $finish;
    end
endmodule
