ScoreForever/ChipDesign/output/npu-performance/20261107/bounds_remote_source/hardware/npu/rtl/requant_lane.sv

`timescale 1ns/1ps
// Each lane has II=1 and four stages. Saturating INT32 left shift, signed
// 32 x unsigned 8-bit (Q8) product, one round-half-up shift by 8+max(-shift,0),
// INT4/u4 clamp. Shift is -31..31.
module requant_lane #(
    parameter SHIFT_WIDTH = 6,
    parameter TAG_WIDTH = 1
) (
    input  wire                         clk,
    input  wire                         rst,
    input  wire                         in_valid,
    input  wire signed [31:0]           in_value,
    input  wire [7:0]                   in_multiplier,
    input  wire signed [SHIFT_WIDTH-1:0] in_shift,
    // Clamp bounds: -8..7 for INT4 outputs, 0..15 for unsigned u4 outputs.
    input  wire signed [4:0]            activation_min,
    input  wire signed [4:0]            activation_max,
    input  wire [TAG_WIDTH-1:0]         in_tag,
    output reg                          out_valid,
    output reg  [3:0]                   out_data,
    output reg  [TAG_WIDTH-1:0]         out_tag
);
    localparam signed [31:0] INT32_MIN_VALUE = 32'sh80000000;
    localparam signed [31:0] INT32_MAX_VALUE = 32'sh7fffffff;

    function automatic signed [31:0] saturating_left_shift;
        input signed [31:0] value;
        input integer amount;
        begin
            // Constant threshold shifts avoid a 64-bit barrel shifter.
            if (value > (INT32_MAX_VALUE >>> amount))
                saturating_left_shift = INT32_MAX_VALUE;
            else if (value < (INT32_MIN_VALUE >>> amount))
                saturating_left_shift = INT32_MIN_VALUE;
            else
                saturating_left_shift = value <<< amount;
        end
    endfunction

    // Stage 1: left shift, and the total right shift 8+max(-shift,0).
    // Stage 2: 32x8 product. Stage 3: one round-half-up shift of the full
    // 41-bit product (single rounding; ABI 3 rounded twice, which moved values
    // near an INT4 decision boundary by one step). Stage 4: clamp.
    reg s1_valid, s2_valid, s3_valid;
    reg signed [31:0] s1_value;
    reg [7:0] s1_multiplier;
    reg [5:0] s1_rshift, s2_rshift;

    reg signed [40:0] s2_product;
    reg signed [31:0] s3_scaled;
    reg signed [4:0] s1_min, s1_max, s2_min, s2_max, s3_min, s3_max;
    reg [TAG_WIDTH-1:0] s1_tag, s2_tag, s3_tag;

    // |product| < 2^39, so adding 2^(rshift-1) <= 2^38 cannot overflow 41 bits,
    // and the shifted result fits INT32.
    wire signed [40:0] s2_rounded = s2_product + (41'sd1 <<< (s2_rshift - 6'd1));
    wire signed [40:0] s2_shifted = s2_rounded >>> s2_rshift;

    always @(posedge clk) begin
        if (rst) begin
            s1_valid <= 1'b0; s2_valid <= 1'b0; s3_valid <= 1'b0; out_valid <= 1'b0;
            s1_value <= 32'sd0; s1_multiplier <= 8'd0; s1_rshift <= 6'd8;
            s2_rshift <= 6'd8;
            s2_product <= 41'sd0; s3_scaled <= 32'sd0;
            s1_min <= 5'sd0; s1_max <= 5'sd0; s2_min <= 5'sd0; s2_max <= 5'sd0;
            s3_min <= 5'sd0; s3_max <= 5'sd0;
            s1_tag <= '0; s2_tag <= '0; s3_tag <= '0; out_tag <= '0;
            out_data <= 4'd0;
        end else begin
            s1_valid <= in_valid;
            s1_value <= saturating_left_shift(in_value, (in_shift > 0) ? in_shift : 0);
            s1_multiplier <= in_multiplier;
            s1_rshift <= 6'd8 + ((in_shift < 0) ? -in_shift : 6'd0);
            s1_min <= activation_min; s1_max <= activation_max; s1_tag <= in_tag;

            s2_valid <= s1_valid;
            s2_product <= s1_value * $signed({1'b0, s1_multiplier});
            s2_rshift <= s1_rshift; s2_min <= s1_min; s2_max <= s1_max; s2_tag <= s1_tag;

            s3_valid <= s2_valid;
            s3_scaled <= s2_shifted[31:0];
            s3_min <= s2_min; s3_max <= s2_max; s3_tag <= s2_tag;

            out_valid <= s3_valid;
            out_tag <= s3_tag;
            if (s3_scaled < s3_min)
                out_data <= s3_min[3:0];
            else if (s3_scaled > s3_max)
                out_data <= s3_max[3:0];
            else
                out_data <= s3_scaled[3:0];
        end
    end
endmodule
