ScoreForever/ChipDesign/verification/fpga/reevaluate_int4_v2_zoo.py

"""Rebuild complete public test splits and reevaluate the frozen ABI 4 zoo."""
import argparse
from datetime import datetime, timezone
import hashlib
import importlib.metadata
import json
import math
from pathlib import Path
import sys
import time

ROOT=Path(__file__).resolve().parents[2]
sys.path[:0]=[str(ROOT/'software/host'),str(ROOT/'software'),str(ROOT/'software/zoo')]
import torch
import npu_fastref
from zoo import data as datasets
from zoo.hwopt import frames_for
from train import quantize_input
from npu_program import compile_model, encode_tensor


def sha(path):return hashlib.sha256(path.read_bytes()).hexdigest()


def main():
    p=argparse.ArgumentParser(description=__doc__)
    p.add_argument('--data',type=Path,required=True)
    p.add_argument('--output',type=Path,required=True)
    p.add_argument('--models',default='mnist_l,fashion_cnn,har,ecg,gtsrb_l,kws_l,kws_m')
    p.add_argument('--batch-size',type=int,default=256)
    args=p.parse_args();args.output.mkdir(parents=True,exist_ok=True)
    torch.set_num_threads(8)
    torch.backends.cuda.matmul.allow_tf32=False
    torch.backends.cudnn.allow_tf32=False
    device='cuda' if torch.cuda.is_available() else 'cpu'
    baseline={r['model']:r for r in json.loads((ROOT/'docs/validation/int4_v2/zoo_eval.json').read_text())}
    for name in args.models.split(','):
        out=args.output/name;out.mkdir(exist_ok=False)
        run=ROOT/'software/zoo/pretrained'/name
        model=json.loads((run/'model.json').read_text());golden=json.loads((run/'golden.json').read_text())
        report=dict(model=name,passed=False,started_utc=datetime.now(timezone.utc).isoformat(),
            model_sha256=sha(run/'model.json'),golden_sha256=sha(run/'golden.json'),
            device=device,batch_size=args.batch_size,
            versions={n:importlib.metadata.version(n) for n in ('torch','torchvision','torchaudio','numpy','pillow','wfdb','soundfile')},
            loader_sha256=sha(ROOT/'software/zoo/data.py'),fastref_sha256=sha(ROOT/'software/host/npu_fastref.py'))
        try:
            print('REBUILD',name,flush=True);started=time.monotonic()
            raw=datasets.LOADERS[name](args.data)
            x,y=raw['test'];y=y.cpu().long()
            assert len(y)==baseline[name]['test_samples'],(name,len(y),baseline[name]['test_samples'])
            frames=frames_for(model,quantize_input(x.cpu(),model['metadata']['input_scale'])).to(torch.int8).contiguous()
            report['test_samples']=len(y)
            for row in golden['frames']:
                values=frames[row['index']].flatten().tolist()
                assert values==row['input'],(name,row['index'],'rebuilt input mismatch')
                assert int(y[row['index']])==row['label'],(name,row['index'],'label mismatch')
                assert encode_tensor(values,golden['input_dtype']).hex()==row['input_hex']
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
