ScoreForever/ChipDesign/(commit log)

2026-09-26 feat(matrix-unit): 完成了 weight-stationary 矩阵计算单元构建，配有对应模块的testbench和中英文README，矩阵乘法阵列输入INT8输出INT32，结果尚未经过Requantinization
2026-09-27 feat(vector-unit): 实现8-lane INT8 SIMD Vector Unit，完成仿真测试并更新文档
2026-10-06 Integrate Lab3 SoC: cv32e40p CPU, AXI xbar, bootram, SRAM, debug and ChipDesign NPU
    - Migrate Lab3 cv32e40p/SoC RTL into hardware/cpu/ and hardware/soc/
    - Add npu_mmio_wrapper bridging AXI/MMIO to matrix_unit and vector_unit
    - Replace simple_npu with ChipDesign NPU in my_soc_top
    - Add chipdesign_soc_tb, filelist, run_soc.ps1 and assembly hex test
    - Verify PASS: integrated SoC (355 cycles) and existing NPU unit tests
    [cdc_2phase.sv, chipdesign_soc_tb.sv, my_mainmem.sv, my_npu_subsystem.sv, my_soc_pkg.sv, my_soc_top.sv, sram_ff.sv]
2026-10-07 阶段1：实现 NPU → CPU 完成中断
    - npu_mmio_wrapper: 新增 irq_o，由 matrix/vector 输出 valid latch 驱动
    - my_npu_subsystem: 透传 irq_o
    - my_soc_top: 将 npu_irq 接到 cv32e40p irq_i[16]（cv32e40p IRQ_MASK 仅开放 16..31 自定义线）
    - 新增 gen_irq_hex.py 与 chipdesign_npu_irq_test.hex：WFI + 中断服务程序读结果并写 PASS
    - 新增 chipdesign_npu_irq_tb.sv，filelist 加入该 testbench
    - ModelSim 验证：chipdesign_npu_irq_tb PASS（397 个周期），原 polling 测试仍 PASS
    - 更新 docs/ARCHITECTURE.md 中断相关描述
2026-10-07 阶段2：实现 Requantization Unit（INT32→INT8）
    - 新增 hardware/npu/rtl/requant_unit.sv：8 通道并行量化，公式
    out = clamp((acc * scale) >>> shift + zero_point, -128, 127)
    - npu_mmio_wrapper.sv：
    * 实例化 requant_unit，Matrix 输出被接受时同步量化
    * 新增 0x0300..0x034F 寄存器区：CTRL/STATUS/SCALE[0..7]/SHIFT/ZERO_POINT/OUT_LO/HI
    * CTRL 支持 enable 与自动拷贝到 vec_src_a / vec_src_b
    * 保留 MATRIX_OUT 原始 INT32 读取能力
    - 新增 gen_requant_hex.py、chipdesign_requant_test.hex、chipdesign_requant_tb.sv
    - filelist 加入 requant_unit.sv 与新 testbench
    - ModelSim 验证：chipdesign_requant_tb PASS（565 个周期），原 poll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
2026-10-07 阶段3：实现简单 AXI DMA
    - 新增 hardware/soc/rtl/dma/npu_dma.sv：单 outstanding、word-by-word AXI copy engine
    * 配置寄存器 SRC/DST/LEN/CTRL/STATUS
    * 读源地址 → 锁存数据 → 写目的地址 → 计数递减 → 重复
    * 支持完成中断使能
    - my_soc_top.sv：
    * AXI crossbar slave port 从 3 扩到 4，新增 slave[3] 连接 DMA
    * DMA 通过 axi_adapter 接入总线，ID=4'h3
    * DMA 完成中断接到 irq_i[17]，NPU 中断保持 irq_i[16]
    - my_npu_subsystem.sv / npu_mmio_wrapper.sv：
    * wrapper 解码 0x0400..0x041F DMA 寄存器区并透传给 npu_dma
    * 保留 Matrix/Vector/Requant 原有功能
    - 新增 gen_dma_hex.py、chipdesign_dma_test.hex、c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
2026-10-07 docs(npu): record measured trade-offs and pre-synthesis acceptance
    [performance_summary.csv]
2026-10-08 fix(dma): make the NPU DMA test pass on the TinyCNN-8 register map
    chipdesign_dma_tb timed out after 1,000,000 cycles. Two independent defects in
    the test program caused it; the DMA RTL was never at fault.
    1. Stale register semantics. The program wrote 0x0000 and then polled 0x0004
    for the old Matrix-Unit "weights_loaded" bit. The current wrapper defines
    0x0000 as bit0=start / bit1=IRQ enable / bit2=clear done / bit3=clear error,
    so the poll condition could never become true.
    2. DMA destination overlapped the engine's own configuration registers. An
    intermediate attempt pointed the copy at 0x70000400..0x7000041C, which
    contains DMA SRC/DST/LEN/CTRL. The payload overwrote LEN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
2026-10-08 chore(soc): remove the unused third-party bootrom
    Deletes hardware/soc/rtl/mem/bootrom.sv (50 lines, ETH Zurich / University of
    Bologna, SolderPad). It was unreachable: not in chipdesign_soc.f, not
    instantiated anywhere, and never modified since it arrived with the Lab3
    integration in ea29e6f.
    The reset path has always used bootram.sv instead, whose first line already
    said "作为 bootrom 的替代". bootram is the functional replacement: same 16-word
    geometry, but writable and initialised from a hardcoded reset sequence rather
    than a const ROM. The file was byte-identical to the copy under Lab3, so
    nothing unique is lost.
    Its three non-zero filler words were also unreachable, being placed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
2026-10-13 fix(npu): restore the TinyCNN-8-Flat layered top over the GAP regression
    109513f rebuilt tinycnn8_npu_top.sv from a pre-1395821 copy, so main ran the
    removed GAP datapath (weight bases 0/32/192, FC IC=8) while the golden model,
    testbenches and MMIO wrapper use the Flatten ABI (bases 0/9/81, FC IC=160,
    parameter layer 2 rejected). tb_tinycnn8_npu_top failed with x logits, and
    the serialized requant_unit no longer met tb_requant_unit's one-cycle
    contract.
    Restore both files to their 1395821 content. The layered top stays as the
    bit-exact reference; the FPGA area techniques from 109513f (byte-banked
    activation storage, a single shared serial quantizer) are carried into the
    fused core in the ne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
2026-10-13 feat(npu): add the fused TinyCNN-8 core and make it the SoC default
    tinycnn8_npu_fused is a drop-in replacement for tinycnn8_npu_top (same host
    ports, parameter ABI and profiler ports) built around this model:
    - K-major tiling on every layer: a 4-row weight group serves a tile of 16
    positions (four 2x2 pool windows). Weight rows per inference drop from
    9,760 to 760; Conv1 no longer reloads its weights per position.
    - fused_ws_array: each PE holds two weight banks and the bank select
    travels with the operand, so the next group loads while the current one
    computes. Partial sums enter as zero and K groups are accumulated on the
    output side, so issues never wait on results.
    - 1 KiB by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
2026-10-13 docs(npu): document the fused core, its measurements and ABI changes
    Adds hardware/npu/TINYCNN8_FUSED.md (structure, schedule, pool-before-
    requant argument, storage layout, measured cycles, RTL-declared storage,
    verification commands, next steps) and updates ARCHITECTURE.md and the SoC
    README for the fused production core, VERSION 0x0002_0002, folded P1/P2
    profiler lanes and the negative-multiplier rejection.
2026-10-14 fix(fpga): reduce NPU area and resolve BRAM DRC risks
    Size activation banks by tensor lifetime and simplify Q31 rounding. Pipeline SRAM requests and outputs, match AXI read latency, and add EGo1 configuration voltage constraints.
    Add ModelSim regression coverage and a Vivado DRC gate verified against passing and failing checkpoints. Record synthesis results, cycle costs, and remaining DSP pipeline advisories.
2026-10-14 docs: align design details with current GAP implementation
2026-10-14 test(npu): validate fused real speech and independent cycle events
2026-10-14 feat(sw): add bare-metal NPU driver, KWS runtime and an end-to-end SoC workload
2026-10-15 feat(fpga): add Fmax sweep and activity-based power analysis for the KWS workload
2026-10-15 revert(soc): drop the dedicated instruction-fetch read port
    The second read port on the main SRAM cannot be mapped to the single-port
    RA1SHD_2048x32M8 macro used by the tape-out flow, and it modified the
    course-provided sram_ff/my_mainmem. Restore both files and the original
    instruction path through the AXI crossbar.
    This reverts commit 7170443.
2026-10-15 feat(soc): load the model and inputs through the DMA with a packed input window
2026-10-15 perf(sw): overlap the next input DMA with result read-back
2026-10-17 实现无 CPU 的 JTAG 推理控制系统，精简 SoC 架构
    - 以硬件控制器和专用 JTAG 接口替代 CPU、AXI 互连及调试体系，保留原 CPU 系统供对照
    - 实现模型与输入完整性提交、模型更新复用、任务调度、背压保护、结果快照和超时恢复
    - 支持空闲时只读查询 NPU 实际权重、激活及模型参数，预留模块编程扩展接口
    - 增加 OpenOCD 主机客户端、非零黄金模型与 JTAG 引脚回归，并接入 CI
    - 更新 FPGA/ASIC 构建入口、英文路径隔离综合脚本及中文架构和延迟分析文档
    验证：无 CPU 五组回归及原融合核 21 组 golden 用例通过。
    Vivado 2025.2 仅综合：7059 LUT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
2026-10-20 优化无 CPU NPU 面积：接入权重 SRAM 并精简累加存储
    - 使用单端口 32-bit SRAM 访问适配 64-bit 权重行，增加预取、背压和同步查询握手；主机 ABI 保持不变。
    - PE 局部和收窄至 18 bit，部分和存储收窄至 23 bit；在 INT32 池化前加回 bias，保留溢出和量化语义。
    - 实现 tile16/8/4 参数化对照，默认保留 tile16 与 4×8 阵列；补齐存储等待超时、回归、CI 和 EDA 交接说明。
    - 六种配置及课程真实 SRAM 模型验证通过，覆盖 1–8 类、极值、模型更新、重复推理和 JTAG；默认核心由 2805 增至 3028 周期（+7.95%）。
    限制：一颗 8 KiB 宏目前承载 2 KiB 权重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
2026-10-20 test(fpga): add board regression workflow and close DMI CDC issues
    Add Lab 6 host setup, H16 TCK wiring, reproducible CPU/NPU board tests and evidence gates. Synchronize JTAG reset release and constrain DMI mailbox crossings. Publish validated results and remaining test gaps; external IO timing remains blocked.
2026-10-20 fix(fpga): constrain external FT232H JTAG timing
    Define min/max IO timing for the short direct-wire interface, equivalent reference edges and scoped reset/LED exceptions. Audit effective setup/hold paths, integrate CDC/evidence regressions, and validate 10-1000 kHz communication. Preserve explicit propagation and TMS assumptions in published results.
2026-10-24 重构 NPU 为五算子可编程推理模块并统一主机控制
    - 引入 ABI 2 模型描述符与预验证调度，支持可配置 Conv、FC、MaxPool、ReLU 和 Requant
    - Conv/FC 共享 MAC 阵列，融合合法后处理链，统一模型及激活存储并移除旧固定核与冗余接口
    - 更新事务控制器、JTAG 主机驱动、模型编译器、训练模型导入、示例、CI 与综合入口
    - 补充架构审查、阵列取舍、连续卷积行缓存探索和实现验证记录
    验证：58 项完整场景、27 项课程 SRAM 宏场景、20000 个 Q31 向量通过；
    逐次核对 47204 次张量写回。FPGA 现有 50 MHz 约束下布局布线通过，
    WNS +0.073 ns、WHS +0.031 ns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
2026-10-24 build: add ASIC EDA implementation flow
2026-10-24 perf(npu): narrow fused TinyCNN accumulators
2026-10-25 feat(asic): add isolated full-chip PNR experiment framework
2026-10-25 fix(asic): preserve provenance and recover interrupted EDA tools
2026-10-25 将 NPU 激活存储迁移到双 SRAM 并完善背压与验证
    - 用独立 8 KiB 激活 SRAM 替换原 4 KiB 寄存器阵列，与 8 KiB 模型 SRAM 并行访问
    - 增加 64 B 读缓存、8 项写合并队列及核心 8 项输出 FIFO，预留 Requant 在途结果并支持写背压
    - 输入提交、通道 tile/层切换及推理完成均等待物理写回排空，保留五算子、合法组合、融合与数值精度
    - ASIC 默认关闭可选波形缓冲，保留性能计数和逐算子摘要；同步更新主机能力检测、编译器与文档
    - 更新 Genus/DC 双宏选择和 FPGA 构建，补齐 NPU JTAG 端点 CDC 及外部 I/O 约束审计
    验证：行为存储和双真实 SRAM 宏模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
2026-10-26 test(npu): add course workload benchmark and reusable case simulator
    Extract simulate() from the program regression so other scripts can run a
    compiled model through the host API with every tensor write checked.
    run_course_benchmarks.py reports cycles for the course candidate networks
    (KWS primary; MNIST and HAR as generality guards). ECG needs MaxPool1D and
    is reported as unsupported.
2026-10-26 feat(asic): place and power two SRAM macros under a 2x2 mm die cap
    The PnR framework assumed one SRAM. It now expects the model and
    activation stores as two RA1SHD macros: three named floorplan layouts,
    per-macro placement, halos, block rings and distributed power, and
    synthesis with both macro defines and the waveform RAM excluded.
    Candidates are eligible only within a 2 mm x 2 mm die; oversized points
    are recorded without starting Innovus. The utilization sweep now covers
    55-75%. The SDC check accepts Genus' 1000ps (exactly 1 ns) and quoted
    clock names, which previously blocked the synthesis handoff.
2026-10-26 perf(npu): give activation read misses the SRAM port before queued writes
    The single-port activation SRAM always served the write queue first, so
    read misses stalled the MAC array while buffered writes could have waited.
    A pending miss now goes first unless the queue is nearly full or a flush
    is draining it; reads still see queued data through forwarding, and no
    write is accepted in the cycle a miss issues, so cache fills stay current.
    TinyCNN (trained KWS): 3826 -> 3448 cycles, below the old 4 KiB register
    version (3442). MNIST -10.6%, MLP unchanged. 70/70 scenarios pass with
    behavioral SRAM and with both real course macros. The pressure test's
    random mix now completes about 8000 reads and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
2026-10-26 feat(npu)!: ABI 2.1 packs narrow output tiles at four bytes per weight row
    On an 8-column array, an output-channel tile with at most four real
    channels (always the last tile) now stores one 32-bit word per weight row
    instead of two, and the loader fetches one word; the upper lanes load as
    zero. Earlier tiles keep 8 bytes per row, so tile offsets are unchanged.
    Register 0 reports 0x00020001; the host and compiler share one ABI
    constant and reject mismatched hardware or packages.
    BREAKING: ABI 2.0 model packages must be recompiled.
    TinyCNN (trained KWS) 3346 -> 3262 cycles, MNIST 5901 -> 5777. 70/70
    scenarios pass with behavioral and real SRAM models; 6/6 trace
    configurations pass.
    Co-Autho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
2026-10-26 feat(asic): independent Calibre, PrimeTime and Formality signoff script
    signoff.py runs Calibre DRC/LVS with the PDK decks (only input and output
    statements replaced), PrimeTime setup/hold on the routed netlist and SPEF,
    and Formality between the synthesized and routed netlists, each through
    flow.launch. Report parsers fail closed. Not yet exercised on a real
    layout; tuning follows the first dual-SRAM candidate.
2026-10-26 fix(asic): drop global VDDPST/VSSPST connections that match no pin
    The IO library has no LEF power pins named VDDPST/VSSPST; supply PADs
    are bound with attachTerm. The global connections raised IMPDB-1221,
    which the flow correctly treats as fatal.
2026-10-26 feat(npu): make per-operator trace summaries optional, off for ASIC
    The per-operator summaries are 16 operators x 8 32-bit counters held in
    flip-flops, about 0.2 mm^2 of the 1.58 mm^2 standard-cell area. Like the
    waveform RAM, they are now selected by NPU_ENABLE_OP_TRACE (Genus/DC
    EDA_NPU_OP_TRACE): off by default in ASIC synthesis, on for simulation and
    FPGA. When off, register 0x1a8 reads 0, the summary window returns an
    address error, and the host reports that summaries are unavailable. The
    24 global performance counters, all computation and cycle counts are
    unchanged.
    8/8 trace configurations and 70/70 program scenarios pass.
2026-10-26 fix(asic): export the simulation netlist as the course flow does; keep die snap headroom
    saveNetlist -phys cannot be combined with -removePowerGround (IMPSYC-1299),
    which failed every candidate at export after a clean route. Use the course
    hierarchical-netlist command instead.
    floorPlan snapped a requested 2000um die to 2000.32um, over the 2x2 mm cap.
    Candidates now need 6um headroom (one row) before Innovus starts.
2026-10-26 fix(asic): let hold fixing exceed 75% density; tolerate missing GUI pictures
    At 70% utilization the course default -maxDensity 0.75 stopped hold
    buffer insertion and left -1.39 ns hold. dumpPictures needs the GUI and
    aborted -no_gui runs after the layout was already complete.
2026-10-26 fix(signoff): make Calibre, PrimeTime and Formality checks run on real layouts
    Debugged on an abandoned layout:
    - PrimeTime: no Library Compiler on the node, so SRAMs link as black boxes
    (their interface timing stays with Innovus); strip Innovus' current_design
    from the SDC; accept only the PT-063 startup notice, recorded per run.
    - Calibre: rescale deck PRECISION/RESOLUTION to the 2000 dbu GDS; label the
    IO ring POC rail; reduce split gates (IO pad NOR2 is fingered in layout).
    - LVS passes on correct topology, or when the only discrepancies are IO pad
    resistor values within 5% (IO SPICE 270a vs GDS 280a differ by 3.47%).
    - DRC classifies each rule by location: deck reminder, and gui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
2026-10-26 fix(asic): trim dangling PG stubs and accept only IO rail infos in PG check
    The final special-net check always failed: the abutted VDDPST/VSSPST IO
    rails report 'no routing' (already exempt in the regular check), and per-SRAM
    M5 stripes left dangling stubs past the matching block ring. editTrim clears
    the stubs; a trial on a finished layout left only the two IO rail infos,
    with special and regular DRC still clean.
2026-10-26 fix(asic): make the SDF gate simulation pass on the dual-SRAM layout
    - Disable timing checks only on the six CDC capture flops (req/ack toggle
    synchronizer first stages, both reset synchronizer stages). They sample
    asynchronous inputs by design; a check there turned Q into X and broke
    JTAG. The list is matched exactly in the netlist and recorded per run.
    - Keep antenna diodes in the simulation netlist; they have a Verilog model
    and are referenced by the SDF (SDFINF otherwise).
    - Expect ABI 2.1 (0x20001) after the physical reset check.
    Trial on a debug layout: 0 timing violations, all JTAG commands pass.
2026-10-29 Add no-CPU FPGA board validation workflow
2026-10-31 优化 NPU gather 控制路径并收敛 FPGA 建立时间
    提前准备下一组 gather 元数据，将连续性判断移到 kernel 准备阶段，
    仅增加六位组内标志，保持 ABI、五算子、融合、量化和握手周期。
    对齐完整构建与 checkpoint 实现的物理优化流程，补充多路径、CDC、
    高扇出报告及一像素非对称 stride=2 的边界回归。
    验证：行为 SRAM 与真实双宏模型各 74 项、每组 135284 次写回通过；
    既有场景的周期及性能/算子 trace 不变，CDC 复位及 20000 个量化向量通过。
    Vivado 2025.2 完整 50 MHz 构建 PASS：WNS +0.064 ns、TNS 0、
    WHS +0.035 ns、setup/hold 违例端点 0、DRC errors 0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
2026-10-31 重构无 CPU SoC 为原生 INT4 推理系统并升级模型 ABI
    - 将激活、权重、MAC 和局部累积缩为 INT4/10bit/18bit，保留 INT32 bias 与原始张量
    - 使用 Q15 系数及 32×16 量化流水，通道参数压为 8 字节
    - 实现 nibble 打包、掩码合并/转发及 byte SRAM 的部分写读改写，保留双 SRAM 宏
    - 同步描述符验证、主机编译/推理、trace、FPGA/ASIC 构建入口及协议文档，拒绝旧包和错误阵列布局
    - 保留五算子、融合、模型调度、背压与复位；INT8 NPZ 明确经过有损 PTQ 导入，不沿用精度结论
    验证：行为与课程宏模型各 82 项完整程序测试、各 233732 次写回核对；
    MAC 全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
2026-10-31 补充 INT4 后续面积优化分析与阵列性能取舍
    - 核算 INT8→INT4 和 8列→4列的选定存储位变化，区分 RTL 位数与映射面积
    - 记录 MNIST、KWS、HAR 的 4×8/4×4 实测周期，保留 4×8 默认配置
    - 分析描述符缓存、数据复位、运行期索引、tile/结果槽及队列缩减的收益边界
    - 说明双 SRAM 固定面积、纵向宏摆放下限、横向布局假设与容量/吞吐代价
    - 保留当前生产 RTL，不将尚未验证的候选优化混入功能重构
    本次仅补充分析和来源数据；按用户要求不执行 EDA，不承诺实际面积或时序。
2026-11-02 Close INT4 FPGA timing and add board evidence
2026-11-02 Verify stopped TCK and physical reset on the 50 MHz INT4 board
2026-11-02 Record busy-button reset coverage and post-power-cycle FPGA recovery
2026-11-03 feat(asic): orient each SRAM so its signal-pin edge faces the logic
    RA1SHD_2048x32M8 carries all 109 signal pins on its R0 bottom edge. With
    both macros at R0 in west_stack, the lower one faces the core boundary and
    the upper one faces the inter-macro channel. Add west_stack_r90 (pins east)
    and south_row_mx (pins north), carry the orientation through floorplan and
    power scripts, and audit the placed D/Q pin side as a physical gate.
2026-11-03 feat(npu)!: ABI 4.0 operators, per-kind fusion switches and single-rounding Requant
    Hardware (npu_program_core, requant_lane, command controller):
    - depthwise convolution on the shared MAC array: one stored weight row per
    K group is expanded to a block diagonal, gather walks the tile's channels
    - rectangular kernels up to 7x7, so 1-D convolutions run natively
    - fused 1x2 max pool beside 2x2; standalone Max/Avg pooling with any
    window and stride (AvgPool emits the INT32 window sum)
    - residual Add of two INT4 tensors with signed 8-bit weights
    - Requant/ReLU fusion after pooling and Add
    - Requant rounds once: round-half-up of the 48-bit product. ABI 3 rounded
    twice and moved ~8% of first-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
2026-11-03 feat(npu): unsigned u4 activation mode for post-ReLU tensors
    ReLU outputs in signed INT4 keep only 0..7 (three effective bits). Tensors
    may now hold unsigned 0..15: descriptor flags src/src2/dst-u4 (bits 15-17),
    5-bit clamp fields, MAC operands extended to 5 bits (|u4*i4|<=120, four
    rows <=480 fit the existing 10-bit local sum; K=1024 fits 18-bit psum),
    zero-extension in pooling/Add, Requant clamps up to 15.
    QAT fake-quant experiments: MNIST 95.2->96.6, Fashion 85.0->86.8 (val
    87.8), ECG val 96.4->96.9 versus signed post-ReLU activations.
    Regression: 118 program tests incl. a u4 chain; exhaustive u4 MAC pairs;
    u4 Requant vectors. Also: distillation option and larger zoo specs.
    Co-Authored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
2026-11-03 feat(npu,asic): in-place residual Add; fix macro pin audit; zoo specs sized to 8 KiB
    Add may write exactly over either operand (it reads each element before
    writing it, as in-place ReLU), so a residual block needs one tensor less.
    The allocator uses it when the operand dies at the Add.
    The placed-pin audit read brace-quoted bus names from dbGet and matched
    nothing; validated on a routed R0 layout (both macros report S).
2026-11-03 perf(npu): share one setup multiplier; incremental slot addresses; fetch-time checks
    Genus breakdown of the ABI 4 core showed 0.44 mm2 of combinational logic
    outside the MAC array and Requant. About twenty one-time setup products
    (spans, strides, scan steps, pool-window checks) each had a dedicated
    multiplier; they now share one 16x16 multiplier over DERIVE steps 0-7
    and SETUP steps 0-9 (~10 extra cycles per descriptor/tile).
    - result slots store their output address (a running sum) instead of a
    position multiplied by the channel count on every write
    - reserved descriptor fields are checked while fetching, so the unused
    bits are never stored; ih/iw are 8-bit
    - the element engine writes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
2026-11-03 feat(jtag): burst write/read IRs, one 32-bit scan per word
    Every host word used to cost a poll, a 72-bit command scan and at least
    one 72-bit response scan, each an OpenOCD round trip. IR 13h writes and
    IR 14h reads the word after the last IR 12h command's address (+4 per
    scan); a read returns the previous read's data, the last one through IR
    12h. A burst scan that meets a busy mailbox, or a burst reply with an
    error, sets the sticky overrun bit seen by the next IR 12h capture.
    Reads idle four TCKs in Run-Test/Idle before the next capture.
    Host: write_block/read_block use bursts for model, input and output and
    batch up to 64 scans per Tcl RPC. Testbench: +TCK_NS period, IR switching,
    burst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
2026-11-03 perf(npu): vector element engine, row-padded 1-channel kernels, one DW row per tap
    Zoo per-operator traces showed element operators (Add, AvgPool/GAP) at
    10-34% of model cycles: one nibble read every two cycles per lane. For
    i4/u4 tensors one 8-nibble read now updates all COLS lanes of a pixel
    (21-bit lane arithmetic, accumulating in the result slot); INT32 sources
    keep the scalar path. ECG -30%, KWS-L -19%, MNIST-L -19% cycles.
    - IC=1 kernels up to four taps wide (e.g. 7x3 KWS front end) pad each
    kernel row to one K group: every group is one contiguous read
    - depthwise weights are stored once per tap (the 4x8 build stored each
    row twice): GTSRB-L 8228 -> 7688 bytes
    - zoo: exact RGB ->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
2026-11-03 perf(npu): two Requant lanes for nibble outputs; end-to-end JTAG timing
    Slot waits (MAC waiting for postprocessing at one element per cycle) were
    up to 24% of model cycles. Nibble outputs now drain two lanes per fire
    through two Requant lanes and leave as one masked write of two adjacent
    nibbles; INT32 outputs keep one lane. With the vector element engine and
    row padding, 4x8 cycles drop 19-43% across the zoo (ECG 37.3k -> 21.3k,
    KWS-L 177.6k -> 126.4k, GTSRB-L 165.0k -> 122.8k).
    e2e_timing.py runs the host flow phase by phase on the physical JTAG pins
    (+TCK_NS, burst vs legacy protocol); the testbench prints phase markers.
    130 program tests pass; 22 zoo RTL runs bit-exact.
    Co-Authored-By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
2026-11-03 test(npu): reject malformed ABI 4 descriptors
    Seven mutations on fixtures that use the new fields: depthwise channel
    count not a COLS multiple, pool window taller than the input, Add src2
    overlapping its destination, MaxPool fusion on Add, u4 on an INT32
    source, the depthwise flag on FC, and the 1x2 pool flag without a fused
    pool. All 16 negative cases fail with the expected error code.
2026-11-03 test(fpga): board suite and evidence check cover ABI 4 fixtures
2026-11-03 build(fpga): debug traces off by default; zoo evaluation script
    yosys XC7 estimates (calibrated: 17,587 vs Vivado 17,255 LUT on the last
    board-validated build): latest RTL 18,937 LUT with traces, 18,665 with
    operator summaries only, 15,691 without either. The EGo1 build now omits
    both traces unless CHIPDESIGN_TRACE=1, leaving ~26% LUT headroom. The full
    regression passes in the CHIPDESIGN_FPGA_MEM configuration.
2026-11-03 feat(npu): TILE=8 build option (NPU_TILE)
    psum is the largest register file (16 positions x 8 lanes x 18 bits,
    0.121 mm2). TILE=8 halves it; a spare tag bit carries the tile parity so
    a 2x2 fused pool still rotates through all four result slots. Zoo cycles
    at TILE=8: geomean +4% (KWS-M +15%, KWS-L -2%). TILE=16 stays default:
    the two-SRAM die is not area-bound. Both pass the 130-test regression.
2026-11-03 test(asic): gate-level JTAG test uses bursts and the ABI 4 operator chain
    tb_fullchip drives the burst IRs (one 32-bit scan per word, reads
    compared one scan later, four idle TCKs between reads) and make_trace uses
    the u4_chain fixture: fused Conv+Requant+ReLU+MaxPool, depthwise, in-place
    Add, AvgPool, general MaxPool and u4 tensors. RTL simulation of the same
    bench passes: 41 commands and 340 burst scans.
2026-11-03 docs: ABI 4.0 host/model contract; report generator and collected results
    CPU_LESS_CONTROL.md describes the burst IRs, opcodes 6/7, word0 flags
    13-17, 5-bit clamps, the one-word parameter (18-bit bias, Q8 multiplier)
    and single-rounding Requant. docs/tools/int4_v2_report.py builds the v2
    report from docs/validation/int4_v2/ (zoo RTL runs per optimization
    stage, area breakdowns, yosys XC7 estimates, v1 course baseline).
2026-11-04 test(asic): update CDC tests for macro_pins gate and Innovus property names
    Acceptance now also requires the macro_pins check (2a855c0), and the
    Innovus CDC audit reads the 'arrival'/'required' path properties instead of
    arrival_time/required_time, which are empty on Innovus 21. The fixtures
    still model the old names, so pnr-framework failed on PR 12.
2026-11-04 zoo: publish the seven INT4 models and the full validation flow
    software/zoo/pretrained/<model>: exported INT4 model, QAT checkpoint,
    compiled 4x8/4x4 NPU images, 16 golden frames (input codes, integer
    reference output, raw host I/O bytes), training metrics and exact train.py
    arguments; MANIFEST.json holds SHA-256 of every file.
    New scripts: package_models.py (package runs), check_golden.py (compiler
    and reference reproduce the images and outputs, no dataset needed),
    make_test_frames.py (rebuild full test sets, checked against golden),
    fetch_datasets.sh (public sources, GTSRB parquet SHA-256 checked).
    rtl_check.py and e2e_timing.py read golden.json when no test set is present.
    docs/VALIDATI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
2026-11-04 docs,asic: clearer slide diagrams, final-design deck with PPTX, spread SRAM layouts, array-size study
    - Slides: SoC, NPU, verification-chain and JTAG diagrams redrawn at final
    size with one flow direction, three line meanings and a legend (guidance
    from K-Dense-AI scientific-schematics); main part shows the final design,
    process material moves to an appendix; authors listed; make_pptx.py
    exports a 16:9 PPTX.
    - flow.py: west_split_r90, west_east, south_north and diagonal_facing
    layouts keep every SRAM pin edge toward the logic without crowding one
    corner.
    - docs/tools/array_size_model.py: cycle estimates for 4x4/4x16/8x8 arrays
    from the measured 4x4 and 4x8 traces; 8x8 recorded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
2026-11-04 fpga: INT4 v2 on EGo1 at 50 MHz, board validation of all seven models
    Taken from codex/fpga-int4-v2-validation-20261104 (1339140) with the code
    and the key evidence only:
    - npu_program_core: register the has-next-position predicate so the
    terminal-count compare leaves the gather mask/address path (50 MHz closes,
    cycles unchanged).
    - npu_jtag_transport: classify burst errors from the receiving-domain reply
    register instead of feeding the asynchronous mailbox error into the sticky
    flag (removes the CDC-1 critical).
    - Build gate that rejects critical CDC, burst CDC testbench, board and RTL
    runners for the published zoo models.
    - Report, validation matrix, final implementation timing/C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
2026-11-04 docs,asic: final diagonal SRAM layout signed off on the fixed RTL; report, slides and PPTX show the final design
    - SRAM placement study (seven layouts): stacking both macros in the
    south-west corner gives the highest congestion and the smallest hold
    margin; north/south and west/east put the two pin edges face to face
    across an 80 um channel. Final: diagonal_facing, the macros in opposite
    corners with each pin edge toward open logic; die 1920 um (budget 1950).
    - Final run on the RTL with the FPGA board fixes, Innovus hold target
    0.25 ns: PrimeTime setup +1.094 ns / hold +0.154 ns; Calibre DRC/LVS,
    Formality and Xcelium SDF gate-level pass.
    - Report: main sections give the final de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
2026-11-04 docs(slides): SoC overview with equal-height clock domains and the CDC mailbox on the boundary
    Even spacing so every arrow label has room, region names placed
    consistently at the top-left, and a flow strip without stretched text.
2026-11-04 docs: drop appendices from the report and slides; process data in INT4_V2_PROCESS.md
    The report and the deck now show only the final design. Optimization stages,
    area evolution, the pre-board FPGA estimate and the layout trials move to
    docs/INT4_V2_PROCESS.md, generated by the same script.
2026-11-06 优化 SoC：扩展至 128 描述符、8×8 PE 并共享双 SRAM
    将控制计数、PC、错误定位和 trace 扩展至 128 条描述符；模型 SRAM 的 8 KiB 总容量限制仍保留。
    将 MAC 阵列扩展为 64 PE，适配八行权重、激活 gather、depthwise 调度和 11 位组内累加，跳过填充行的模型读取。
    将模型移至第二颗 SRAM 高端，按张量生命周期共享两颗 SRAM 的剩余连续空间，补齐轮转仲裁、转发、RMW、排空及模型保护。
    升级 ABI 5，更新编译器、主机工具、七个 c8 模型包和 CI；保留 c4 的 ABI 4 历史包。
    验证：完整程序 85/85、439154 次逻辑写回事务；双 SRAM 接口模型 10/10；tra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
2026-11-09 Align current-facing docs with ABI 5.0
    - Fix ABI register label (4.0 -> 5.0) and stale "ABI upgraded to 4.0" text
    - Correct --act-bytes description: compiler only accepts 8192 (two 8 KiB
    SRAMs, 16384-model_bytes usable for activations); no smaller config
    - Describe production shared store instead of separate 8 KiB model/act RAMs
    - Mark BASELINE_MAIN_20261106 as the ABI 4 freeze and explain that the
    130/130, 85/85 and 81+19 regression counts belong to different snapshots
    - Link the 2026-11-09 ABI 5 FPGA implementation/board evidence; ABI 5 ASIC
    remains UNKNOWN
2026-11-09 Add deep limit, fuzz, deployability and change-evaluation tooling
    - profile_limits.py: gather IC, kernel/stride, depthwise width, standalone
    elementwise throughput, fused vs unfused pooling and 32x32 spatial limits
    with analytic per-resource bounds
    - profile_fuzz.py: seeded random models across the ABI 5.0 envelope
    (rect kernels, stride, asymmetric padding, depthwise, 1D, pooling, Add,
    u4/i32 inputs, FC, fusion on/off); every tensor write checked
    - deploy_envelope.py: compile-only fit of common TinyML families
    (DS-CNN, MobileNetV1, ResNet-8, FC autoencoder, LeNet-5, TCN)
    - eval_change.py: run all suites for one checkout and export
    dashboard tables (runs/models/layers/limits/fuzz/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
2026-11-09 Add dual-macro side read port for model reads (candidate A)
    Model reads are served through a dedicated side port on the activation
    store so they no longer share the round-robin request slot with
    activation reads. The side port is granted whenever the main port is
    not using the same 8 KiB macro; model writes mark the store dirty and
    fall back to the shared path until it is idle.
    Offline evaluation vs origin/main 81876b3 (simulation only, not an
    official result): regression 98/98, limits 40/40, ext 36/36, fuzz 80/80
    bit-exact, deploy envelope unchanged; 7 packaged models 1.104x total on
    FPGA memory mode and 1.147x on ASIC mode, outputs identical.
    FPGA 50 MHz timing has not been re-closed; can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
2026-11-09 Add always-on protocol checker and functional coverage to the program testbench
    npu_protocol_checker runs in every tb_npu_program simulation (native and
    JTAG, all memory configurations): X on control, model-read ordering,
    bound and drain, activation traffic outside the model image, side-port
    macro exclusivity, queue bounds, and the A2 weight-queue credit. Named
    COVER bins are printed on PASS for coverage export.
2026-11-09 Add shared-store random soak and CDC limit sweep
    - tb_npu_shared_stress: concurrent model side-port reads, activation reads
    (any alignment, response backpressure) and masked writes against a nibble
    scoreboard with read-before-write ordering, image rewrites between phases,
    starvation bound; runs in every regression at 8192/4096/64-byte images so
    side-port bank conflicts are exercised in all memory configurations.
    - tb_npu_jtag_cdc_limits + run_cdc_limits: system clock 10-200 MHz x TCK
    200 kHz-200 MHz, per-edge jitter, late-resolving synchronizers, random
    sub-cycle async resets, backpressure; measures bundled-data margin per
    direction against the max-delay bound.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
2026-11-09 Verification gate workflow; CDC mutants and strict survivor check
    Runs on perf/**, power/**, verify/** pushes: tooling tests, regression in
    behavioral/fpga_mem/ra1shd, CDC benches and limit sweep, one job per
    mutant (--strict: only documented static-CDC-class survivors allowed),
    and the evaluation export for the dashboard.
2026-11-09 R1: wavefront clock enables in the MAC array; tighten store and CDC benches
    MAC array: every operand, partial-sum, row-skew and deskew register loads
    only on the edge its own issue reaches it (wave[r+c], wave[d],
    wave[ROWS+c+d]); pipeline control holds while no issue is in flight.
    Results and cycle counts are bit-identical to the always-clocked array
    (7 smoke cases, FPGA_MEM). Program TB prints a POWER proxy
    (PE register clock events gated vs ungated): ECG -67%, KWS-M -47%,
    MNIST -49%. Real power remains UNKNOWN until SAIF + PrimeTime PX.
    Mutation: R1 mutants r01-r04 (all killed by the MAC block bench);
    m08/m13 recorded as justified equivalent survivors.
    Shared-store stress: side-read bloc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
2026-11-10 Validate integrated NPU candidates and harden mutation process cleanup
    Record behavioral/FPGA/macro regressions, gather and fuzz suites, CDC sweeps, and strict mutation results. Programs run before long block benches when explicitly requested for mutation testing; timed-out simulator process groups are fully cleaned up.
    Retain timing and board qualification of 81876b3 as historical. Integrated model cycles improve in RTL simulation, but a new physical implementation is still required.
2026-11-10 Adapt ASIC placement to ABI 5 shared SRAM banks
    Resolve explicit bank roles while retaining legacy store names, and reject unknown or ambiguous banks. Support importing a completed native synthesis handoff with matching RTL, libraries, clocks, CDC and artifact hashes when only downstream drivers change.
    Validated with 39 local flow tests; physical acceptance remains pending the new server run.
2026-11-10 Batch the JTAG mailbox handshake and archive board run artefacts
    Run the scan/poll handshake inside a single OpenOCD call so an RPC
    timeout can no longer silently replay a command that already executed,
    and add an infer-many CLI path for multi-input batches. Checked-in
    FPGA fit, NPU gather/performance/timing and remote board outputs keep the
    2026-11 evidence next to the code that produced it.
2026-11-10 Record Lab 5 EDA environment smoke results
    Log the Innovus, Virtuoso, Xcelium and v2lvs probes together with the
    production RTL hashes so the 2026-11-10 toolchain preflight is auditable.
2026-11-10 Archive ABI 5 synthesis area reports and die-budget analysis
    Record completed Genus mapping, TT timing, exact synthesis CDC paths, source and handoff hashes, and register-level area breakdown. Document the 1.799 mm2 standard-cell area and 21.34% minimum reduction required by the current 1.95 mm die cap. Keep the unqualified area-optimization RTL out of this report commit.
2026-11-10 Reduce NPU lookup area and archive routed CDC/SDF validation
    Keep ABI 5.0 and the 8x8 array while sizing tensor provenance records exactly. Add opt-in ASIC ICG synthesis, bracket-safe SRAM placement, bounded signal DRC repair and strict hierarchical CDC capture resolution.
    Archive synthesis, regression, routed ECO and SDF evidence: standard-cell synthesis area -22.48%, 1.9404 mm die, setup/hold +0.487/+0.050 ns. All 247 regression cases retain cycles/counters; 44 flow tests pass. Final Calibre, multi-corner, DFT and manual signoff remain pending.
2026-11-13 更新了demo plan，写于文档中
2026-11-13 实现手写数字识别与统一 Demo 入口
2026-11-13 实现语音关键词识别 Demo 并补充运行依赖
